fmaleev/RC-Foiling-Cat/paper/RC_Catamaran_Paper.pdf

# Design and Analysis of a 1 m RC Beach Catamaran with a Hydrofoil Option

### Filip Maleev

Colorado College, Department of Mathematics and Computer Science

### September 2026

## Abstract

This paper describes the design of a 1 m radio-controlled catamaran with a beach-cat rig, two appendage configurations (daggerboards, or L-foils with T-foil rudder elevators), and a simplified 0.6 m version intended as a first build. The hulls are 3D-printed PETG shells with bonded bulkheads, so every printed segment is a sealed compartment. The rig follows full-size beach cats: a square-top, fully battened main on a rotating wing mast, and a jib on a forestay bridle. It is modelled parametrically in Autodesk Fusion, and a custom add-in trims it with three sliders (jib sheet, main traveler, mainsheet tension). Performance is estimated with a purpose-written velocity prediction program. It combines ITTC-57 friction, Michell thin-ship wave resistance with catamaran interference (validated on the Wigley hull), appendage and foil drag, and a depowering sail model. The displacement version reaches 2.6 m/s on a beam reach in 8 kn of wind. Its rudders need at most 2.6◦ of an available ±18◦
. The
foiling version reaches its 1.81 m/s take-off speed from about 7.1 kn of true wind, and a sensitivity study places take-off between 6.25 and 11 kn. A controllability analysis shows that the foiling version is pitch-stable but has no heave stability with fixed-incidence foils: at 4 m/s the foils lift 120 % more than the boat’s weight. It therefore needs ride-height control. A wand-driven trailing-edge flap is sized here: it makes heave stable and well damped (ζ = 1.6) while using at most 10.2◦ of flap from takeoff to 5 m/s. This result led to building the non-foiling version first, preceded by a costed 0.6 m version ($248.26 in parts). A flight simulator built on the same physics, extended with the boat’s trim in heave and pitch, then searched 306,180 foil designs. At speed the sail drive’s bow-down couple makes the elevators push down. With a fixed positive incidence they do so by pitching the boat nose-down until they leave the water, so neither the original foils nor a first optimized set would fly. The adopted v2.3 foils set the elevators at −0.5
- and 18 mm lower, and
reach 4.53 m/s on a beam reach in 12 kn of wind with the boat level.


Figure 1: The 1 m design in Autodesk Fusion: build-first version with daggerboards (left) and foiling version with the v2.3 L-foils and T-foil rudders (right).

## 1 Introduction

Beach catamarans such as the Hobie 16 and the Olympic Nacra 17 combine two slender hulls, a large, fully battened rig and, on the Nacra 17, foils that lift the boat clear of the water. The goal of this project was a radio-controlled model that is faithful to that type, can be built with a desktop 3D printer and off-the-shelf RC parts, and whose behaviour can be predicted before it is built. Three questions shaped the work: (i) how closely can a 1 m model follow full-scale rig proportions; (ii) will the foiling version actually take off before it has to be depowered; (iii) will the boat be controllable. The answers set the build order: a 0.6 m simplified version first, then the 1 m displacement version, with foiling deferred until ride-height control is designed.

## 2 Design

### 2.1 Hulls and structure

Each hull is lofted through eight elliptical stations (Fig. 2, right). It is 1000 mm long, at most 80 mm wide and 108 mm deep, and the hull centres are 560 mm apart. The printed hull is a 0.8 mm PETG shell. Before shelling, 2 mm slabs are cut from the solid loft at each print joint and bonded back in as bulkheads, so each 200 mm segment prints as its own sealed compartment. Enclosed crossbeam sockets, foil trunks and chainplate bosses are part of the shell. The analytic hull volume from the sta-

Table 1: Rig proportions.

| Hobie 16 | Nacra 17 | This boat
Mast height / LOA | 1.60 | 1.71 | 1.37
Main : jib area | 2.7 | 3.7 | 3.2
Sail area / LOA² | 0.74 | 0.68 | 0.40

tion table matches the CAD loft to within 0.20 %.

### 2.2 Rig: following real beach cats

Table 1 compares the rig with the Hobie 16 and Nacra 17 [1, 2]. The main-to-jib ratio (3.2) lies between the two, and the planform follows their square-top main with 8 full-length battens. The rest also comes from the full-size boats: a rotating wing mast (24 x 14 mm fairing on a 12 mm carbon tube), a forestay bridle to both bows, a traveler on the rear beam, and a jib car on a short track (on the pod lid here, because the pod sits over the front beam). All the fittings are printed: transom gudgeons, Trail tracks with sliding cars, a hounds collar whose groove carries the loop the stays tie to (so the mast turns inside it), a mast cap that seals the tube, a bridle post and a gooseneck. The fairing is printed as 0.45 mm shells in seven pieces, and the main’s luff is laced to its trailing edge. Sail area and mast height, however, cannot follow geometric scaling. For a scale factor λ, righting moment scales as λ

4
(weight λ

3
times beam λ). In the same wind, the heeling moment of a similar rig scales only as λ
| | | 3
(area
λ

2
times height λ). A 1:5 model with full-scale proportions would therefore be over-canvassed, so sail area was set by the VPP instead (Section 4).
The three real-cat controls map to three RC channels and to three sliders in a Fusion add-in written for this project. Jib sheet sets the jib angle. Main traveler sets the boom angle and moves the traveler car. Mainsheet tension sets the main’s twist, from 30◦
loose to 3
- hard,
and its depth, from 13 % to 8 %. The sails and wing mast are loft and extrude features on batten-station sketches. The add-in moves the sketch points, so the parametric model re-solves; booms, sheets and cars are updated as base-feature bodies.

### 2.3 Appendages and foils

The rudders are balanced NACA 0012 blades (45 mm chord, pivot at 25 % chord) linked by a tie bar. The build-first version has NACA 0012 daggerboards; the foiling version replaces them with L-foils: a NACA 0012 strut (60 mm chord) and a NACA 4412 wing (50 mm chord, 180 mm span per side) at 1.5◦
incidence. Rudder T-foil
elevators (NACA 0012, 28 mm chord, 160 mm span) sit at −0.5

◦
. The foiling rudders are 18 mm longer than the build-first ones, so the elevators sit at z = −215 mm. These are the v2.3 foils chosen with the flight simulator (Section 6). They replace the original v2.0 set (wings

200 x 60 mm at 2

◦
, elevators 150 x 36 mm at 3

◦
), a first optimized set (v2.1) that the trim model showed would not fly, and v2.2 (wings 160 x 45 mm, elevators 120 x 28 mm at −1

◦
), which lost its pitch static margin when the CAD masses were corrected. Every result in this paper is for v2.3 unless stated otherwise. An early layout placed the main foils 100 mm deeper than the elevators. Because the elevators would breach first, that extra depth added weight and drag but no ride height, so the wings were moved up to the elevator depth, saving 73 g of carbon.

## 3 Analysis methods

### 3.1 Mass properties and hydrostatics

Masses come from the CAD volumes, with densities or manufacturer weights for bought parts; assumptions are listed in the project README. Displacement and the centre of buoyancy are integrated over the station table with a natural cubic spline, and the flooded foil trunks are subtracted.

### 3.2 Resistance

Hull friction uses the ITTC-57 line with a form factor (1 + k) = 1.25:

RF =

1/2 ρV ²S CF (1 + k), CF =

0.075
(log10 Re − 2)²

. (1)

Wave resistance uses Michell’s thin-ship integral [3, 4, 5] for a hull with half-breadth Y (x, z):

RW =

4ρg²
πU²

∫ ∞

1

(
I

2 + J

2

) λ
2 Fc(λ)
√
λ² − 1

dλ, (2)

I +iJ =

∫ ∫ ∂Y
∂x e

λ

2k0z
e

iλk0x

dx dz, k0 = g/U²
, (3)

where Fc = 4 cos²

(
k0λ

√
λ² − 1 s/2

)
accounts for interference between hulls a distance s apart (Fc = 1 for a single hull). The substitution λ = cosh u removes the endpoint singularity. ∂Y /∂x is taken as constant on each panel, and the exponential factors are integrated exactly in x and z (a Filon-type rule), which keeps the integral accurate at low Froude numbers. The integration was checked on the Wigley parabolic hull (L/B = 10, L/T = 16, Fig. 3): doubling the grid changes CW by less than 0.03 %, and the curve shows the expected humpand-hollow shape. Thin-ship theory is reported to overpredict near the main hump [4], so wave drag here is, if anything, pessimistic. A transom term follows Holtrop and Mennen [6]. Wave resistance, wetted area, waterline length and draft are tabulated once for each hull shape, over the load the hulls carry (0–3.6 kg in 0.2 kg steps) and the speed (0.1–4.5 m/s in 0.1 m/s steps), for both hulls together and for one hull. The VPP and the flight simulator interpolate the same table; against direct

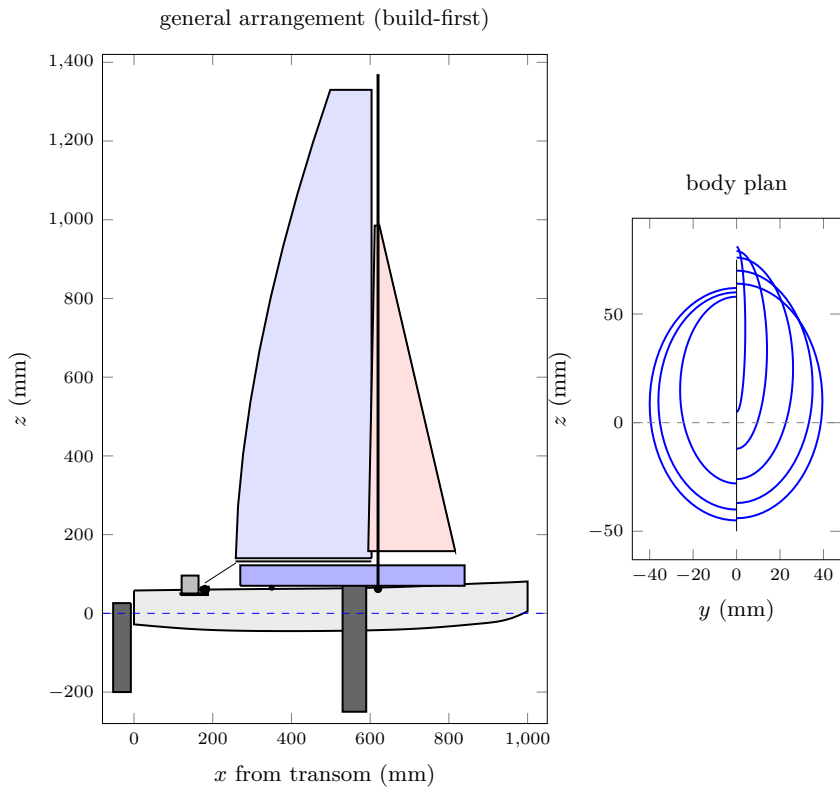
[picture p6: figure]
x from transom (mm); general arrangement (build-first); body plan

Figure 2: Left: general arrangement of the 1 m build-first boat (hull, the three crossbeams, pod, rudder-servo bracket and cover on the rear beam, daggerboard, rudder, rotating mast, boom and mainsheet to the traveler, square-top main and jib; dashed line: reference waterline). Right: body plan of the hull, eight elliptical stations (aft half on the left, forward half on the right).

evaluation, the interpolated hull drag differs by less than
1 %. Appendage profile drag uses the ITTC line with Hoerner’s thickness factor 1 + 2t/c + 60(t/c)

4 and a spray
term 0.24 q t²
[7]. The ITTC line assumes turbulent flow from the leading edge. At the foils’ chord Reynolds numbers (1–2 × 10⁵
) much of the flow may be laminar, so a sensitivity case replaces it with the flat-plate laminar line CF = 1.328/

√
Re (Prandtl–Schlichting with transition above Re = 5 × 10⁵
), about half the turbulent value. This is an optimistic bound: a laminar separation bubble adds drag that a flat plate does not have. Induced drag is Di = L

2/(qπeb²
), applied both to foil lift and to the side force carried by boards and rudders.

### 3.3 Foils and sails

Foil lift uses the thin-airfoil zero-lift angle, αL0 =
−

1
π

∫ π

0

dyc
dx (cos θ − 1) dθ = −4.15◦
for NACA 4412, and
the lifting-line slope a = 2π/(1 + 2/(e AR)) with e = 0.85 [8]. The sails produce Fx = qaA(CL sin β − CD cos β) (drive) and Fy = qaA(CL cos β + CD sin β) (heel), with CD = CD0 + C

2
L

/(πesARs), CL,max = 1.3 and CD0 =
0.05. CL is reduced (the sails are flattened) whenever Fyh would exceed 90 % of the maximum righting moment
0.2 | 0.3 | 0.4 | 0.5 | 0.6

0

2

4

Froude number F n

10

3 C

W

Figure 3: Michell wave-resistance coefficient of the Wigley hull from this project’s code (grid-converged to 0.03 %).

W s/2. The sails are also eased (both forces scaled down) whenever the bow-down moment Fxhp would exceed 90 % of the largest longitudinal righting moment the hulls can provide (Section 4.4); hp is measured from the centre of effort to the hull resistance centre. Beyond a beam reach the model blends to a stalled sail (CD → 1.2). The VPP marches boat speed up from rest until drive equals drag; for the foiling version it switches to the flying branch once both foils can carry their share of the weight. Below takeoff the wand holds the flaps fully down, so the main foils’ lift (and its induced drag) uses the full 15◦ of flap (Section 5). Every foil lift coefficient is capped at 0.8, i.e. 0.8 of an assumed section maximum of 1.0 near Re = 10⁵ .

### 3.4 Flying trim in heave and pitch

Once flying, the foils must carry the weight and also balance the pitching moment. The sail drive F equals the flying drag. It acts at the sail centre of effort, while the drag acts at the appendages, so the boat feels a bow-down couple M = F (zCE − zD), with zD the drag-weighted height of the appendage forces. Moment balance about the centre of gravity gives the foil loads

Le =

W a − M
a + c
, | Lm = W − Le, | (4)

where a and c are the distances from the CG to the main-foil and elevator quarter chords. The couple moves load from the elevators to the main foils, and at speed the elevators must push down. The fixed-incidence elevators then set the pitch, θ = Le/(qSeae) − ie, and the wand-driven flaps make up the main foils’ lift. The wand is hinged at the bow with its tip on the water, and its angle is read in the boat frame, so the bow height is hp = Lsin(ϕ0−δ/G−θ). The depth of every appendage follows from hp and θ, and the strut and rudder drag use those immersed lengths. A speed belongs to the flying range when:
- both foils stay within the usable lift coefficient and the flaps within ±15◦
;
- the main foils and elevators stay at least half a chord deep;
- at least 30 mm of rudder stays in the water (an assumed immersion limit);
- the rudders, at their trimmed immersion, can hold the largest side force the sails can apply before the boat heels out, using at most 80 % of their ±18◦ throw (the reserve is assumed);
- the hulls stay clear.
Take-off is the lowest such speed. Above the range the sails must be eased, and the VPP caps the speed there. Roll. Flying, the boat resists heel only by moving lift to the leeward foil. With the leeward wing at its flap and lift limit L1 and the windward one carrying the rest of Lm, the foils’ largest righting moment is RMf = (2L1 − Lm) s/2. At the take-off speed both wings are at that limit, so RMf = 0; it reaches W s/2 only as speed builds. Any larger heeling moment M is taken by the leeward hull, which then carries N = (M − RMf )/s and adds its single-hull resistance (friction, transom and Michell wave drag for one hull). The boat counts as flying only when N = 0; otherwise it is skimming. While skimming, the VPP also eases the sails (scales their lift down) whenever that gives more net thrust, as a sailor would to get onto the foils.

Table 2: Mass properties and hydrostatics.

| 1 m build-first | 1 m foiling | 0.6 m mini
Mass (g) | 2114 | 2373 | 755
Hull draft (mm) | 29.3 | 30.8 | 23.8
LCG / LCB (mm) | 450 / 432 | 454 / 433 | 258 / 262
One-hull buoyancy / weight | 2.64 | 2.35 | 2.05
Max righting moment (N m) | 5.81 | 6.52 | 1.26
Sail area (m²
) | 0.401 | 0.401 | 0.144
0 | 0.5 | 1 | 1.5 | 2 | 2.5 | 3

0

2

4

6

Boat speed V (m/s)

Resistance (N)

build-first (total)

foiling (total)

build-first wave | (Michell)
build-first hull | friction

Figure 4: Resistance at zero side force. The foiling curve peaks just before take-off (1.81 m/s) and drops once the hulls leave the water.

### 3.5 Controllability

Steady yaw balance requires the rudders to cancel M = Fy(xCE − xCLR) + Rhull u s/2, where u is the fraction of righting moment in use; the second term is the extra drag of the loaded leeward hull. The rudder force Fr = M/(xCLR − xr) is converted to a rudder angle with the lifting-line slope, and the windward rudder is taken as clear of the water for u > 0.8. Foil pitch stability uses the neutral point xnp = (amSmxm + ηaeSexe)/(amSm + ηaeSe) with η = 1 or 0.65 to bracket downwash on the elevators.

## 4 Results

### 4.1 Mass and hydrostatics

Table 2 lists the three boats. The heaviest items on the 1 m build-first boat are the hulls (783 g), the centre pod (336 g) and the RC electronics (315 g); the foiling kit adds 422 g. The design target was that one hull alone could float at least twice the boat’s weight; all three versions meet it.

### 4.2 Resistance and speed

Figures 4 and 5 show the predicted resistance and speed. Hull friction and appendage drag dominate the build-first boat; Michell wave drag stays below 0.43 N up to 3 m/s because the hulls are slender (L/B = 12.5). Below takeoff, the foils cost the foiling version 28–31 % of its speed. The foiling version takes off from about 7.1 kn of true

4 | 6 | 8 | 10 | 12 | 14 | 16

0

2

4

True wind speed (kn)

Boat speed (m/s)

build-first, TWA 90◦

build-first, TWA 60◦

foiling, TWA 90◦

foiling, TWA 60◦

Figure 5: Predicted boat speed. The jump in the foiling curves is take-off. The build-first boat must depower above about 8– 9 kn.

Table 3: Take-off speed and the lowest true wind (kn) at which the foiling version takes off.

Scenario | Vto (m/s) | TWA 60◦ | TWA 90◦
baseline | 1.81 | 9 | 7.25
sail CLmax 1.1 | 1.81 | 9 | 7.75
sail CLmax 1.5 | 1.81 | 9 | 6.75
foil lift -20% (low Re, free surface) | 1.94 | 10.5 | 7.25
mass +10% | 1.90 | 9.5 | 7.5
mass -10% | 1.72 | 8.75 | 7
sail-drive pitch couple x0.5 | 1.71 | 8.25 | 7
sail-drive pitch couple x1.5 | 2.00 | 11 | 7.5
foil friction laminar (low Re) | 1.76 | 7.25 | 6.25

wind, which is below the 8–9 kn where the rig starts to depower, so a usable foiling window exists. Table 3 shows that this conclusion holds across the least certain inputs.

### 4.3 Controllability

Build-first version. Over 4–14 kn and TWA 60–105◦ the rudders need at most 2.6◦

(TWA 60◦
, 8 kn, one rudder
working) of the ±18◦
that the linkage gives. That leaves at least 77 % margin to stall, and the servo torque needed is below 0.10 kg cm.
Foiling version. Steering while flying needs at most 4.8◦
, with 63 mm of rudder immersed in that case (from the flying trim). The foil system is statically pitch-stable: the CG lies 41–97 mm ahead of the neutral point. Heave is the problem (Fig. 6). With fixed incidence, lift grows as V

2 while weight is constant, so nothing sets the flying height: the boat would climb until a foil breaches and ventilates, then drop. Holding height requires the main-foil angle to change by +2.1◦ at 2 m/s but -3.7◦ at 4 m/s. If the boat is also free to pitch, the fixed-incidence elevators trim it nose-down as speed rises. That reduces the excess but does not remove it, and nothing still ties lift to height, so heave stays neutral. Ride-height control is therefore required before the foiling version can fly under control (Section 5).

2 | 2.5 | 3 | 3.5 | 4

−50

0

50

100

Boat speed (m/s)

Lift excess over weight (%)

−4

−2

0

2
Foil angle change (

◦

)

Figure 6: Fixed-incidence foils: lift in excess of weight (solid, left axis) and the main-foil angle change needed to hold height (dashed, right axis).

Table 4: Bow-volume variants of the 1 m hull (B adopted as v1.3). Pitchpole limits in kn at TWA 60/90/120◦
Variant | RML 1 hull (N m) | RML 2 hulls (N m) | Drag at 2 m/s (N) | ∆m (g) | Pitchpole (kn)
baseline | 2.92 | 4.29 | 3.514 | +0 | 9.5 / 9 / 10.5
A | 3.12 | 4.32 | 3.517 | +7 | 10.5 / 9 / 11
B | 3.59 | 4.72 | 3.527 | +13 | >20 / 9 / 11
C | 3.96 | 4.90 | 3.535 | +20 | >20 / 9 / 11.5

### 4.4 Static stability and pitchpole

Heel. The transverse righting arm (Fig. 7) comes from clipping the heeled elliptical sections of both hulls at the waterline, with the waterline height solved so displacement equals weight. The 1 m build-first boat reaches its largest righting arm, 270 mm, at 6◦ of heel, when the windward hull lifts. The maximum righting moment, 5.59 N m, is within 4 % of the W s/2 used in the VPP, which confirms that assumption. The boat capsizes at about 80◦

(mini: 80◦
).
Pitchpole. A catamaran more often trips over its bows than capsizes sideways. Tilting the waterline bow-down and re-solving the sinkage gives the largest longitudinal righting moment the hulls can provide before the bows go under: 5.04 N m on both hulls and 3.85 N m on one hull (the windward hull flying). Setting that equal to the sails’ bow-down moment gives the wind above which the sails must be eased on each point of sail. For the 1 m boat that is >20 / 9.5 / 11.5 / 16.5 kn at TWA 60/90/120/150◦
, and
for the mini 7.5 / 8.5 / 10 / 13.5 kn. These limits sit close to the heel limits, so pitch-limited depowering was added to the VPP.
Design iteration: bow volume. Table 4 compares the original hull with three variants that add volume only to the forward stations, mostly above the waterline. Variant B was adopted as the v1.3 hull. It raises the one-hull pitch limit by 23 % for 13 g and a 0.4 % drag increase at 2 m/s. Variant C adds little more for 50 % more weight.

### 4.5 Foil structure

With the largest main-foil flight load, which occurs at speed when the elevators push down, all on one wing

0 | 20 | 40 | 60 | 80

−100

0

100

200

Heel angle (◦
)

Righting arm GZ (mm)
1 m build-first

0.6 m mini

Figure 7: Transverse righting arm from the heeled hull geometry. It peaks when the windward hull lifts; the curve crosses zero at the capsize angle.

Table 5: L-foil structural check (v2.3 foils).

Material | Root stress | Tip deflection | Strut rotation
CFRP (E = 70 GPa) | 44.4 MPa | 1.52 mm | 1.00◦
Printed PETG (E = 2 GPa) | 44.4 MPa | 53.08 mm | 35.17◦

under a 2 g gust (68.7 N; root moment 6187 N mm), the section properties computed from the NACA coordinates give the results in Table 5. Printed PETG is strong enough but far too flexible, so the foils must be carbon. A home-buildable alternative to solid carbon is a printed core with unidirectional carbon caps (4 layers of 0.127 mm tape, 25 mm wide, on each face). Taking E ≈ 120 GPa for the cap laminate (assumed), centring the caps on the thickest point and ignoring the core, the caps give 59 % of the solid-carbon bending stiffness: tip deflection 2.55 mm and cap stress 125 MPa in the load case above. The v2 foiling kit (cores, carbon tape, laminating epoxy, flap hinges, wands and linkage) costs $101.17.

### 4.6 Rig and crossbeam loads

The largest steady side force the sails can apply is set by the righting moment, F = RMmax/h with h the heeling arm; beyond it the boat heels and sheds load. Carried by a mast pinned at the step and held by the windward shroud at the hounds, this force gives the shroud tension. The jib’s share (by area), on a forestay with an assumed 2 % sag, gives the forestay tension, and the vertical components of both compress the mast. A harder case is the sheet servo at its stall torque (spec-sheet values at 4.8 V), for example with the sheet held in against a stop. The mast is checked for Euler buckling between step and hounds. Each crossbeam is checked as a simply supported tube loaded at mid-span. On the 1 m boat the mainsheet runs from the traveler car up to the boom and back (the loop that keeps the traveler from pulling on it), so the boom, the car and the rear beam carry twice the tail tension. With the tail 15 mm from the servo shaft this failed the factor-of-2 rule (front beam 1.7, mast 2.0); the tail now attaches 25 mm from the shaft. The printed traveler car is checked the same way: its lips under the rail head bend as cantilevers, with an assumed 25 MPa bending strength for printed PETG. On the mini, the box levers the sheet load onto both beams. Table 6 lists the results. E = 70 GPa and a bending strength of 300 MPa are assumed for the carbon tubes, since no values are published for the tubes used.

Table 6: Rig and crossbeam loads (sails at the heel limit; “stall” adds the sheet servo at stall torque).

1 m build-first | Mini
Side force at the heel limit (N) | 8.3 | 2.9
Shroud / forestay tension (N) | 17 / 12 | 5.9 / 4.3
Mainsheet at servo stall (N) | 55 | 34
Mast compression, sailing / stall (N) | 28 / 138 | 10 / 44
Mast Euler load (N) / safety at stall | 423 / 3.1 | 107 / 2.4
Front beam: MPa / mm / safety | 116 / 5.4 / 2.6 | 54 / 1.5 / 5.6
Rear beam: MPa / mm / safety | 92 / 4.3 / 3.2 | 40 / 1.1 / 7.6
Traveler car on its rail: uplift (N) / safety | 110 / 3.2 | –
Pod beam, 5 g: MPa / mm / safety | 35 / 2.6 / 8.7 | –

The sailing loads are small: the sheet servos, not the wind, set the structural load case. With its first 8 x 7 mm beams (0.5 mm wall), the mini’s front beam reached a safety factor of only 2.0 in the stall case and deflected 5.2 mm. It now uses 10 x 8 mm tube, which costs $1.05 less, for 18 g more.

## 5 Ride-height control

Each L-foil wing gets a trailing-edge flap of 25 % chord (12 mm) from 10 mm inside the tip to the strut, 166 mm of the 180 mm span. A carbon wand hinged at each bow trails on the water and drives that hull’s flap through a deck pushrod, a bellcrank and a rod inside the strut. Each foil therefore regulates its own height, which also adds roll stability. Thin-airfoil theory gives the flap effectiveness

τ = 1 −

θh − sin θh
π
, | cos θh = 2E − 1, | (5)

so τ = 0.609 for E = 0.25; 0.487 is used after a 20 % viscous reduction. The wand is 300 mm long at 49◦
, so
its angle changes by 5.08 rad per metre of height. The linkage gearing is 1.5◦ of flap per degree of wand.
Trim. At each speed the elevators set the pitch and the flaps make up the main foils’ lift, with the sail-drive couple included (Section 3.4). From take-off at 1.81 to 5.0 m/s the flap angle stays between −6.8
- and 10.2

◦
, inside the ±15◦
travel (Fig. 9). The boat pitches between −0.3
- and +0.4

◦
(nose up +), and the bow flies −26 to +16 mm from its design height.
Heave stability. Linearised heave dynamics are
mh¨ + c h˙ + k h = 0, | (6)

c =

q(Smam + Seae)
V
, | k = q Smam τ G dϕ
dh, | (7)

where c comes from the change of foil angle of attack with vertical velocity (h/V ˙ ) and k from the wand feedback. With fixed foils k = 0, so nothing restores height.

With the wand, k rises from 458 to 3174 N/m and the natural frequency from 2.2 to 5.8 Hz. Because c ∝ V and √
k ∝ V , the damping ratio is the same at every speed, ζ = 1.6 (over-damped): disturbances die out without oscillating. A time-domain run of the same model (analysis/foil_checks.py) confirms this: across the flying range a 20 mm height disturbance decays to 5 % in 0.24–0.62 s with no overshoot, while with fixed foils it does not decay at all. The same script checks the trim over the flying range up to the 12 kn beam-reach speed: the elevators stay at least 1.55 chords deep, the main foils 1.02 chords, and at least 46 mm of rudder stays in the water. At take-off, with the flaps fully down, the main foils need CL = 0.80. 28 of 28 foil checks pass.
Heave and pitch together. The wand sits a metre ahead of the elevators, so heave and pitch are coupled: the wand reads the bow height and the boat-frame angle, and each foil feels the vertical velocity of its own station, h˙ + l

˙θ. Linearising both degrees of freedom about the trim, with the pitch inertia from the CAD model (Iyy = 0.243 kg m²
, radius of gyration 320 mm), gives a fourthorder system (analysis/pitch_heave.py). Across the flying range it is stable (Routh–Hurwitz), with one oscillating mode at 1.6–7.0 Hz and damping ratio at least 0.69 (0.66 with an elevator efficiency of 0.65), and two nonoscillating decaying modes. That is less damping than the heave-only estimate (ζ = 1.56), but the motion stays well damped. With fixed foils one root sits at zero: heave stays neutral. Unsteady lift, added mass and downwash lag are left out.
Take-off in time. | The trims above are equilib-
ria. | The transition was also integrated in time
(analysis/takeoff_sim.py): surge, heave and pitch with RK4 in 2 ms steps, hull buoyancy from the stations at the instantaneous attitude, the wand and flap stops, foil lift fading over the last half chord below the surface, and sail drive from the VPP (the boat is held flat). From rest in 8 kn on a beam reach the hulls leave the water after 2.4 s. The bow then rises at most 11 mm above its design height, the elevators stay at least 48 mm deep, and the boat settles at 3.72 m/s, matching the VPP’s steady speed (Fig. 8). A 4 kn gust for 5 s while flying in 9 kn raises the bow at most 16 mm and leaves the elevators at least 41 mm deep; no foil breaches. Hull damping when afloat is an assumed 30 % of critical; it only affects the hull-borne phase.

## 6 Foil design with the flight simulator

The VPP answers whether a given design flies; to ask which foils fly best, it was turned into an interactive flight simulator (a web page, sim/foil_sim.html). Its physics are the VPP’s, including the flying trim of Section 3.4: the Michell wave resistance is tabulated against boat speed and the weight the hulls carry, and every other

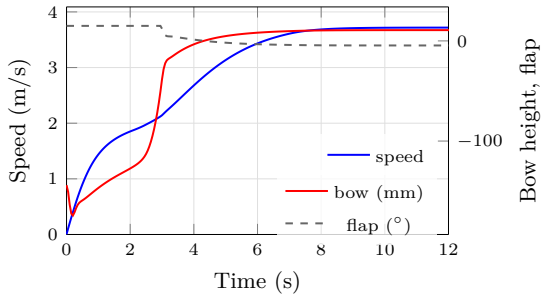
[picture p7: figure]
Time (s); Speed (m/s); speed; bow (mm) flap; Bow height, flap

Figure 8: Take-off from rest in 8 kn on a beam reach (time-domain simulation): boat speed, bow height relative to the design ride height, and flap angle. The flaps sit on their +15◦ stops until the boat rises.

2 | 2.5 | 3 | 3.5 | 4 | 4.5 | 5

−5

0

5

10

Boat speed (m/s)

Angle (

◦

)

flap angle

boat pitch

Figure 9: Wand-controlled flight across the flying range: flap angle and boat pitch from the trim of Section 3.4, sail-drive couple included. Flap travel is ±15◦

term is computed live. At the CAD design it reproduces the Python VPP’s boat speed to 0.00 m/s in all 12 reference cases (build-first and foiling, 6–10 kn, 60 and 90◦ ).
It adds:
- foil span, chord and incidence, and the elevator height, as inputs;
- foil and rudder mass and the resulting shift of the centre of gravity, with the densities of the CAD mass export;
- the wand-driven flaps: fully down below take-off (they add induced drag there), then trimmed to hold ride height;
- a cap on the usable foil lift coefficient of 0.8 (0.8 of an assumed section maximum of 1.0 near Re = 10⁵ ).

A first search, and why it was withdrawn. A first search was run before the trim model existed. It assumed each foil pair carried a fixed share of the weight at level attitude, so the elevators set the take-off speed. It recommended smaller foils with the elevators at 4

◦
(v2.1: wings
160 x 40 mm at 0

◦
, elevators 140 x 32 mm at 4

◦
), and these
were drawn in CAD. The trim model reverses that result. At 4.5 m/s the v2.3 foils must balance a 6.0 N m bow-down couple, more than the elevators’ share of the weight times

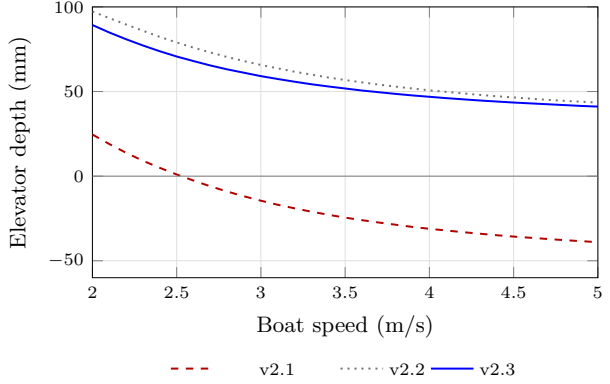
[picture p8: figure]
Boat speed (m/s); Elevator depth (mm)

water surface

Figure 10: Elevator depth from the flying trim, sail-drive couple included. The v2.1 elevators at +4◦ pitch the boat nose-down and come out of the water; the v2.3 elevators at −0.5

◦
,
18 mm lower, stay in. (The v2.1 curve is shown where no feasible trim exists, to show why.)

the foil spacing, so the elevators must push down. Fixed at +4◦
, they can only do that by pitching the whole boat nose-down. The stern, a metre behind the wand that holds the bow, then rises until the elevators leave the water: for v2.1 the elevator reaches the surface at 2.6 m/s (Fig. 10). Neither the original v2.0 foils nor v2.1 has any speed at which the trim is feasible: as drawn, they would not fly.
The search with the trim model. The search was repeated with the trim model and with the elevator height as a variable (the rudder blades end 3 mm below the elevators). A grid of 306,180 designs covered:
- main-foil span 140–300 mm and chord 40–80 mm, at 0, 1 or 2◦
;
- elevator span 100–260 mm and chord 28–52 mm, at 0–2◦
;
- elevator height z = −215 to −275 mm (the v2.1 elevators sit at −197 mm).

Incidences from −1 to 3

- and the height were then refined for the best sizes. A design counts as feasible when:
- root stress with the largest flight load of a foil pair on one foil at 2 g stays within 100 MPa (safety 3 on an assumed 300 MPa), and main-foil tip deflection within 2 mm;
- both foils see a chord Reynolds number of at least 5× 10⁴ at take-off (an assumed threshold, below which thin-airfoil lift is optimistic);
- heave damping with the wand gearing of Section 5 is at least ζ = 0.5;
- the pitch static margin is at least 30 mm with an elevator efficiency of 0.65 (about 5 % of the 590 mm foil spacing, assumed);
- the boat flies at 12 kn on a beam reach, with the flying range reaching at least 5 % above that speed. Feasible designs tended to sit on these limits. Nose-down pitch lifts the rudders and struts out of the water and cuts their drag, which the model rewards and a gust would punish. The adopted design therefore also needs operating margins at the 12 kn speed: main foils and elevators at least one chord deep, at least 45 mm of rudder in the water, and a flying range reaching 10 % above that speed. It must also be robust: it must still fly, without hitting the top of the flying range at 12 kn, with the sail-drive couple halved or 1.5 times larger and with the CG 20 mm forward or aft. Of 78,717 feasible designs, 12,340 had the margins and 11,645 were also robust. Among robust designs within 5 % of the fastest, the rule picks the one needing the least wind to fly, averaged over 60 and 90◦ .
The design in CAD stays adopted while it passes every check and needs at most 0.1 kn more wind than the rule’s pick. That tolerance is below the model’s resolution (see below), and in this run the difference is +0.00 kn.
v2.3. The foils first adopted from this search (v2.2: wings 160 x 45 mm at +1.5

◦
, elevators 120 x 28 mm at −1

◦
) were
drawn in CAD. Correcting the CAD masses (the printed fittings and mast fairing, and music-wire rudder parts that had been weighed as aluminium) added 89 g and moved the centre of gravity about 7 mm aft. That cut v2.2’s pitch static margin to 24 mm, under the limit, and the rerun search picked larger foils. The adopted foils are wings of 180 x 50 mm at +1.5
- and elevators of
160 x 28 mm at −0.5

◦
, set 18 mm lower than before (Table 7). The negative elevator incidence is the key change. At 12 kn the elevators push down 5.8 N with the boat at −0.3
- of pitch, instead of pitching the boat nose-down to get there. In the simulator the boat takes off at 1.81 m/s, from 7.1 kn on a beam reach and 8.9 kn at 60◦
. It reaches
4.53 m/s at 12 kn, and its flying range extends to the end of the scan (6 m/s). The original v2.0 sizes cannot be re-trimmed into the feasible set: whatever the incidences and elevator height, their static margin is at most 23.0 mm, just under the 30 mm limit. The v2.1 sizes cannot be rescued. Once the elevators push down, the main foils carry the weight plus that downforce, and in 2577 of the 3213 re-trims tried the 40 mm-chord wing bends past the 2 mm limit.
The simulator interpolates the wave-resistance table, which smooths the drag hump just before take-off. Its take-off winds for v2.3 are therefore 0.02 and 0.01 kn below the VPP’s (7.11 and 8.95 kn at 90 and 60◦
). Once the
boat is flying the two agree. Roll near take-off. With the adopted foils the boat flies from 7.1 kn on a beam reach but needs 8.9 kn at 60◦
(simulator), because at takeoff both wings are at their lift limit and the larger side force has to go onto the leeward hull (Section 3.4). More flap travel does not help: with ±25◦

instead of ±15◦
the
take-off winds are unchanged, because the usable lift coefficient, not the flap stop, limits the leeward wing. What does help is technique. Taken off on a beam reach and

Table 7: Foil sets with the trim model (flight simulator, auto trim; take-off wind to 0.01 kn). v2.0 and v2.1 have no feasible flying trim; their speeds are hull-borne (h). v2.2 was built in CAD before the mass correction and now fails the static-margin limit; v2.3 is adopted and in CAD. The light-wind design needs the least wind among robust designs within 15 % of the fastest; the speed design is the fastest robust design.

| v2.0 (original) | v2.1 (first search) | v2.2 (before mass fix) | v2.3 (adopted) | Light-wind design | Speed design
Main foil, span x chord (mm), incidence | 200 x 60 at 2
- 160 x 40 at 0
- 160 x 45 at 1.5
| | | | ◦ 180 x 50 at 1.5 | ◦ 200 x 55 at 0
- 140 x 40 at 2

◦
Elevator, span x chord (mm), incidence | 150 x 36 at 3
- 140 x 32 at 4
- 120 x 28 at −1
| | | | ◦ 160 x 28 at −0.5 | ◦ 200 x 36 at 0
- 100 x 32 at 0.5

◦
Elevator height z (mm) | -197 | -197 | -210 | -215 | -215 | -235
Sailing mass (g) | 2453 | 2322 | 2331 | 2373 | 2446 | 2316
Take-off speed / flies to (m/s) | – | – | 2.02 / 6+ | 1.81 / 6+ | 1.69 / 6+ | 2.30 / 6+
Wind to fly at 90 / 60◦
(kn) | – | – | 7.30 / 10.69 | 7.09 / 8.94 | 7.06 / 8.63 | 7.64 / –
Speed at 8 / 12 kn, beam reach (m/s) | 2.83 h / 3.59 h | 3.15 h / 3.81 h | 3.87 / 4.71 | 3.71 / 4.53 | 3.31 / 4.25 | 4.01 / 4.91
At 12 kn: pitch, flap | – | – | +0.0

◦
| | | , −6.2
- −0.3

◦
| | | | , −6.1
- −0.6

◦
| | | | | , −2.5
- −1.5

◦
| | | | | | , −3.2

◦
At 12 kn: elev. / main / rudder depth (mm) | – | – | 44 / 54 / 47 | 43 / 51 / 46 | 43 / 55 / 46 | 44 / 44 / 47
Root stress main / elev. (MPa) | – | – | 50 / 44 | 44 / 71 | 41 / 54 | 59 / 20
Main tip deflection (mm) | – | – | 1.51 | 1.52 | 1.58 | 1.53
Static margin (mm), heave ζ | 23, 1.64 | 66, 1.48 | 24, 1.33 | 41, 1.56 | 69, 1.89 | 30, 1.21

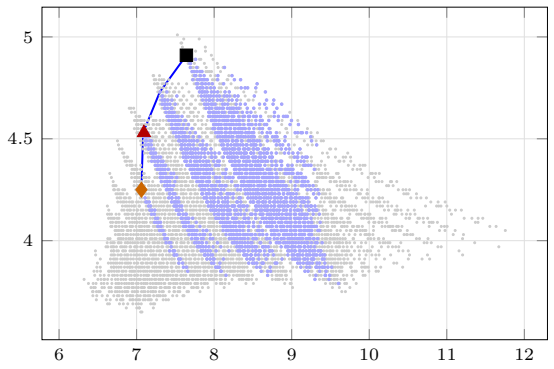
[picture p9: figure]

Wind needed to fly, beam reach (kn)

Boat speed at 12 kn (m/s)

feasible designs | robust, with margins
best robust trade-off | light-wind design
v2.3 (adopted) | speed design

Figure 11: Foil search with the trim model: every feasible design (grey), those with operating margins that are also robust (blue), and the best robust trade-off. Up and to the left is better. The adopted design also weighs the take-off wind at 60◦
, which this plot does not show.

then headed up, the boat stays flying at 60◦ down to 8.25 kn (sim/roll_options.js). At 45◦
it does not take
off below 25 kn, and once flying it cannot stay up below 16 kn.
As with the rest of the paper, these are model predictions. The drag model sets the size of the sail-drive couple, which is why the design must also work with the couple halved or 1.5 times larger (take-off at 1.71 and 2.00 m/s, flying to 6.00 and 6.00 m/s). With laminar foil friction, the optimistic bound on the drag, it takes off at 1.76 m/s and flies to 6.00 m/s. Lift near Re = 10⁵
, the
flap model and the wand gearing on the smaller foils are what the tow tests have to confirm, and the elevator incidence should be adjustable by at least ±1
- on the water.

## 7 Simplified 0.6 m version

Because the RC electronics do not shrink with the boat, geometric scaling would leave the small hulls overloaded. The mini therefore scales length by 0.6 but hull sections by 0.68, which brings one-hull buoyancy back to 2.05 times the 755 g sailing weight. One winch drives both sheets on a stepped drum. Its 30 mm and 16.2 mm grooves are sized so that the mainsheet (153 mm) and jib sheet (83 mm) reach full ease in the same 1.63 turns. The same analysis predicts 2.1 m/s on a beam reach in 8 kn of wind, and at most 1.6◦ of rudder needed. Parts cost $248.26 at September 2026 prices, with every price read from a retailer page. A build manual with 1:1 sail patterns accompanies this paper.

## 8 Design iterations driven by analysis

Several changes came directly from the checks above rather than from the first layout:

1. Foil depth. The main foils were raised 80 mm to the elevator depth, because the elevators breach first. This saved 73 g of carbon at no cost in ride height.
2. Mini hull sections. The mini’s section scale was raised from 0.65 to 0.68 so that one hull still floats at least twice the boat’s weight despite full-size electronics.
3. Stepped winch drum. The mini’s jib groove was reduced from 18 to 16.2 mm so both sheets reach full ease in the same number of turns.
4. Winch fit. The first-choice 3.5-turn winches are 50 mm tall and did not fit the 48.8 mm pod. A torque estimate showed standard-size 45 g winches carry the sheet loads with margin, which also saved 130 g and $92.
5. Bow volume. The pitchpole study led to the v1.3 hull (Table 4).

6. Pitch-limited depowering. Adding the bow limit to the VPP first produced a speed that fell as the wind rose. That was traced to the model switching to the one-hull limit, and fixed by letting the model choose, as a skipper would, between sailing flat and flying a hull.
7. Servo fit. Checking every mount against the manufacturers’ drawings found three misfits: the 40.5 mm winch cases did not fit between rails 40.2 mm apart (40 mm on the mini); the 1 m rails sat 3.5 mm below the FS5115M’s ears (27.3 mm above the case bottom); and the mini’s micro-servo rails sat 6 mm below the MG90S ear line. The rails were redrawn from the drawings with 0.3–0.4 mm clearance and a wire notch at each rail. Each winch now hangs in a 4– 6 mm well, so its drum clears the lid by 5.6–7.9 mm instead of 0.4 mm on the mini.
8. Mini crossbeams. The rig-load check (Section 4.6) replaced the mini’s 8 x 7 mm beams with 10 x 8 mm tube.
9. Rig clearance. A clearance sweep of the Fusion model over nine trims (boom and jib from 0/5◦ to
40/40◦
) showed that the original pod, which ran over both beams, blocked the traveler car for boom angles below about 7.5◦
. In that range the mainsheet from the clew (259 mm from the transom) to the car also passed through the pod lid, and the jib car sat inside the pod. The pod now ends 11 mm forward of the clew. Its aft end first hung on a printed cradle under the rear beam, but a load check showed that a cradle under the beam can only hold the pod down, not up. The aft end now rests on a light third crossbeam: 10 mm carbon, cut from the tube already bought for the mast joiner, at 350 mm from the transom, where no mainsheet position reaches. The rudder servo sits aft of the rear beam on a printed bracket, under a cover. The bracket clamps the beam from below, so the car can cross the centreline, and the jib track moved onto the lid. The same interference check found the tiller arms and ride-height wands rubbing the hulls. The tiller arms are now level, and the wands hinge ahead of the stems. The sweep is now clear at all nine trims.
10. Pitch trim (v2.2 foils). A first simulator search (v2.1) picked smaller foils with 4

◦
elevators. Adding
the trim in heave and pitch (Section 3.4) showed that the sail drive’s couple makes the elevators push down at speed, and that fixed positive-incidence elevators then pitch the boat nose-down until they leave the water: neither v2.0 nor v2.1 would fly. The search was repeated with the elevator height as a variable, a pitch static-margin limit, operating margins and robustness checks. The v2.2 foils adopted then had the elevators at −1

◦
, 13 mm lower on slightly longer rudders, and flew level at 12 kn; the mass correction below replaced them.
11. Clearance over the full trim range. A second sweep, with the printed gooseneck turning with the wing and the boom end with the boom, found two problems. A boom-end fork reaching below the boom would hit the jib car with the main eased and the jib sheeted in, so the fork moved to the gooseneck and the boom end became a single tongue. Separately, with the jib sheeted fully in (5

◦
) and the main eased
past about 31◦
, the jib sheet crosses the boom itself; the manual says to ease the jib first.
12. Print size. Every part now fits a 220 x 220 mm bed, and a design rule checks it. The pod prints in four pieces, and the daggerboards and L-foil cores in two, joined inside the hull trunks where the trunk carries most of the load. Two 1.2 mm carbon rods bonded across the daggerboard joint give 10 times the joint moment at the heel limit; on the foils, the carbon caps run across the joint.
13. Fittings and masses. Designing the printed fittings and the mast fairing replaced placeholder blocks and assumed masses. The fairing, gooseneck and boom jaw weigh 45 g, where 10 g had been assumed for the fairing. The rudder stocks, tiller arms, tie bar and pushrod had been weighed as aluminium, but they are music wire (the steel tie bar alone is 56 g). The build-first boat went from 2037 to 2114 g and the foiling boat from 2242 to 2373 g, with the centre of gravity about 7 mm further aft; every result here uses the new masses. The CG shift cut the v2.2 foils’ pitch static margin to 24 mm, under the 30 mm limit, so the search of Section 6 was rerun and picked v2.3. The traveler’s end stops also limit the boom to about 35◦ off the centre line.

These checks are now automated. After every analysis run, a design-rule script re-checks 30 rules against the results, the rig model and the CAD constants: one-hull buoyancy, rudder and foil-pitch margins, heave damping, take-off wind, rig-to-pod clearances, servo fit and drumto-lid clearance. All 30 pass. (The script first caught a stale CAD volume in the hull-volume check.)

## 9 Discussion and limitations

All performance numbers are model predictions and remain to be checked on the water. The main uncertainties are the sail coefficients (CL,max), foil lift at Re ≈ 10⁵ and near the free surface, and the form factor. Thin-ship theory also neglects sinkage, trim and spray. The yaw balance uses geometric centres of effort and lateral resistance, which is a conservative simplification. In the trim model the three sail controls are independent. On the boat this depends on the mainsheet routing. If the tail simply ran from the traveler car to the pod, moving the car would change the tail length by up to 213 mm, more than the mainsheet servo can take up. The mainsheet is therefore dead-ended on a pin in one of the traveler track’s end stops and led out of the car round a pin in the other, so any car movement shortens one side exactly as much as it lengthens the other. The sensitivity study addresses the first two uncertainties. Next steps: (1) build and GPS-log the mini and the 1 m build-first boat and compare speeds with Fig. 5; (2) build the v2.3 foils (Section 6), with an adjustable elevator incidence, and towtest them; (3) build the wand-and-flap ride-height system of Section 5 and tune its gearing on the water.

## 10 Conclusion

A 1 m RC beach catamaran was designed with printable, compartmented hulls, a real-cat rig trimmed by three sliders, and two appendage options. A validated velocity prediction program and a controllability analysis support four conclusions: the displacement version is controllable with large margins; the foiling version can reach take-off in moderate wind; with fixed foils it has no heave stability, but a wand-driven flap on each L-foil makes heave stable and well damped; and a 0.6 m simplified version is the sensible first build. A flight simulator built on the same physics, with the boat’s trim in heave and pitch, showed that the sail drive’s bow-down couple decides the elevator design: elevators at a positive fixed incidence would pitch the boat nose-down and leave the water at speed. The adopted v2.3 foils, with the elevators at −0.5

◦
and slightly deeper, fly level at 12 kn and are in the CAD model.

## References

[1] Hobie 16 specifications. https://en.wikipedia.org/wiki/Hobie_16 (https://en.wikipedia.org/wiki/Hobie_16)
[2] Nacra 17 specifications. https://en.wikipedia.org/wiki/Nacra_17 (https://en.wikipedia.org/wiki/Nacra_17)
[3] J. H. Michell, “The wave-resistance of a ship,” Philosophical Magazine, 45, 1898.
[4] E. O. Tuck, “The wave resistance formula of J. H. Michell (1898) and its significance to recent research in ship hydrodynamics,” J. Austral. Math. Soc. Ser. B, 30, 1989.
[5] N. Bagazinski and F. Ahmed, “Ship-D: Ship hull dataset for design optimization using machine learning,” arXiv:2305.08279.
[6] J. Holtrop and G. G. J. Mennen, “An approximate power prediction method,” International Shipbuilding Progress, 29, 1982.
[7] S. F. Hoerner, Fluid-Dynamic Drag, 1965.
[8] J. D. Anderson, Fundamentals of Aerodynamics, McGraw-Hill.
