fmaleev/RC-Foiling-Cat/slides/charts/elevator.pdf

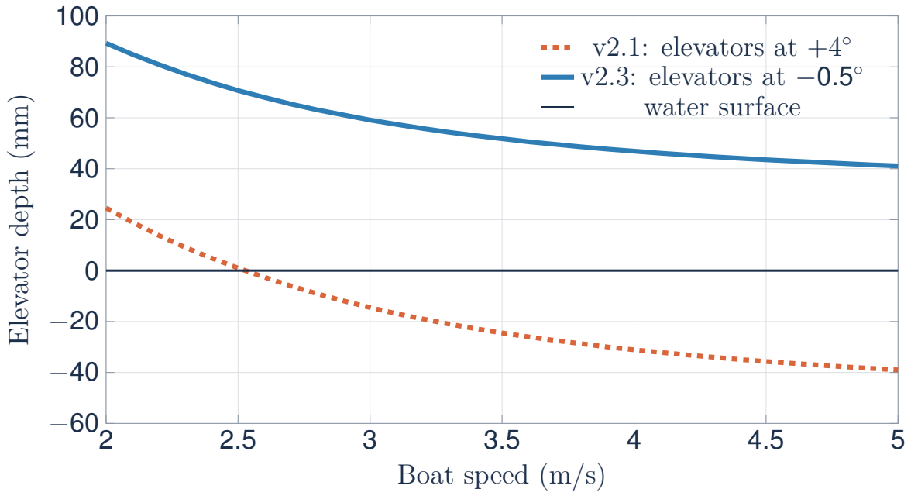
[picture p10: figure]
Boat speed (m/s); Elevator depth (mm); v2.1: elevators; v2.3: elevators at; water surface
