fmaleev/RC-Foiling-Cat/images/foiling_v1.4.png

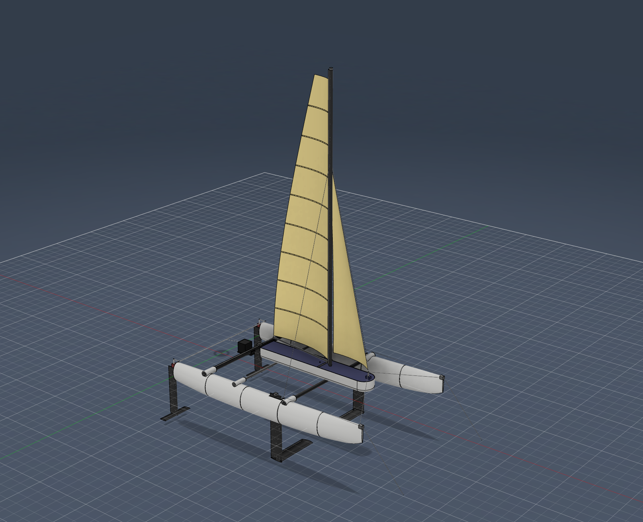
images/foiling_v1.4.png
