fmaleev/RC-Foiling-Cat/images/gooseneck.png

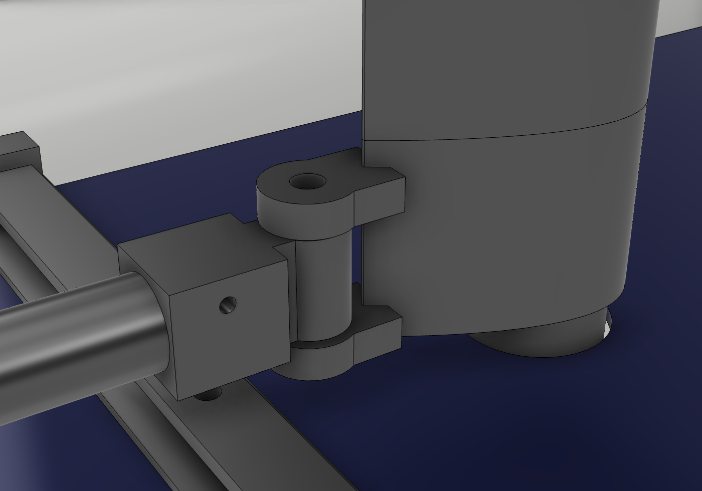
images/gooseneck.png
