fmaleev/RC-Foiling-Cat/images/gudgeon.png

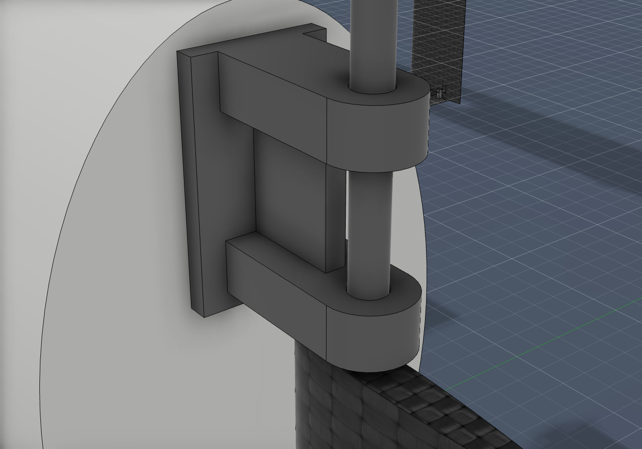
images/gudgeon.png
