fmaleev/RC-Foiling-Cat/images/hounds_collar.png

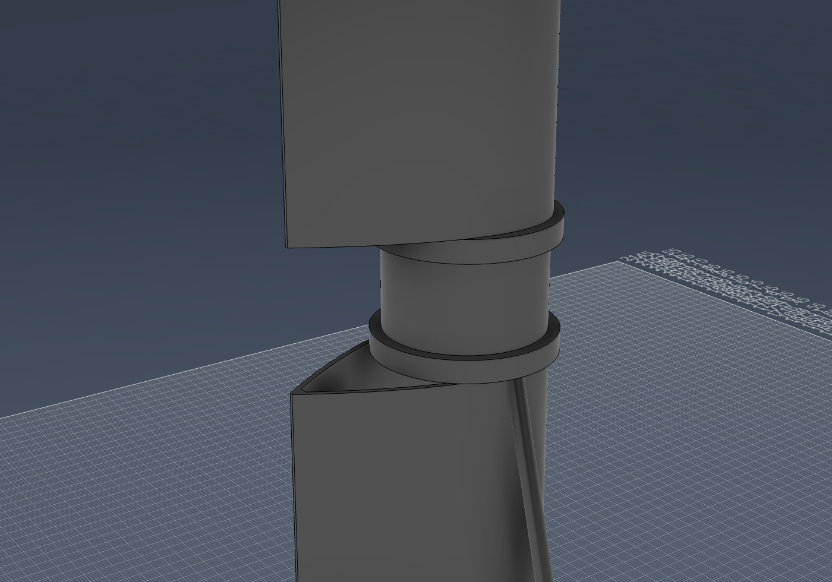
images/hounds_collar.png
