fmaleev/RC-Foiling-Cat/images/traveler_car.png

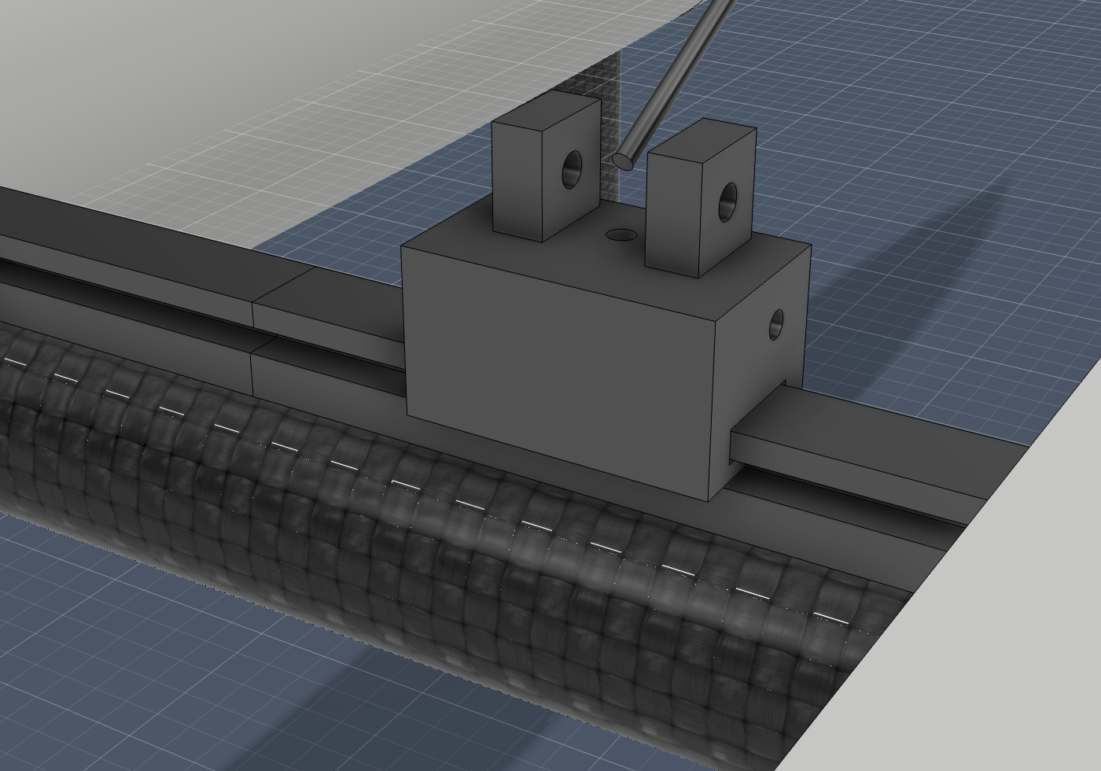
images/traveler_car.png
