fmaleev/RC-Foiling-Cat/slides/charts/elevator.png

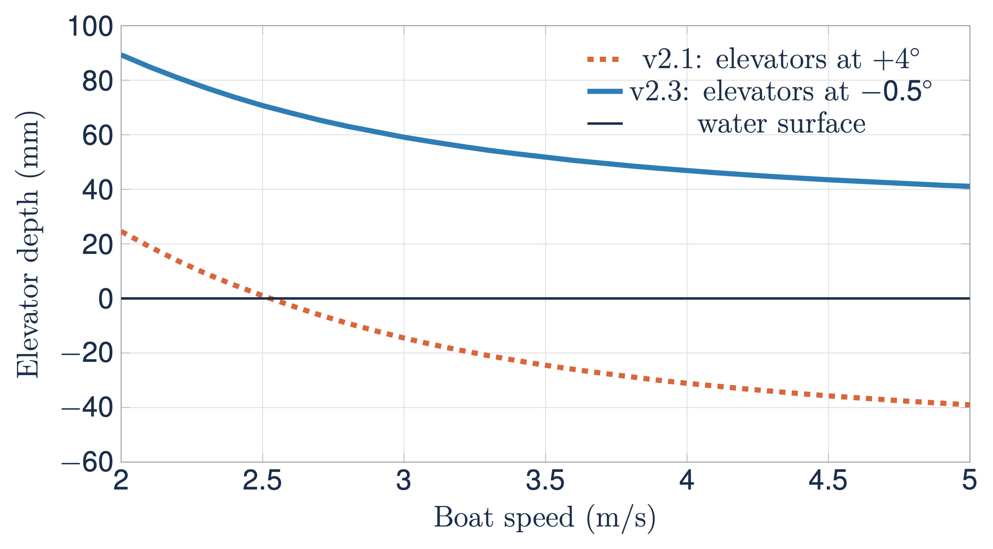
slides/charts/elevator.png
