fmaleev/RC-Foiling-Cat/slides/charts/search.png

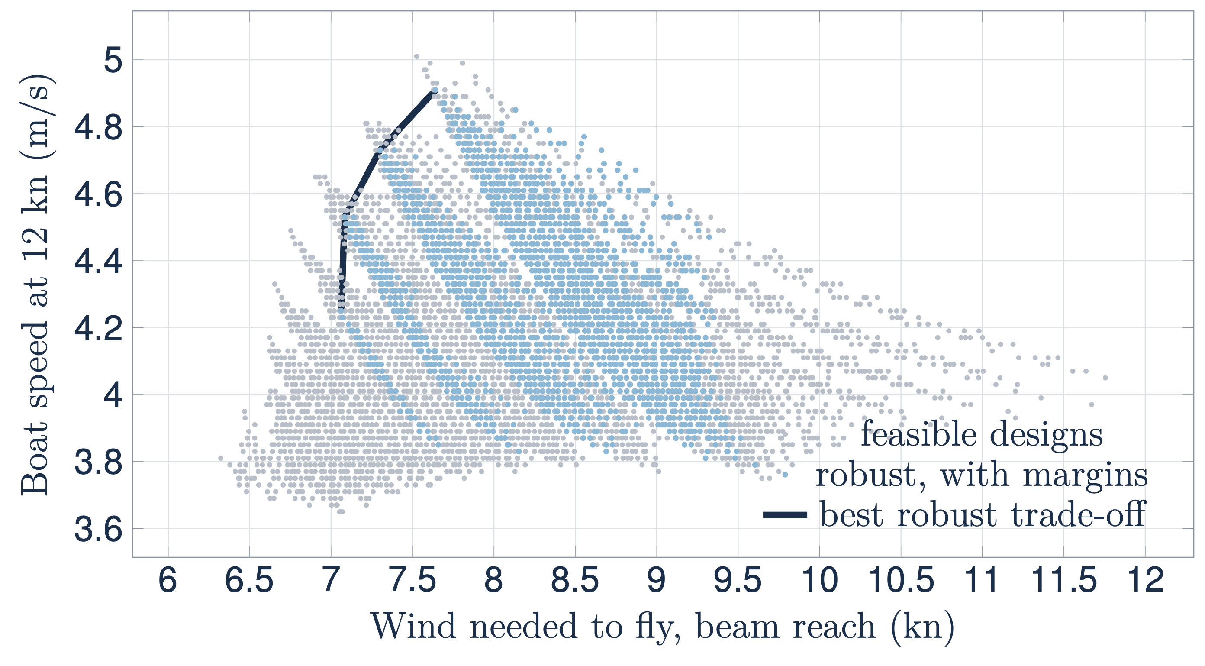
slides/charts/search.png
