fmaleev/RC-Foiling-Cat/slides/charts/speed.png

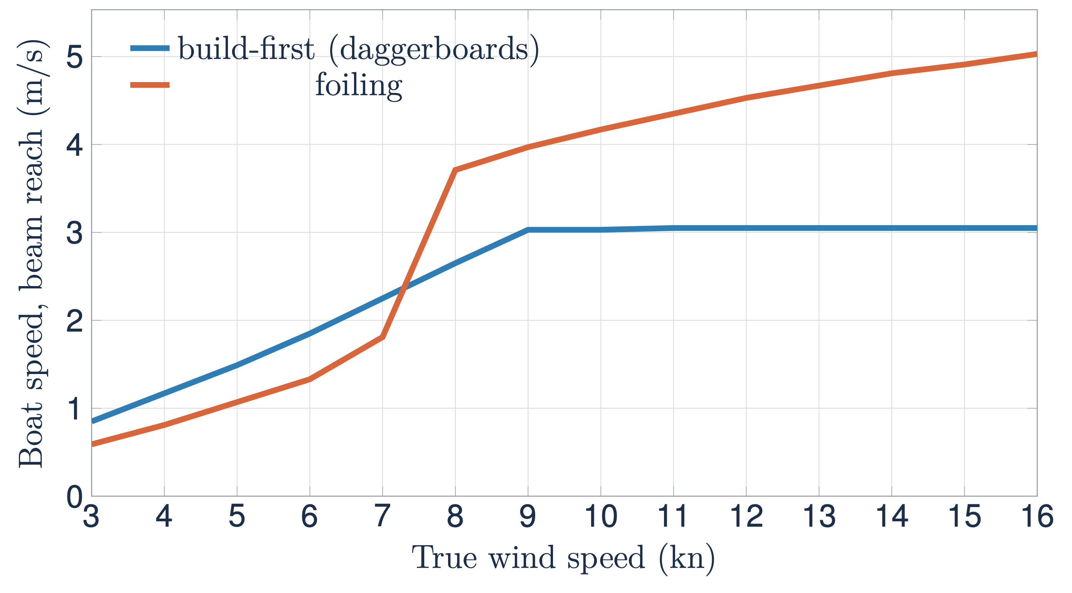
slides/charts/speed.png
