fmaleev/RC-Foiling-Cat/slides/charts/takeoff.png

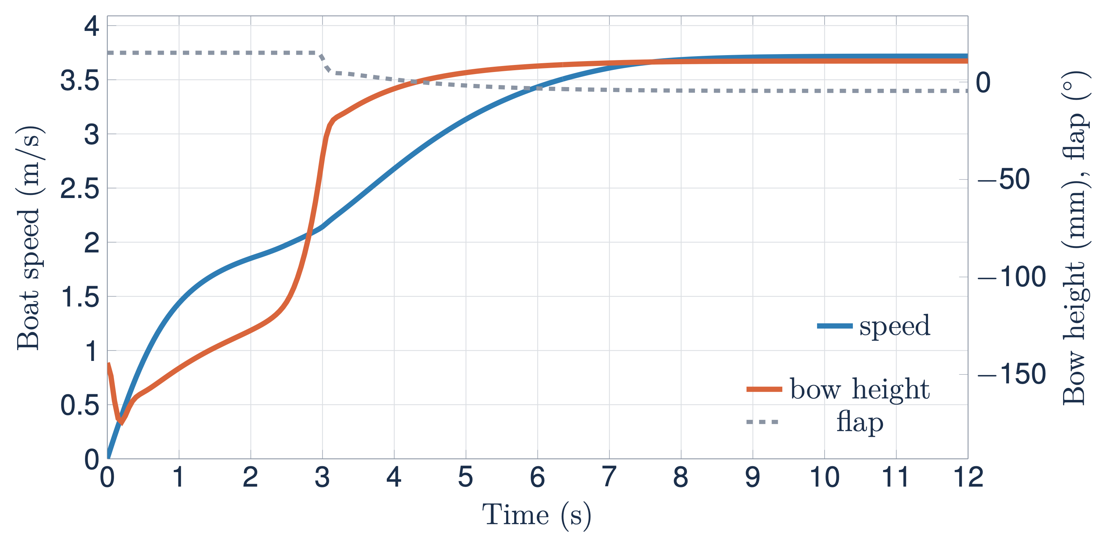
slides/charts/takeoff.png
