fmaleev/RC-Foiling-Cat/bom/bom_full_build_first.tex

Radio & FlySky FS-i6X + FS-iA6B receiver & 4 channels used: rudder, traveler, jib, mainsheet & 1 & \$69.99 & \$69.99 & \href{https://www.hobbytown.com/flysky-i6x-6channel-afhds-2a-air-radio-system-w-ia6b-receiver-fsy-i6xia6b/p1674181}{HobbyTown} \\
Radio & AA alkaline x4 & transmitter power & 1 & \$2.99 & \$2.99 & \href{https://www.hobbytown.com/flysky-fsgt2e-2channel-transmitter-w-fsa3-receiver-fsy-fs-gt2ea3/p1592822}{HobbyTown} \\
Servos & JX W4505-4T sail winch servo & traveler (about 209 mm of car travel, rig model) & 1 & \$11.13 & \$11.13 & \href{https://www.aliexpress.com/item/1005003265131874.html}{AliExpress} \\
Servos & JX W4505-2T sail winch servo & jib sheet (about 82 mm of sheet, rig model) & 1 & \$11.13 & \$11.13 & \href{https://www.aliexpress.com/item/1005003265131874.html}{AliExpress} \\
Servos & Feetech FS5115M standard servo & mainsheet tension & 1 & \$32.06 & \$32.06 & \href{https://www.pololu.com/product/3426}{Pololu} \\
Servos & MG90S metal-gear micro servo & rudders via pushrod + tie bar & 1 & \$2.59 & \$2.59 & \href{https://www.waveshare.com/mg90s-servo.htm}{Waveshare} \\
Power & Panasonic eneloop AA 2000 mAh, 4-pack & receiver pack (4.8 V) & 1 & \$17.99 & \$17.99 & \href{https://www.walmart.com/ip/Panasonic-Eneloop-BK-3MCCA4BA-Pre-Charged-Nickel-Metal-Hydride-AA-Rechargeable-Batteries-4-Battery-Pack/39111776}{Walmart, sold by My Battery Supplier} \\
Power & Traxxas 4-cell AA holder with switch (TRA1523) & receiver battery box + on/off & 1 & \$4.00 & \$4.00 & \href{https://www.hobbytown.com/traxxas-4cell-aa-battery-holder-w-switch-cover-tra1523/p49945}{HobbyTown} \\
Printed & PETG filament 1 kg & hulls, pod, lid, rudder-servo bracket and cover, rudders, boards, gudgeons, tracks, cars, mast fairing and fittings (~1.5 kg used, 1 m manual print list) & 2 & \$13.99 & \$27.98 & \href{https://us.elegoo.com/products/rapid-petg-filament-1-75mm-colored-1kg}{Elegoo US} \\
Carbon & Carbon tube 16 x 14 mm x 1 m & two 600 mm crossbeams & 2 & \$27.46 & \$54.92 & \href{https://www.readymaderc.com/products/details/86475-carbon-fiber-tube-16mm-x-14mm-1m-long}{RMRC 16X14X1M-CF-TUBE} \\
Carbon & Carbon tube 12 x 10 mm x 1 m & two-piece mast (1.3 m) & 2 & \$12.26 & \$24.52 & \href{https://www.readymaderc.com/products/details/carbon-fiber-tube-12mm-x-10mm-1m-long}{RMRC} \\
Carbon & Carbon tube 10 x 8 mm x 1 m & mast joiner spigot (150 mm) and pod beam (600 mm) & 1 & \$16.15 & \$16.15 & \href{https://www.cstsales.com/Carbon_Fiber_Tubes.html}{CST CS-525 1M} \\
Carbon & Carbon tube 8 x 7 mm x 1 m & boom (345 mm) & 1 & \$17.20 & \$17.20 & \href{https://www.cstsales.com/Carbon_Fiber_Tubes.html}{CST CS-529 1M} \\
Carbon & Carbon rod 1.2 mm x 2 m & 8 battens (2.01 m in all; finish them from the 1 m rod) & 1 & \$5.25 & \$5.25 & \href{https://www.cstsales.com/carbon_rods.html}{CST CS-316 2M} \\
Carbon & Carbon rod 1.2 mm x 1 m & the last batten, daggerboard joint rods (4 x 80 mm) & 1 & \$3.47 & \$3.47 & \href{https://www.cstsales.com/carbon_rods.html}{CST CS-316 1M} \\
Hardware & Music wire 0.156 in & rudder stocks, tie bar & 2 & \$4.99 & \$9.98 & \href{https://ksmetals.com/collections/12-long-music-wire}{K\&S 0.156 in x 12 in} \\
Hardware & Music wire 0.093 in & rudder pushrod, track end-stop turning pins, gooseneck pin, boom sheet eye & 1 & \$3.99 & \$3.99 & \href{https://ksmetals.com/collections/12-long-music-wire}{K\&S 0.093 in x 12 in} \\
Hardware & Du-Bro micro pushrod system & clevises & 1 & \$8.55 & \$8.55 & \href{https://www.hobbytown.com/dubro-pushrod-system-micro-dub847/p29360}{HobbyTown} \\
Sails & Icarex PC31 ripstop polyester, 1 m & main + jib (0.40 m2) & 1 & \$21.99 & \$21.99 & \href{https://jonesairfoils.com/products/icarex}{Jones Airfoils, per metre} \\
Sails & Ripstop sail tape 2 in, half roll & luff, batten pockets, corners & 1 & \$9.65 & \$9.65 & \href{https://kiteboarding.com/proddetail.asp?prod=ripstop_2inch}{kiteboarding.com} \\
Rigging & Braided PE line 30 lb & stays, bridle, sheets & 1 & \$14.43 & \$14.43 & \href{https://www.walmart.com/ip/PowerPro-Braided-Fishing-Line-30lb-x-150yd-ylw-21100300150Y/17117880}{Walmart, PowerPro 30 lb x 150 yd} \\
Adhesives & BSI 30-minute epoxy 9 oz & hull joints, beams, fittings & 1 & \$22.99 & \$22.99 & \href{https://www.hobbytown.com/bob-smith-industries-slowcure-30-minute-epoxy-9o-bsi206/p37086}{HobbyTown BSI206} \\
Adhesives & BSI gap-filling CA 1/2 oz & small parts & 1 & \$4.79 & \$4.79 & \href{https://www.hobbytown.com/bob-smith-industries-instacure-gap-filling-ca-1-2oz-bsi106/p37055}{HobbyTown} \\
