fmaleev/RC-Foiling-Cat/bom/bom_mini.tex

Radio & FlySky FS-i6X + FS-iA6B receiver & CH1 rudder, CH3 sails (non-centering stick); reused on the 1 m boat & 1 & \$69.99 & \$69.99 & \href{https://www.hobbytown.com/flysky-i6x-6channel-afhds-2a-air-radio-system-w-ia6b-receiver-fsy-i6xia6b/p1674181}{HobbyTown} \\
Radio & AA alkaline x4 & transmitter power & 1 & \$2.99 & \$2.99 & \href{https://www.hobbytown.com/flysky-fsgt2e-2channel-transmitter-w-fsa3-receiver-fsy-fs-gt2ea3/p1592822}{HobbyTown} \\
Servos & JX W4505-2T sail winch servo & both sheets on the stepped drum & 1 & \$11.13 & \$11.13 & \href{https://www.aliexpress.com/item/1005003265131874.html}{AliExpress} \\
Servos & MG90S metal-gear micro servo & rudders via pushrod + tie bar & 1 & \$2.59 & \$2.59 & \href{https://www.waveshare.com/mg90s-servo.htm}{Waveshare} \\
Power & Panasonic eneloop AA 2000 mAh, 4-pack & receiver pack (4.8 V) & 1 & \$17.99 & \$17.99 & \href{https://www.walmart.com/ip/Panasonic-Eneloop-BK-3MCCA4BA-Pre-Charged-Nickel-Metal-Hydride-AA-Rechargeable-Batteries-4-Battery-Pack/39111776}{Walmart, sold by My Battery Supplier} \\
Power & Traxxas 4-cell AA holder with switch (TRA1523) & receiver battery box + on/off & 1 & \$4.00 & \$4.00 & \href{https://www.hobbytown.com/traxxas-4cell-aa-battery-holder-w-switch-cover-tra1523/p49945}{HobbyTown} \\
Printed & PETG filament 1 kg & hulls, box, lid, rudders, boards, drum (~470 g used) & 1 & \$13.99 & \$13.99 & \href{https://us.elegoo.com/products/rapid-petg-filament-1-75mm-colored-1kg}{Elegoo US} \\
Carbon & Carbon tube 10 x 8 mm x 1 m & two 360 mm crossbeams & 1 & \$16.15 & \$16.15 & \href{https://www.cstsales.com/Carbon_Fiber_Tubes.html}{CST CS-525 1M} \\
Carbon & Carbon tube 6 x 4 mm x 1 m & mast (800 mm) & 1 & \$15.25 & \$15.25 & \href{https://www.cstsales.com/Carbon_Fiber_Tubes.html}{CST CS-518 1M} \\
Carbon & Carbon tube 4 mm OD x 1 m & boom (210 mm) & 1 & \$8.49 & \$8.49 & \href{https://www.cstsales.com/Carbon_Fiber_Tubes.html}{CST CS-508 1M} \\
Carbon & Carbon rod 1.2 mm x 1 m & 3 battens & 1 & \$3.47 & \$3.47 & \href{https://www.cstsales.com/carbon_rods.html}{CST CS-316 1M} \\
Hardware & Music wire 0.125 in & rudder stocks & 1 & \$3.99 & \$3.99 & \href{https://ksmetals.com/collections/12-long-music-wire}{K\&S 0.125 in x 12 in} \\
Hardware & Music wire 0.093 in & tie bar, tiller arms & 1 & \$3.99 & \$3.99 & \href{https://ksmetals.com/collections/12-long-music-wire}{K\&S 0.093 in x 12 in} \\
Hardware & Music wire 0.047 in & rudder pushrod, sheet hooks & 1 & \$3.99 & \$3.99 & \href{https://ksmetals.com/collections/12-long-music-wire}{K\&S 0.047 in x 12 in} \\
Hardware & Du-Bro micro pushrod system & clevis + tube for the rudder pushrod & 1 & \$8.55 & \$8.55 & \href{https://www.hobbytown.com/dubro-pushrod-system-micro-dub847/p29360}{HobbyTown} \\
Sails & Icarex PC31 ripstop polyester, 1 m & main + jib (0.145 m2) & 1 & \$21.99 & \$21.99 & \href{https://jonesairfoils.com/products/icarex}{Jones Airfoils, per metre} \\
Sails & Ripstop sail tape 2 in, 10 ft & luff, batten pockets, corners & 1 & \$6.50 & \$6.50 & \href{https://kiteboarding.com/proddetail.asp?prod=ripstop_2inch}{kiteboarding.com} \\
Rigging & Braided PE line 30 lb & stays, bridle, sheets & 1 & \$14.43 & \$14.43 & \href{https://www.walmart.com/ip/PowerPro-Braided-Fishing-Line-30lb-x-150yd-ylw-21100300150Y/17117880}{Walmart, PowerPro 30 lb x 150 yd} \\
Adhesives & BSI 30-minute epoxy 4.5 oz & hull segment joints, beams, fittings & 1 & \$13.99 & \$13.99 & \href{https://www.hobbytown.com/bob-smith-industries-slowcure-30-minute-epoxy-4-1-2oz-bsi205/p37085}{HobbyTown BSI205} \\
Adhesives & BSI gap-filling CA 1/2 oz & small parts, knots & 1 & \$4.79 & \$4.79 & \href{https://www.hobbytown.com/bob-smith-industries-instacure-gap-filling-ca-1-2oz-bsi106/p37055}{HobbyTown} \\
