fmaleev/RC-Foiling-Cat/bom/RC_Catamaran_Shopping_List.tex

\documentclass[11pt]{article}
\usepackage[letterpaper,margin=0.75in]{geometry}
\usepackage{booktabs,longtable,array,xurl,enumitem}
\newcolumntype{L}[1]{>{\raggedright\arraybackslash}p{#1}}
\usepackage[hidelinks]{hyperref}
\setlist{itemsep=2pt}
\title{\textbf{RC Catamaran: What to Buy}\\\large Mini Cat, 1\,m boat and foiling kit}
\author{Filip Maleev}
\date{Prices read on retailer pages 23--25 September 2026, re-checked 4 October 2026}
\begin{document}
\maketitle

\section*{The plan}
Build in three stages, each after the one before sails well. The build manuals (\texttt{mini/manual/} and \texttt{manual\_1m/}) say what each part is for and how it goes together.
\begin{center}
\begin{tabular}{lrr}
\toprule
 & List price & To buy, in this order \\
\midrule
Stage 1: Mini Cat 600 & \$248.26 & \$248.26 \\
Stage 2: 1\,m boat (daggerboards) & \$397.74 & \$302.77$^\dagger$ \\
Stage 3: foiling kit & \$101.17 & \$101.17 \\
\midrule
\textbf{All three} & & \textbf{\$652.20} \\
\bottomrule
\end{tabular}
\end{center}
$^\dagger$ The radio, its AA cells and the NiMH pack bought for the Mini (\$94.97) move to the 1\,m boat. Leftover filament, epoxy, glue, sail cloth and line from one stage may cover part of the next; the lists assume new stock.

Prices exclude shipping and tax. They were read on the retailers' pages in September and re-checked on 4 October 2026; the two that could not be re-checked say so. Check them before ordering. Under each item, in italics, is the listing the price came from, with the part number where there is one and a note where the price is uncertain.

\section*{Also needed, not priced above}
\begin{itemize}
\item \textbf{A 3D printer} that prints PETG, with a bed of at least 220\,x\,220\,mm. Every part is sized for that bed; two print diagonally (the 1\,m manual says which).
\item \textbf{A NiMH charger} for the eneloop AA cells. The Panasonic charger bundled with 4 more eneloop cells was \$32.09 at Walmart on 24 September 2026 [24] but out of stock on 4 October.
\item \textbf{Hand tools}, assumed on hand: hobby knife and steel rule; drill bits 1.2, 1.5, 2, 2.5 and 3.2\,mm (a pin vise is enough); side cutters and round-nose pliers for the music wire; 240-grit sandpaper; masking tape; a fine-tip soldering iron or hot needle for holes in the sailcloth; small screwdrivers; a 0.9\,mm hex key for the elevator trim screws; a bucket or sink for leak tests; a kitchen scale.
\item Servo screws come with the servos.
\end{itemize}

\section*{Choices: recommended parts and their alternatives}
Where a part has a cheaper or better option, the lists use the recommended one (marked $^\ast$ in the lists). Swapping to the alternative changes the totals by the difference in price.
\subsection*{FlySky FS-i6X + FS-iA6B receiver \normalfont\small (mini/1 m)}
{\small
\begin{longtable}{L{3.6cm}rL{5.4cm}L{5.4cm}}
\toprule
Option & Unit & Pros & Cons \\
\midrule
Recommended (listed): FlySky FS-i6X + FS-iA6B receiver\newline{\footnotesize HobbyTown [1]} & \$69.99 & 6 channels, so one radio runs both boats; the throttle stick stays where you leave it, which holds a sail trim & \$31 more than the car radio \\
Cheaper, Mini only: FlySky FS-GT2E + FS-A3 (car radio)\newline{\footnotesize HobbyTown [2]} & \$38.99 & \$31 less & 2 channels, so it cannot run the 1 m boat (you would buy the FS-i6X later as well); the throttle trigger springs back to centre, so a sail trim has to be held by hand \\
\bottomrule
\end{longtable}}
\subsection*{MG90S metal-gear micro servo \normalfont\small (mini/1 m)}
{\small
\begin{longtable}{L{3.6cm}rL{5.4cm}L{5.4cm}}
\toprule
Option & Unit & Pros & Cons \\
\midrule
Recommended (listed): MG90S metal-gear micro servo\newline{\footnotesize Waveshare [4]} & \$2.59 & \$2.59; the printed servo rails are drawn to its case & not waterproof; on the 1 m boat it sits under a printed cover aft of the rear beam, where spray reaches \\
Upgrade: EcoPower 640T waterproof micro servo\newline{\footnotesize HobbyTown [25]} & \$29.99 & waterproof to 1 m and metal-geared (maker); rated 4.8-6.0 V, so it runs on the 4.8 V pack & \$27.40 more; its case is 23.5 x 12.5 mm against the MG90S 22.8 x 12.2 mm, so it does not fit between the printed rails (23.4 mm gap) unless they are widened \\
\bottomrule
\end{longtable}}
\subsection*{Panasonic eneloop AA 2000 mAh, 4-pack \normalfont\small (mini/1 m)}
{\small
\begin{longtable}{L{3.6cm}rL{5.4cm}L{5.4cm}}
\toprule
Option & Unit & Pros & Cons \\
\midrule
Recommended (listed): Panasonic eneloop AA 2000 mAh, 4-pack\newline{\footnotesize Walmart [5]} & \$17.99 & in stock when checked (2026-10-04) & \$5.24 more; sold by a third-party seller on Walmart \\
Cheaper: The same eneloop 4-pack at MicroBattery\newline{\footnotesize MicroBattery [26]} & \$12.75 & \$5.24 less & out of stock when checked (2026-10-04) \\
\bottomrule
\end{longtable}}
\subsection*{Carbon tube 16 x 14 mm x 1 m \normalfont\small (1 m)}
{\small
\begin{longtable}{L{3.6cm}rL{5.4cm}L{5.4cm}}
\toprule
Option & Unit & Pros & Cons \\
\midrule
Recommended (listed): Carbon tube 16 x 14 mm x 1 m\newline{\footnotesize RMRC [18]} & \$27.46 & price and stock confirmed on the page (2026-10-04); same store as the 12 x 10 mm mast tubes, so one order & \$22.36 more for the two tubes \\
Cheaper: 16 x 14 mm carbon tube at Wind Catcher RC\newline{\footnotesize Wind Catcher RC [27]} & \$16.28 & \$11.18 less per tube & price from a search listing; the site blocked this connection, so price, stock and wall thickness are not confirmed; a separate order and shipping \\
\bottomrule
\end{longtable}}
\subsection*{BSI 30-minute epoxy 4.5 oz \normalfont\small (mini)}
{\small
\begin{longtable}{L{3.6cm}rL{5.4cm}L{5.4cm}}
\toprule
Option & Unit & Pros & Cons \\
\midrule
Recommended (listed): BSI 30-minute epoxy 4.5 oz\newline{\footnotesize HobbyTown [15]} & \$13.99 & the strongest of the BSI epoxies, waterproof and more heat resistant (maker); 30 minutes to line up hull segments and beams before it sets & handle after 8 hours, full strength in 24 hours (maker) \\
Same price, faster: BSI 5-minute epoxy 4.5 oz\newline{\footnotesize HobbyTown [28]} & \$13.99 & sets in minutes: handy for small fittings & weaker, and 5 minutes is short for lining up a long hull or beam joint \\
\bottomrule
\end{longtable}}
\subsection*{BSI 30-minute epoxy 9 oz \normalfont\small (1 m)}
{\small
\begin{longtable}{L{3.6cm}rL{5.4cm}L{5.4cm}}
\toprule
Option & Unit & Pros & Cons \\
\midrule
Recommended (listed): BSI 30-minute epoxy 9 oz\newline{\footnotesize HobbyTown [20]} & \$22.99 & the strongest of the BSI epoxies, waterproof and more heat resistant (maker); 30 minutes to line up hull segments and beams before it sets & handle after 8 hours, full strength in 24 hours (maker) \\
Same price, faster: BSI 5-minute epoxy 9 oz\newline{\footnotesize HobbyTown [29]} & \$22.99 & sets in minutes: handy for small fittings & weaker, and 5 minutes is short for lining up a long hull or beam joint \\
\bottomrule
\end{longtable}}

\clearpage
\section*{Order by store}
Orders grouped by store, with the carried-over radio and battery counted once.
\begin{center}
\begin{tabular}{lcrl}
\toprule
Store & Items & Subtotal & Stages \\
\midrule
HobbyTown & 10 & \$149.19 & 1, 2, 3 \\
CST (cstsales.com) & 11 & \$137.65 & 1, 2, 3 \\
RMRC & 2 & \$79.44 & 2 \\
Elegoo US & 3 & \$55.96 & 1, 2, 3 \\
Walmart & 3 & \$46.85 & 1, 2 \\
Jones Airfoils & 2 & \$43.98 & 1, 2 \\
AliExpress & 3 & \$33.39 & 1, 2 \\
Pololu & 1 & \$32.06 & 2 \\
K\&S Metals & 6 & \$29.93 & 1, 2, 3 \\
Easy Composites & 1 & \$20.70 & 3 \\
kiteboarding.com & 2 & \$16.15 & 1, 2 \\
Waveshare & 2 & \$5.18 & 1, 2 \\
Bolt Depot & 1 & \$1.72 & 3 \\
\bottomrule
\end{tabular}
\end{center}

\section*{Parts by stage}

\subsection*{Stage 1: Mini Cat 600 (build first) \hfill \$248.26}
{\small
\begin{longtable}{L{4.1cm}L{4.5cm}crrl}
\toprule
Item & Used for & Qty & Unit & Total & Store [link] \\
\midrule\endhead
FlySky FS-i6X + FS-iA6B receiver$^\ast$ & CH1 rudder, CH3 sails (non-centering stick); reused on the 1 m boat & 1 & \$69.99 & \$69.99 & HobbyTown [1] \\
AA alkaline x4\newline{\footnotesize\itshape HobbyTown (EcoPower AA x4 add-on)} & transmitter power & 1 & \$2.99 & \$2.99 & HobbyTown [2] \\
JX W4505-2T sail winch servo\newline{\footnotesize\itshape AliExpress: listed \$5.79 at 48\% off; full price used (2026-09-23; on 2026-10-04 the page showed a bot check, not re-checked)} & both sheets on the stepped drum & 1 & \$11.13 & \$11.13 & AliExpress [3] \\
MG90S metal-gear micro servo$^\ast$ & rudders via pushrod + tie bar & 1 & \$2.59 & \$2.59 & Waveshare [4] \\
Panasonic eneloop AA 2000 mAh, 4-pack$^\ast$\newline{\footnotesize\itshape Walmart, sold by My Battery Supplier (BK-3MCCA4BA, in stock 2026-10-04)} & receiver pack (4.8 V) & 1 & \$17.99 & \$17.99 & Walmart [5] \\
Traxxas 4-cell AA holder with switch (TRA1523) & receiver battery box + on/off & 1 & \$4.00 & \$4.00 & HobbyTown [6] \\
PETG filament 1 kg & hulls, box, lid, rudders, boards, drum (about 470 g used) & 1 & \$13.99 & \$13.99 & Elegoo US [7] \\
Carbon tube 10 x 8 mm x 1 m\newline{\footnotesize\itshape CST CS-525 1M} & two 360 mm crossbeams & 1 & \$16.15 & \$16.15 & CST (cstsales.com) [8] \\
Carbon tube 6 x 4 mm x 1 m\newline{\footnotesize\itshape CST CS-518 1M} & mast (800 mm) & 1 & \$15.25 & \$15.25 & CST (cstsales.com) [8] \\
Carbon tube 4 mm OD x 1 m\newline{\footnotesize\itshape CST CS-508 1M} & boom (210 mm) & 1 & \$8.49 & \$8.49 & CST (cstsales.com) [8] \\
Carbon rod 1.2 mm x 1 m\newline{\footnotesize\itshape CST CS-316 1M} & 3 battens & 1 & \$3.47 & \$3.47 & CST (cstsales.com) [9] \\
Music wire 0.125 in\newline{\footnotesize\itshape K\&S 0.125 in x 12 in} & rudder stocks & 1 & \$3.99 & \$3.99 & K\&S Metals [10] \\
Music wire 0.093 in\newline{\footnotesize\itshape K\&S 0.093 in x 12 in} & tie bar, tiller arms & 1 & \$3.99 & \$3.99 & K\&S Metals [10] \\
Music wire 0.047 in\newline{\footnotesize\itshape K\&S 0.047 in x 12 in (3 pcs)} & rudder pushrod, sheet hooks & 1 & \$3.99 & \$3.99 & K\&S Metals [10] \\
Du-Bro micro pushrod system & clevis + tube for the rudder pushrod & 1 & \$8.55 & \$8.55 & HobbyTown [11] \\
Icarex PC31 ripstop polyester, 1 m\newline{\footnotesize\itshape Jones Airfoils, per metre (138 cm wide); 1 m price read 2026-09-23 (on 2026-10-04 the page showed local currency; 5 m or more is \$18.49/m)} & main + jib (0.145 m2) & 1 & \$21.99 & \$21.99 & Jones Airfoils [12] \\
Ripstop sail tape 2 in, 10 ft\newline{\footnotesize\itshape kiteboarding.com: 10 ft cut, \$15.00 roll less \$8.50 (2026-10-04)} & luff, batten pockets, corners & 1 & \$6.50 & \$6.50 & kiteboarding.com [13] \\
Braided PE line 30 lb\newline{\footnotesize\itshape Walmart, PowerPro 30 lb x 150 yd (read 2026-09-24; the original eBay listing had ended)} & stays, bridle, sheets & 1 & \$14.43 & \$14.43 & Walmart [14] \\
BSI 30-minute epoxy 4.5 oz$^\ast$\newline{\footnotesize\itshape HobbyTown BSI205} & hull segment joints, beams, fittings & 1 & \$13.99 & \$13.99 & HobbyTown [15] \\
BSI gap-filling CA 1/2 oz & small parts, knots & 1 & \$4.79 & \$4.79 & HobbyTown [16] \\
\midrule
\multicolumn{4}{l}{\textbf{Total}} & \textbf{\$248.26} & \\
\bottomrule
\end{longtable}}

\subsection*{Stage 2: 1 m boat with daggerboards \hfill \$397.74}
{\small
\begin{longtable}{L{4.1cm}L{4.5cm}crrl}
\toprule
Item & Used for & Qty & Unit & Total & Store [link] \\
\midrule\endhead
FlySky FS-i6X + FS-iA6B receiver$^\dagger$$^\ast$ & 4 channels used: rudder, traveler, jib, mainsheet & 1 & \$69.99 & \$69.99 & HobbyTown [1] \\
AA alkaline x4$^\dagger$\newline{\footnotesize\itshape HobbyTown (EcoPower AA x4 add-on)} & transmitter power & 1 & \$2.99 & \$2.99 & HobbyTown [2] \\
JX W4505-4T sail winch servo\newline{\footnotesize\itshape AliExpress: listed \$5.79 at 48\% off; full price used (2026-09-23; on 2026-10-04 the page showed a bot check, not re-checked)} & traveler (about 209 mm of car travel, rig model) & 1 & \$11.13 & \$11.13 & AliExpress [3] \\
JX W4505-2T sail winch servo\newline{\footnotesize\itshape AliExpress: listed \$5.79 at 48\% off; full price used (2026-09-23; on 2026-10-04 the page showed a bot check, not re-checked)} & jib sheet (about 82 mm of sheet, rig model) & 1 & \$11.13 & \$11.13 & AliExpress [3] \\
Feetech FS5115M standard servo & mainsheet tension & 1 & \$32.06 & \$32.06 & Pololu [17] \\
MG90S metal-gear micro servo$^\ast$ & rudders via pushrod + tie bar & 1 & \$2.59 & \$2.59 & Waveshare [4] \\
Panasonic eneloop AA 2000 mAh, 4-pack$^\dagger$$^\ast$\newline{\footnotesize\itshape Walmart, sold by My Battery Supplier (BK-3MCCA4BA, in stock 2026-10-04)} & receiver pack (4.8 V) & 1 & \$17.99 & \$17.99 & Walmart [5] \\
Traxxas 4-cell AA holder with switch (TRA1523)$^\dagger$ & receiver battery box + on/off & 1 & \$4.00 & \$4.00 & HobbyTown [6] \\
PETG filament 1 kg & hulls, pod, lid, rudder-servo bracket and cover, rudders, boards, gudgeons, tracks, cars, mast fairing and fittings (about 1.5 kg used, 1 m manual print list) & 2 & \$13.99 & \$27.98 & Elegoo US [7] \\
Carbon tube 16 x 14 mm x 1 m$^\ast$\newline{\footnotesize\itshape RMRC 16X14X1M-CF-TUBE (in stock 2026-10-04)} & two 600 mm crossbeams & 2 & \$27.46 & \$54.92 & RMRC [18] \\
Carbon tube 12 x 10 mm x 1 m & two-piece mast (1.3 m) & 2 & \$12.26 & \$24.52 & RMRC [19] \\
Carbon tube 10 x 8 mm x 1 m\newline{\footnotesize\itshape CST CS-525 1M} & mast joiner spigot (150 mm) and pod beam (600 mm) & 1 & \$16.15 & \$16.15 & CST (cstsales.com) [8] \\
Carbon tube 8 x 7 mm x 1 m\newline{\footnotesize\itshape CST CS-529 1M} & boom (345 mm) & 1 & \$17.20 & \$17.20 & CST (cstsales.com) [8] \\
Carbon rod 1.2 mm x 2 m\newline{\footnotesize\itshape CST CS-316 2M} & 8 battens (2.01 m in all; finish them from the 1 m rod) & 1 & \$5.25 & \$5.25 & CST (cstsales.com) [9] \\
Carbon rod 1.2 mm x 1 m\newline{\footnotesize\itshape CST CS-316 1M} & the last batten, daggerboard joint rods (4 x 80 mm) & 1 & \$3.47 & \$3.47 & CST (cstsales.com) [9] \\
Music wire 0.156 in\newline{\footnotesize\itshape K\&S 0.156 in x 12 in} & rudder stocks, tie bar & 2 & \$4.99 & \$9.98 & K\&S Metals [10] \\
Music wire 0.093 in\newline{\footnotesize\itshape K\&S 0.093 in x 12 in} & rudder pushrod, track end-stop turning pins, gooseneck pin, boom sheet eye & 1 & \$3.99 & \$3.99 & K\&S Metals [10] \\
Du-Bro micro pushrod system & clevises & 1 & \$8.55 & \$8.55 & HobbyTown [11] \\
Icarex PC31 ripstop polyester, 1 m\newline{\footnotesize\itshape Jones Airfoils, per metre (138 cm wide); 1 m price read 2026-09-23 (on 2026-10-04 the page showed local currency; 5 m or more is \$18.49/m)} & main + jib (0.40 m2) & 1 & \$21.99 & \$21.99 & Jones Airfoils [12] \\
Ripstop sail tape 2 in, half roll\newline{\footnotesize\itshape kiteboarding.com: half roll (12.5 ft), \$15.00 roll less \$5.35 (2026-10-04)} & luff, batten pockets, corners & 1 & \$9.65 & \$9.65 & kiteboarding.com [13] \\
Braided PE line 30 lb\newline{\footnotesize\itshape Walmart, PowerPro 30 lb x 150 yd (read 2026-09-24; the original eBay listing had ended)} & stays, bridle, sheets & 1 & \$14.43 & \$14.43 & Walmart [14] \\
BSI 30-minute epoxy 9 oz$^\ast$\newline{\footnotesize\itshape HobbyTown BSI206} & hull joints, beams, fittings & 1 & \$22.99 & \$22.99 & HobbyTown [20] \\
BSI gap-filling CA 1/2 oz & small parts & 1 & \$4.79 & \$4.79 & HobbyTown [16] \\
\midrule
\multicolumn{4}{l}{\textbf{Total}} & \textbf{\$397.74} & \\
\bottomrule
\end{longtable}}
\noindent $^\dagger$ Already bought for the Mini Cat: the radio, its AA cells and the NiMH pack move to the 1\,m boat, so if you build the Mini first, Stage 2 costs \$302.77 instead of \$397.74.

\subsection*{Stage 3: foiling kit (v2.3 foils) \hfill \$101.17}
{\small
\begin{longtable}{L{4.1cm}L{4.5cm}crrl}
\toprule
Item & Used for & Qty & Unit & Total & Store [link] \\
\midrule\endhead
PETG filament 1 kg & L-foil, elevator and flap cores, trim pods, ride-height linkage (about 290 g, 1 m manual print list) & 1 & \$13.99 & \$13.99 & Elegoo US [7] \\
Unidirectional carbon tape 2 in x 12 ft\newline{\footnotesize\itshape CST CU-379: 2 in unidirectional carbon, 0.005 in, 12 ft} & spar caps: 4 layers per face on struts, wings, elevators & 2 & \$19.95 & \$39.90 & CST (cstsales.com) [21] \\
EL2 laminating epoxy 500 g\newline{\footnotesize\itshape Easy Composites EL2, 500 g kit} & wet-out of the caps & 1 & \$20.70 & \$20.70 & Easy Composites [22] \\
Carbon rod 1.2 mm x 1 m\newline{\footnotesize\itshape CST CS-316 1M} & flap hinge pins & 1 & \$3.47 & \$3.47 & CST (cstsales.com) [9] \\
Carbon rod 2 mm x 1 m\newline{\footnotesize\itshape CST CS-323 1M (2 mm)} & two 300 mm ride-height wands, elevator pivot pins, wand and bellcrank axles, L-foil core dowels & 1 & \$8.85 & \$8.85 & CST (cstsales.com) [9] \\
Music wire 0.047 in\newline{\footnotesize\itshape K\&S 0.047 in x 12 in (3 pcs)} & wand-to-flap pushrods & 1 & \$3.99 & \$3.99 & K\&S Metals [10] \\
Du-Bro micro pushrod system & clevises for the flap linkage & 1 & \$8.55 & \$8.55 & HobbyTown [11] \\
M2 x 6 mm stainless set screw, cup point (Bolt Depot 8697)\newline{\footnotesize\itshape Bolt Depot, per piece (read 2026-09-25)} & elevator trim screws, two per trim pod & 4 & \$0.43 & \$1.72 & Bolt Depot [23] \\
\midrule
\multicolumn{4}{l}{\textbf{Total}} & \textbf{\$101.17} & \\
\bottomrule
\end{longtable}}

\section*{Links}
{\small
\begin{enumerate}[label={[\arabic*]}]
\item \url{https://www.hobbytown.com/flysky-i6x-6channel-afhds-2a-air-radio-system-w-ia6b-receiver-fsy-i6xia6b/p1674181}
\item \url{https://www.hobbytown.com/flysky-fsgt2e-2channel-transmitter-w-fsa3-receiver-fsy-fs-gt2ea3/p1592822}
\item \url{https://www.aliexpress.com/item/1005003265131874.html}
\item \url{https://www.waveshare.com/mg90s-servo.htm}
\item \url{https://www.walmart.com/ip/Panasonic-Eneloop-BK-3MCCA4BA-Pre-Charged-Nickel-Metal-Hydride-AA-Rechargeable-Batteries-4-Battery-Pack/39111776}
\item \url{https://www.hobbytown.com/traxxas-4cell-aa-battery-holder-w-switch-cover-tra1523/p49945}
\item \url{https://us.elegoo.com/products/rapid-petg-filament-1-75mm-colored-1kg}
\item \url{https://www.cstsales.com/Carbon_Fiber_Tubes.html}
\item \url{https://www.cstsales.com/carbon_rods.html}
\item \url{https://ksmetals.com/collections/12-long-music-wire}
\item \url{https://www.hobbytown.com/dubro-pushrod-system-micro-dub847/p29360}
\item \url{https://jonesairfoils.com/products/icarex}
\item \url{https://kiteboarding.com/proddetail.asp?prod=ripstop_2inch}
\item \url{https://www.walmart.com/ip/PowerPro-Braided-Fishing-Line-30lb-x-150yd-ylw-21100300150Y/17117880}
\item \url{https://www.hobbytown.com/bob-smith-industries-slowcure-30-minute-epoxy-4-1-2oz-bsi205/p37085}
\item \url{https://www.hobbytown.com/bob-smith-industries-instacure-gap-filling-ca-1-2oz-bsi106/p37055}
\item \url{https://www.pololu.com/product/3426}
\item \url{https://www.readymaderc.com/products/details/86475-carbon-fiber-tube-16mm-x-14mm-1m-long}
\item \url{https://www.readymaderc.com/products/details/carbon-fiber-tube-12mm-x-10mm-1m-long}
\item \url{https://www.hobbytown.com/bob-smith-industries-slowcure-30-minute-epoxy-9o-bsi206/p37086}
\item \url{https://www.cstsales.com/heat_tack.html}
\item \url{https://www.easycomposites.us/el2-epoxy-laminating-resin}
\item \url{https://boltdepot.com/Product-Details?product=8697}
\item \url{https://www.walmart.com/ip/Panasonic-Battery-Charger-with-4-eneloop-AA-Rechargeable-Batteries-4-Count/124706107}
\item \url{https://www.hobbytown.com/ecopower-640t-13g-waterproof-metal-gear-digital-sub-micro-servo-ecp-640t/p859667}
\item \url{https://www.microbattery.com/panasonic-bk-3mcca4ba-eneloop-aa-2100-cycle-ni-mh-pre-charged-rechargeable-batteries-4-pack80.html}
\item \url{https://windcatcherrc.com/product/carbon-fiber-tube-16mm-x-14mm-x-1000mm/}
\item \url{https://www.hobbytown.com/bob-smith-industries-quickcure-5-minute-epoxy-4-1-2oz-bsi201/p37081}
\item \url{https://www.hobbytown.com/bob-smith-industries-quickcure-5-minute-epoxy-9o-bsi202/p37082}
\end{enumerate}}
\end{document}
