fmaleev/RC-Foiling-Cat/bom/bom_foiling_kit_v2.tex

Printed & PETG filament 1 kg & L-foil, elevator and flap cores, trim pods, ride-height linkage (~290 g, 1 m manual print list) & 1 & \$13.99 & \$13.99 & \href{https://us.elegoo.com/products/rapid-petg-filament-1-75mm-colored-1kg}{Elegoo US} \\
Carbon & Unidirectional carbon tape 2 in x 12 ft & spar caps: 4 layers per face on struts, wings, elevators & 2 & \$19.95 & \$39.90 & \href{https://www.cstsales.com/heat_tack.html}{CST CU-379} \\
Adhesives & EL2 laminating epoxy 500 g & wet-out of the caps & 1 & \$20.70 & \$20.70 & \href{https://www.easycomposites.us/el2-epoxy-laminating-resin}{Easy Composites EL2, 500 g kit} \\
Carbon & Carbon rod 1.2 mm x 1 m & flap hinge pins & 1 & \$3.47 & \$3.47 & \href{https://www.cstsales.com/carbon_rods.html}{CST CS-316 1M} \\
Carbon & Carbon rod 2 mm x 1 m & two 300 mm ride-height wands, elevator pivot pins, wand and bellcrank axles, L-foil core dowels & 1 & \$8.85 & \$8.85 & \href{https://www.cstsales.com/carbon_rods.html}{CST CS-323 1M} \\
Hardware & Music wire 0.047 in & wand-to-flap pushrods & 1 & \$3.99 & \$3.99 & \href{https://ksmetals.com/collections/12-long-music-wire}{K\&S 0.047 in x 12 in} \\
Hardware & Du-Bro micro pushrod system & clevises for the flap linkage & 1 & \$8.55 & \$8.55 & \href{https://www.hobbytown.com/dubro-pushrod-system-micro-dub847/p29360}{HobbyTown} \\
Hardware & M2 x 6 mm stainless set screw, cup point (Bolt Depot 8697) & elevator trim screws, two per trim pod & 4 & \$0.43 & \$1.72 & \href{https://boltdepot.com/Product-Details?product=8697}{Bolt Depot, per piece} \\
