fmaleev/RC-Foiling-Cat/bom/bom_alternatives.csv

base_key | role | kind | item | lists | unit_usd | pros | cons | source | url
i6x | base | recommended | FlySky FS-i6X + FS-iA6B receiver | mini/1 m | 69.99 | 6 channels, so one radio runs both boats; the throttle stick stays where you leave it, which holds a sail trim | $31 more than the car radio | HobbyTown | https://www.hobbytown.com/flysky-i6x-6channel-afhds-2a-air-radio-system-w-ia6b-receiver-fsy-i6xia6b/p1674181
i6x | alternative | Cheaper, Mini only | FlySky FS-GT2E + FS-A3 (car radio) | mini/1 m | 38.99 | $31 less | 2 channels, so it cannot run the 1 m boat (you would buy the FS-i6X later as well); the throttle trigger springs back to centre, so a sail trim has to be held by hand | HobbyTown (re-read 2026-09-24; now sold with the FS-A3 receiver) | https://www.hobbytown.com/flysky-fsgt2e-2channel-transmitter-w-fsa3-receiver-fsy-fs-gt2ea3/p1592822
mg90s | base | recommended | MG90S metal-gear micro servo | mini/1 m | 2.59 | $2.59; the printed servo rails are drawn to its case | not waterproof; on the 1 m boat it sits under a printed cover aft of the rear beam, where spray reaches | Waveshare | https://www.waveshare.com/mg90s-servo.htm
mg90s | alternative | Upgrade | EcoPower 640T waterproof micro servo | mini/1 m | 29.99 | waterproof to 1 m and metal-geared (maker); rated 4.8-6.0 V, so it runs on the 4.8 V pack | $27.40 more; its case is 23.5 x 12.5 mm against the MG90S 22.8 x 12.2 mm, so it does not fit between the printed rails (23.4 mm gap) unless they are widened | HobbyTown | https://www.hobbytown.com/ecopower-640t-13g-waterproof-metal-gear-digital-sub-micro-servo-ecp-640t/p859667
enel_wm | base | recommended | Panasonic eneloop AA 2000 mAh, 4-pack | mini/1 m | 17.99 | in stock when checked (2026-10-04) | $5.24 more; sold by a third-party seller on Walmart | Walmart, sold by My Battery Supplier (BK-3MCCA4BA, in stock 2026-10-04) | https://www.walmart.com/ip/Panasonic-Eneloop-BK-3MCCA4BA-Pre-Charged-Nickel-Metal-Hydride-AA-Rechargeable-Batteries-4-Battery-Pack/39111776
enel_wm | alternative | Cheaper | The same eneloop 4-pack at MicroBattery | mini/1 m | 12.75 | $5.24 less | out of stock when checked (2026-10-04) | MicroBattery (out of stock on 2026-10-04) | https://www.microbattery.com/panasonic-bk-3mcca4ba-eneloop-aa-2100-cycle-ni-mh-pre-charged-rechargeable-batteries-4-pack80.html
cf16x14_rmrc | base | recommended | Carbon tube 16 x 14 mm x 1 m | 1 m | 27.46 | price and stock confirmed on the page (2026-10-04); same store as the 12 x 10 mm mast tubes, so one order | $22.36 more for the two tubes | RMRC 16X14X1M-CF-TUBE (in stock 2026-10-04) | https://www.readymaderc.com/products/details/86475-carbon-fiber-tube-16mm-x-14mm-1m-long
cf16x14_rmrc | alternative | Cheaper | 16 x 14 mm carbon tube at Wind Catcher RC | 1 m | 16.28 | $11.18 less per tube | price from a search listing; the site blocked this connection, so price, stock and wall thickness are not confirmed; a separate order and shipping | Wind Catcher RC (price from a search listing; the site blocked this connection on 2026-10-04) | https://windcatcherrc.com/product/carbon-fiber-tube-16mm-x-14mm-x-1000mm/
epoxy30_45 | base | recommended | BSI 30-minute epoxy 4.5 oz | mini | 13.99 | the strongest of the BSI epoxies, waterproof and more heat resistant (maker); 30 minutes to line up hull segments and beams before it sets | handle after 8 hours, full strength in 24 hours (maker) | HobbyTown BSI205 | https://www.hobbytown.com/bob-smith-industries-slowcure-30-minute-epoxy-4-1-2oz-bsi205/p37085
epoxy30_45 | alternative | Same price, faster | BSI 5-minute epoxy 4.5 oz | mini | 13.99 | sets in minutes: handy for small fittings | weaker, and 5 minutes is short for lining up a long hull or beam joint | HobbyTown | https://www.hobbytown.com/bob-smith-industries-quickcure-5-minute-epoxy-4-1-2oz-bsi201/p37081
epoxy30_9 | base | recommended | BSI 30-minute epoxy 9 oz | 1 m | 22.99 | the strongest of the BSI epoxies, waterproof and more heat resistant (maker); 30 minutes to line up hull segments and beams before it sets | handle after 8 hours, full strength in 24 hours (maker) | HobbyTown BSI206 | https://www.hobbytown.com/bob-smith-industries-slowcure-30-minute-epoxy-9o-bsi206/p37086
epoxy30_9 | alternative | Same price, faster | BSI 5-minute epoxy 9 oz | 1 m | 22.99 | sets in minutes: handy for small fittings | weaker, and 5 minutes is short for lining up a long hull or beam joint | HobbyTown | https://www.hobbytown.com/bob-smith-industries-quickcure-5-minute-epoxy-9o-bsi202/p37082
