fmaleev/RC-Foiling-Cat/bom/bom_foiling_kit_v2.csv

group | item | use | qty | unit_usd | total_usd | source | url
Printed | PETG filament 1 kg | L-foil, elevator and flap cores, trim pods, ride-height linkage (~290 g, 1 m manual print list) | 1 | 13.99 | 13.99 | Elegoo US | https://us.elegoo.com/products/rapid-petg-filament-1-75mm-colored-1kg
Carbon | Unidirectional carbon tape 2 in x 12 ft | spar caps: 4 layers per face on struts, wings, elevators | 2 | 19.95 | 39.9 | CST CU-379: 2 in unidirectional carbon, 0.005 in, 12 ft | https://www.cstsales.com/heat_tack.html
Adhesives | EL2 laminating epoxy 500 g | wet-out of the caps | 1 | 20.7 | 20.7 | Easy Composites EL2, 500 g kit | https://www.easycomposites.us/el2-epoxy-laminating-resin
Carbon | Carbon rod 1.2 mm x 1 m | flap hinge pins | 1 | 3.47 | 3.47 | CST CS-316 1M | https://www.cstsales.com/carbon_rods.html
Carbon | Carbon rod 2 mm x 1 m | two 300 mm ride-height wands, elevator pivot pins, wand and bellcrank axles, L-foil core dowels | 1 | 8.85 | 8.85 | CST CS-323 1M (2 mm) | https://www.cstsales.com/carbon_rods.html
Hardware | Music wire 0.047 in | wand-to-flap pushrods | 1 | 3.99 | 3.99 | K&S 0.047 in x 12 in (3 pcs) | https://ksmetals.com/collections/12-long-music-wire
Hardware | Du-Bro micro pushrod system | clevises for the flap linkage | 1 | 8.55 | 8.55 | HobbyTown | https://www.hobbytown.com/dubro-pushrod-system-micro-dub847/p29360
Hardware | M2 x 6 mm stainless set screw, cup point (Bolt Depot 8697) | elevator trim screws, two per trim pod | 4 | 0.43 | 1.72 | Bolt Depot, per piece (read 2026-09-25) | https://boltdepot.com/Product-Details?product=8697
