fmaleev/RC-Foiling-Cat/cad/Foiling_Kit_v2.3_carbon_parts_flaps_rudder_extensions.step

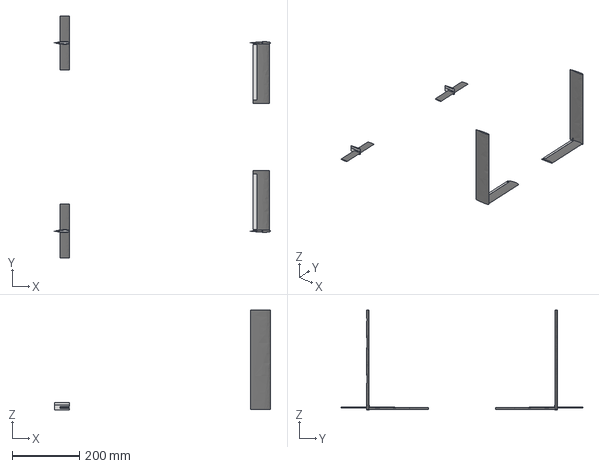
[picture p20: CAD file, 2026-09-27]
cad/Foiling_Kit_v2.3_carbon_parts_flaps_rudder_extensions.step
643.0 x 720.0 x 297.0 mm
