fmaleev/RC-Foiling-Cat/mini/cad/RC_Mini_Cat_600.step

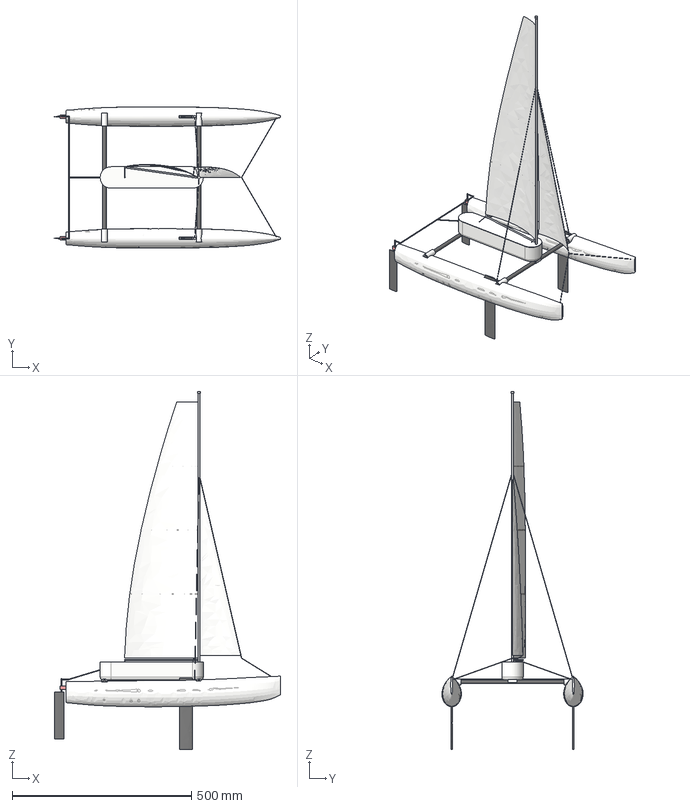
[picture p21: CAD file, 2026-09-25]
mini/cad/RC_Mini_Cat_600.step
632.0 x 394.7 x 1000.0 mm
Crossbeams
RC Electronics
Electronics Box
Rudders
Daggerboards
Rig Standing
Mainsail
Jib
Hull Port
Hull Stbd
