fmaleev/RC-Foiling-Cat/mini/stl/Hull_Port_Seg_2.stl

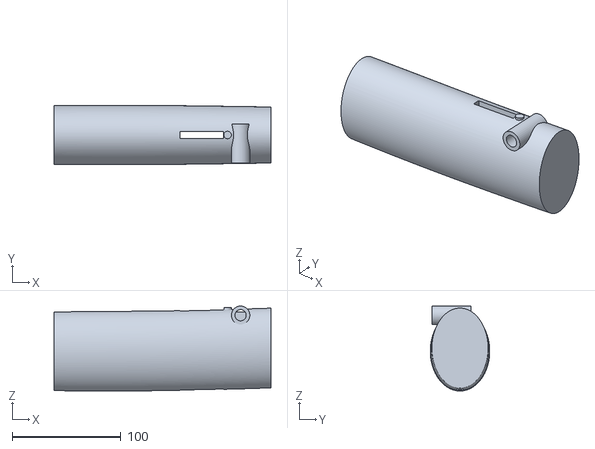
[picture p22: CAD file, 2026-09-25]
mini/stl/Hull_Port_Seg_2.stl
200.0 x 54.8 x 78.3
