fmaleev/RC-Foiling-Cat/stl/Pod_Lid_Seg_2_x455_600.stl

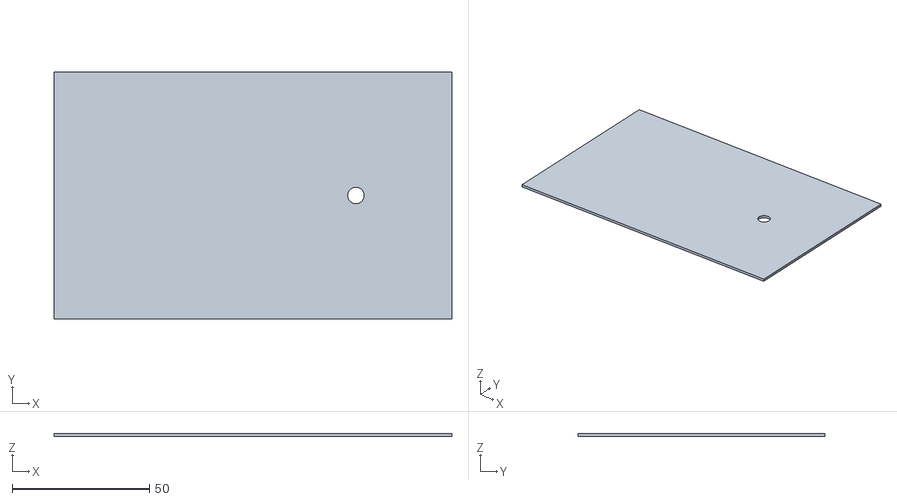
[picture p23: CAD file, 2026-09-27]
stl/Pod_Lid_Seg_2_x455_600.stl
145.0 x 90.0 x 1.20
