fmaleev/RC-Foiling-Cat/cad/RC_Foiling_Catamaran_v2.3.step

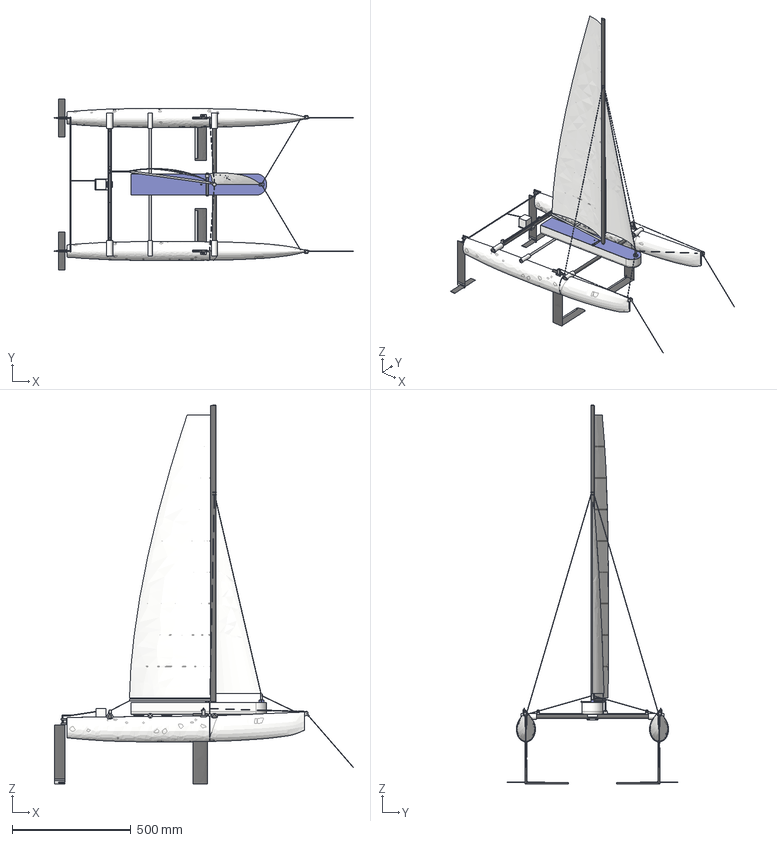
[picture p24: CAD file, 2026-09-27]
cad/RC_Foiling_Catamaran_v2.3.step
1258.6 x 720.0 x 1594.5 mm
Crossbeams
Center Pod
Rudders
RC Electronics
Rig Standing
Mast
Mainsail
Jib
Ride Height Control
Hull Port
Hull Stbd
Foiling Kit
