fmaleev/RC-Foiling-Cat/mini/stl/Box_Half_2.stl

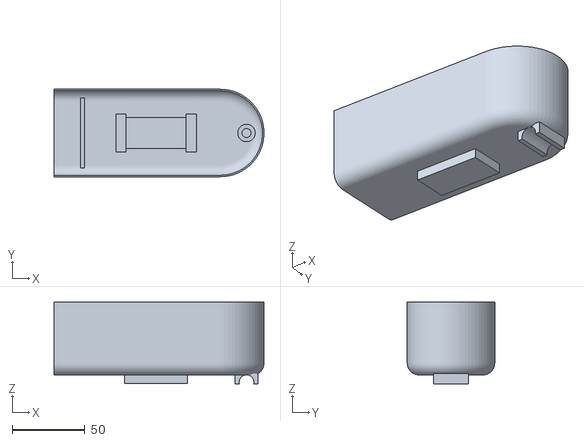
[picture p25: CAD file, 2026-09-25]
mini/stl/Box_Half_2.stl
144.0 x 60.0 x 56.2
