fmaleev/RC-Foiling-Cat/stl/Pod_Shell_Seg_3_x600_720.stl

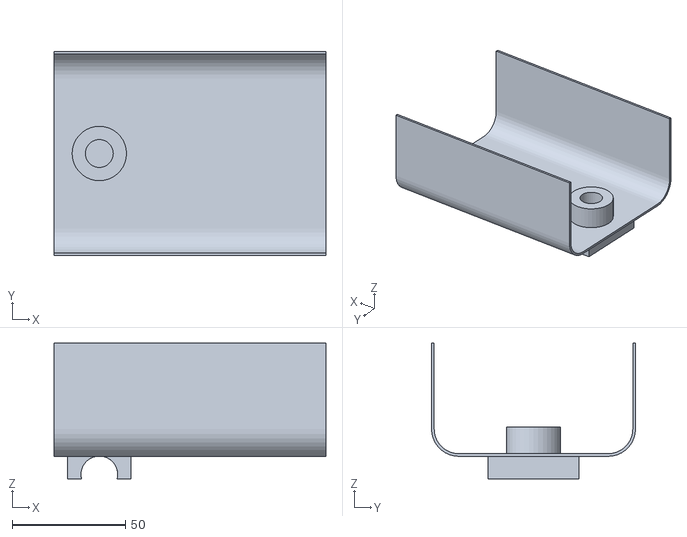
[picture p26: CAD file, 2026-09-27]
stl/Pod_Shell_Seg_3_x600_720.stl
120.0 x 90.0 x 60.0
