fmaleev/RC-Foiling-Cat/cad/RC_Catamaran_v1.4_Build_First_no_foils.step

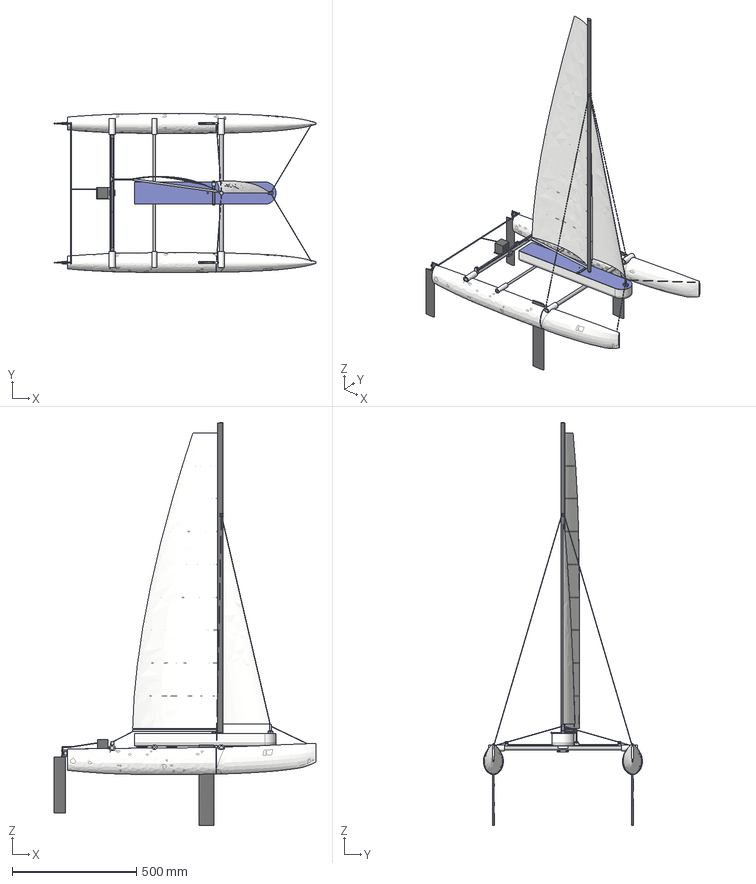
[picture p27: CAD file, 2026-09-27]
cad/RC_Catamaran_v1.4_Build_First_no_foils.step
1053.0 x 640.2 x 1622.5 mm
Crossbeams
Center Pod
Rudders
RC Electronics
Displacement Kit
Rig Standing
Mast
Mainsail
Jib
Hull Port
Hull Stbd
