fmaleev/RC-Foiling-Cat/mini/stl/Daggerboard_x2.stl

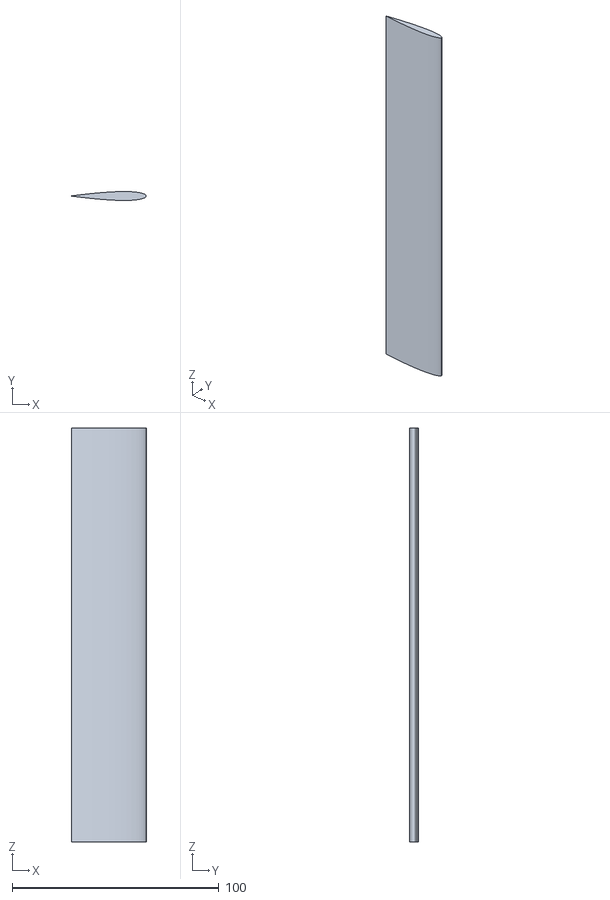
[picture p28: CAD file, 2026-09-25]
mini/stl/Daggerboard_x2.stl
36.0 x 4.30 x 200.0
