fmaleev/RC-Foiling-Cat/stl/Daggerboard_Upper_x2.stl

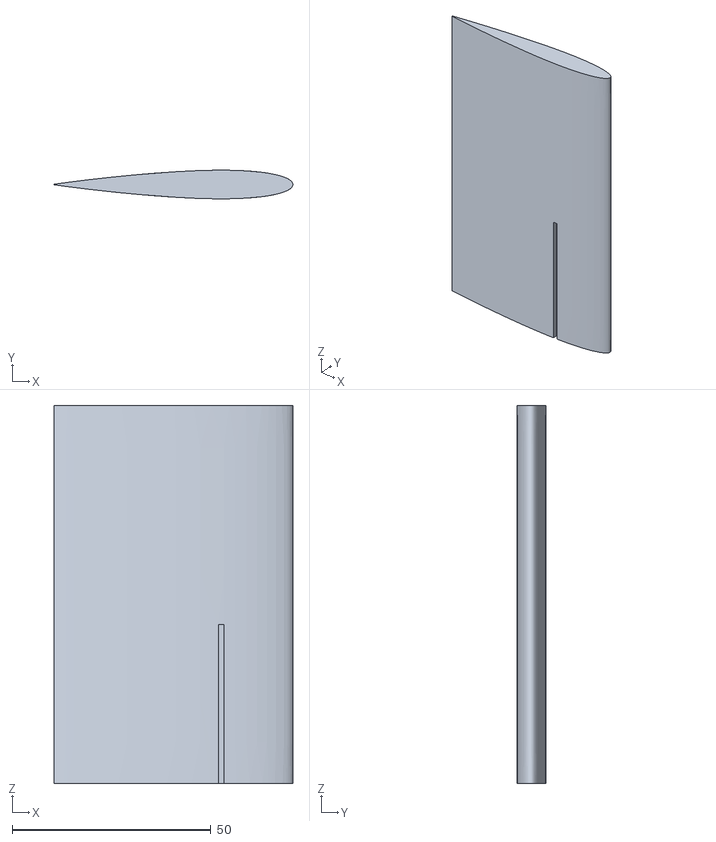
[picture p29: CAD file, 2026-09-27]
stl/Daggerboard_Upper_x2.stl
60.0 x 7.20 x 95.0
