fmaleev/RC-Foiling-Cat/stl/Pod_Shell_Seg_1_x270_455.stl

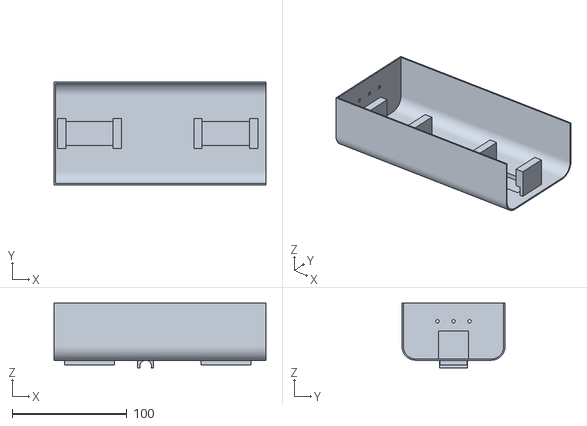
[picture p30: CAD file, 2026-09-27]
stl/Pod_Shell_Seg_1_x270_455.stl
185.0 x 90.0 x 56.7
