fmaleev/RC-Foiling-Cat/mini/stl/Gudgeon_x2.stl

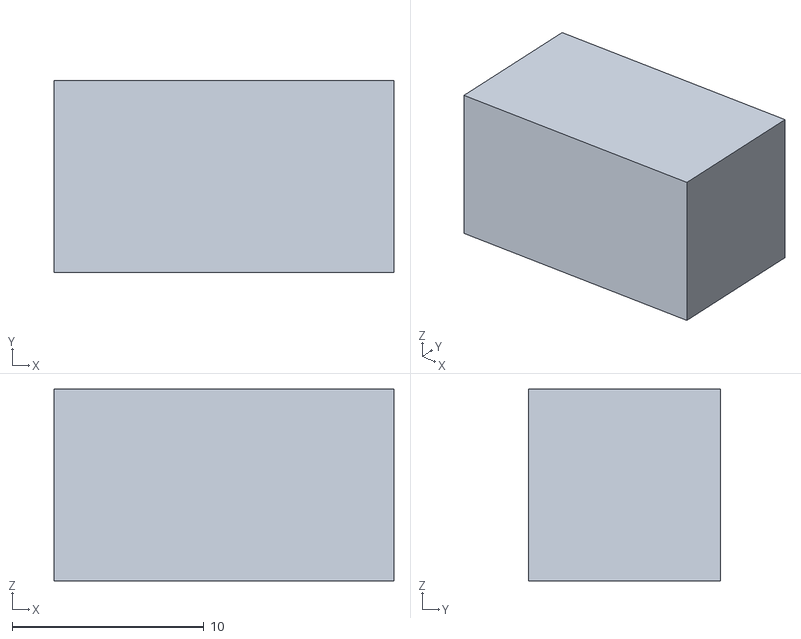
[picture p31: CAD file, 2026-09-25]
mini/stl/Gudgeon_x2.stl
17.8 x 10.0 x 10.0
