fmaleev/RC-Foiling-Cat/stl/Pod_Shell_Seg_2_x455_600.stl

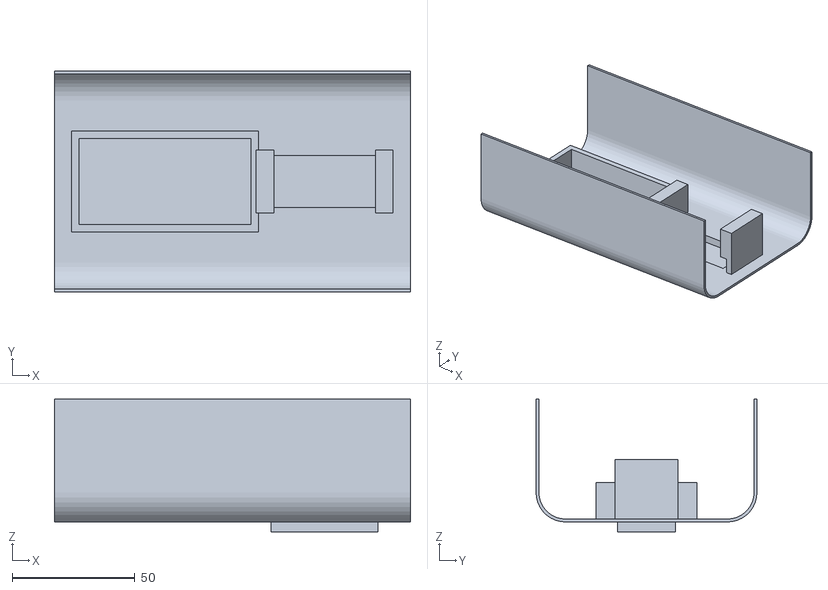
[picture p32: CAD file, 2026-09-27]
stl/Pod_Shell_Seg_2_x455_600.stl
145.0 x 90.0 x 54.0
