fmaleev/RC-Foiling-Cat/cad/Foiling_Kit_v2.1_carbon_parts_with_flaps.step

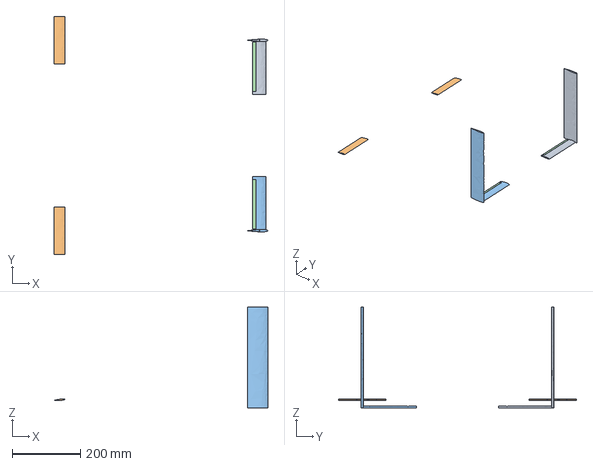
[picture p33: CAD file, 2026-09-25]
cad/Foiling_Kit_v2.1_carbon_parts_with_flaps.step
628.9 x 700.0 x 296.2 mm
