fmaleev/RC-Foiling-Cat/mini/stl/Rudder_Blade_x2.stl

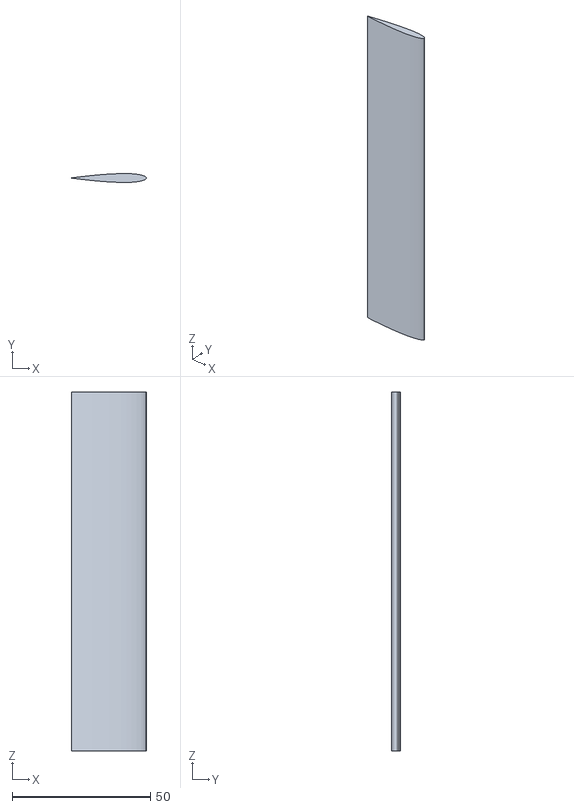
[picture p34: CAD file, 2026-09-25]
mini/stl/Rudder_Blade_x2.stl
27.0 x 3.23 x 130.0
