fmaleev/RC-Foiling-Cat/stl/Pod_Lid_Seg_4_x720_840.stl

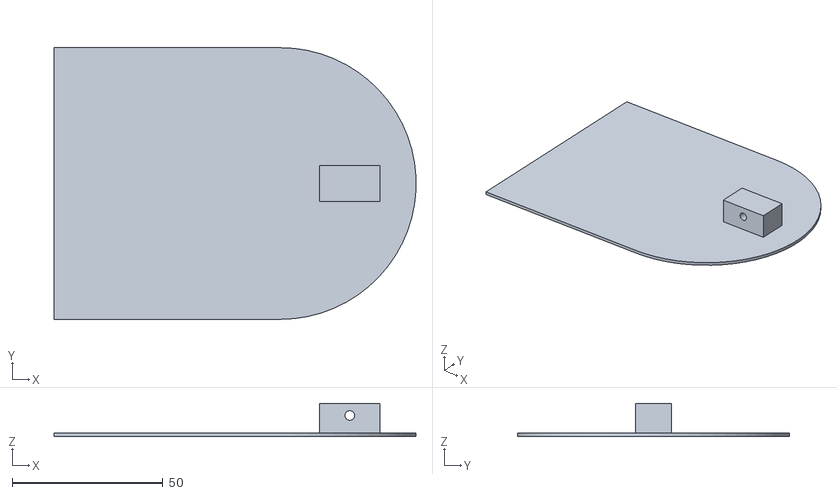
[picture p35: CAD file, 2026-09-27]
stl/Pod_Lid_Seg_4_x720_840.stl
119.9 x 90.0 x 11.0
