fmaleev/RC-Foiling-Cat/mini/stl/Box_Half_1.stl

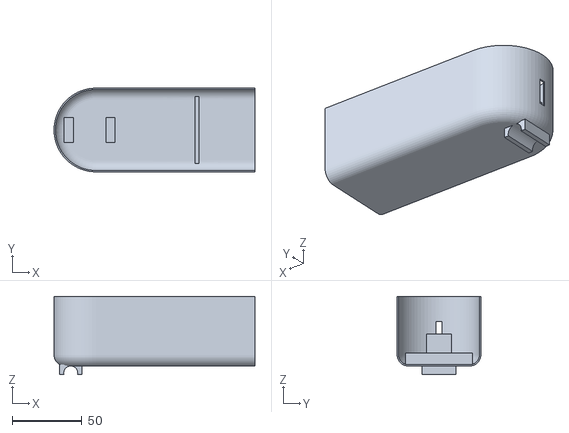
[picture p36: CAD file, 2026-09-25]
mini/stl/Box_Half_1.stl
144.0 x 60.0 x 56.2
