fmaleev/RC-Foiling-Cat/mini/stl/Hull_Port_Seg_3.stl

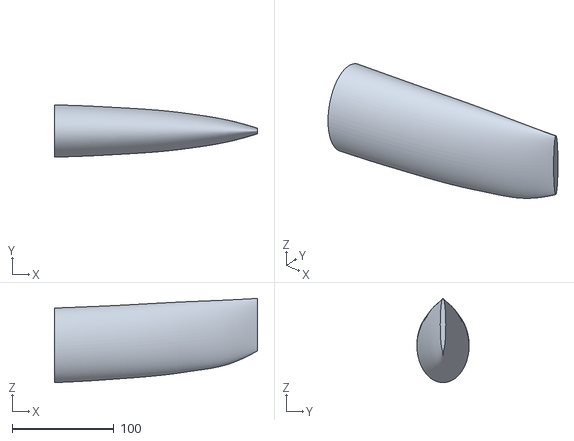
[picture p38: CAD file, 2026-09-25]
mini/stl/Hull_Port_Seg_3.stl
200.0 x 51.5 x 83.0
