fmaleev/RC-Foiling-Cat/stl/Pod_Shell_Seg_4_x720_840.stl

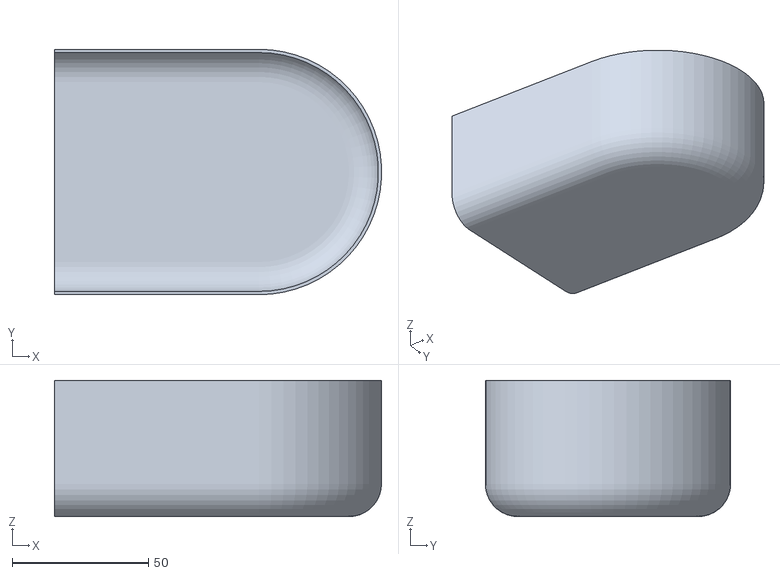
[picture p39: CAD file, 2026-09-27]
stl/Pod_Shell_Seg_4_x720_840.stl
119.9 x 90.0 x 50.0
