fmaleev/RC-Foiling-Cat/stl/Foil_Core_L_Port_Upper.stl

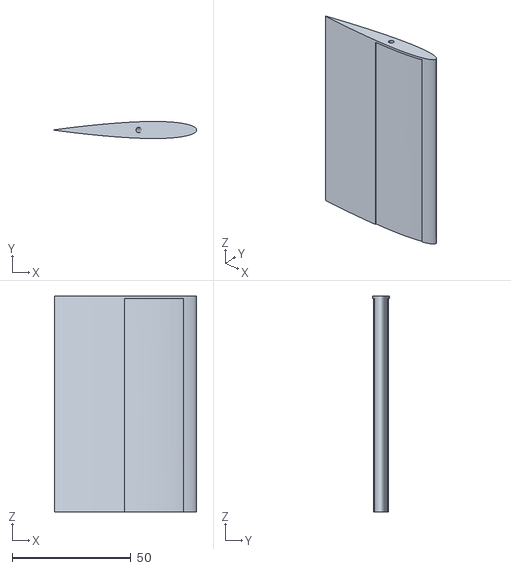
[picture p41: CAD file, 2026-09-27]
stl/Foil_Core_L_Port_Upper.stl
60.0 x 7.20 x 91.0
