fmaleev/RC-Foiling-Cat/stl/Foil_Core_L_Stbd_Lower.stl

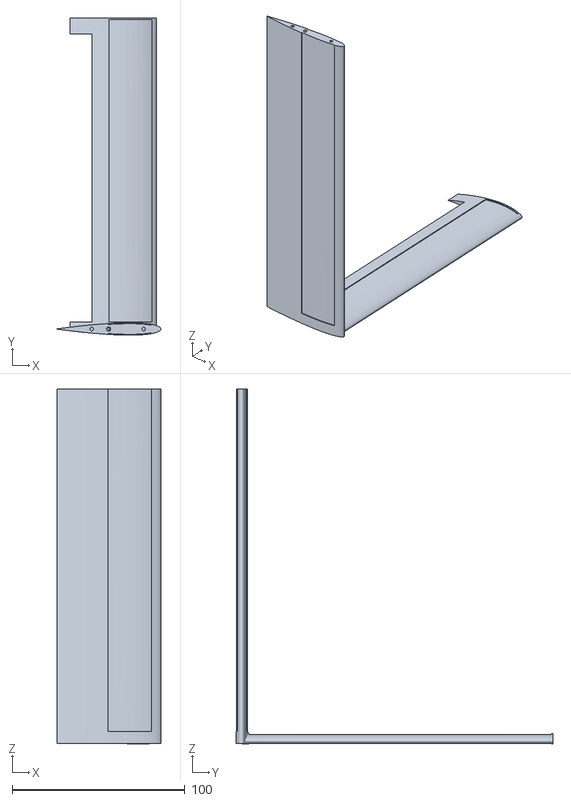
[picture p42: CAD file, 2026-09-27]
stl/Foil_Core_L_Stbd_Lower.stl
60.0 x 183.6 x 205.3
