fmaleev/RC-Foiling-Cat/mini/stl/Winch_Drum_stepped_30_16mm.stl

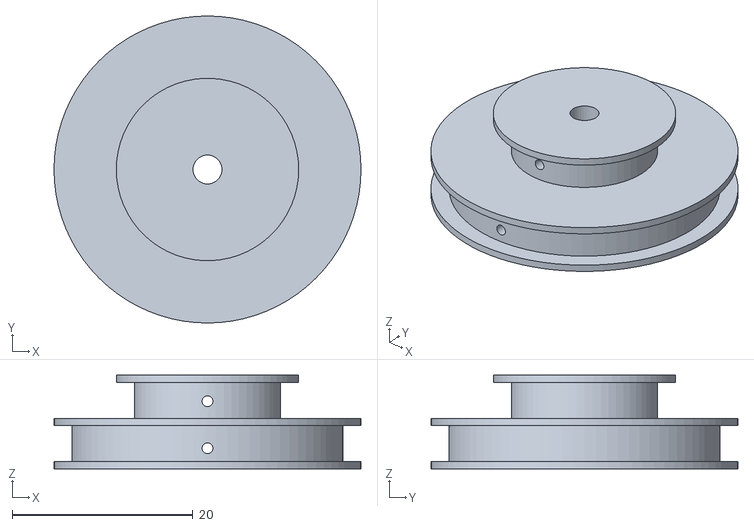
[picture p43: CAD file, 2026-09-25]
mini/stl/Winch_Drum_stepped_30_16mm.stl
34.0 x 34.0 x 10.4
