fmaleev/RC-Foiling-Cat/mini/stl/Hull_Port_Seg_1.stl

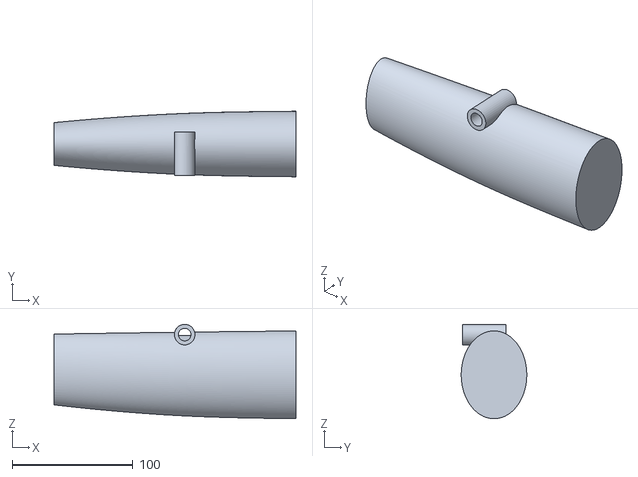
[picture p45: CAD file, 2026-09-25]
mini/stl/Hull_Port_Seg_1.stl
200.0 x 54.2 x 78.0
