fmaleev/RC-Foiling-Cat/stl/Foil_Flap_x2.stl

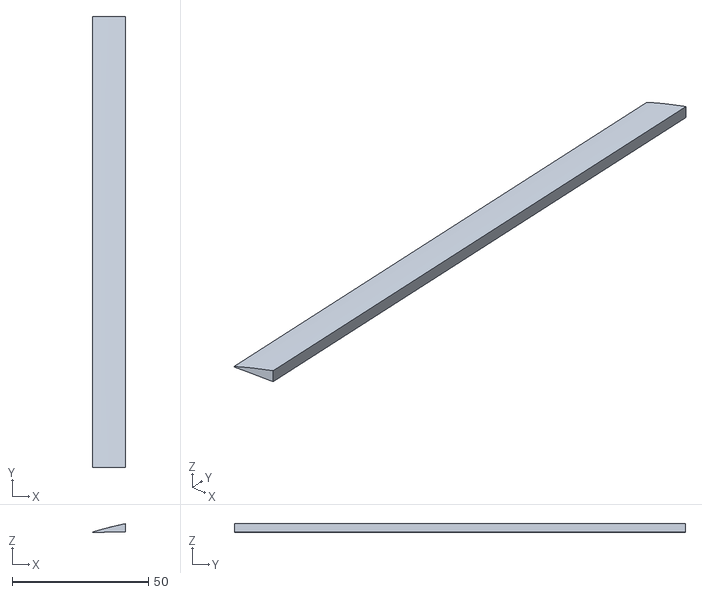
[picture p47: CAD file, 2026-09-27]
stl/Foil_Flap_x2.stl
12.2 x 165.5 x 3.27
