fmaleev/RC-Foiling-Cat/stl/Flap_Horn_x2.stl

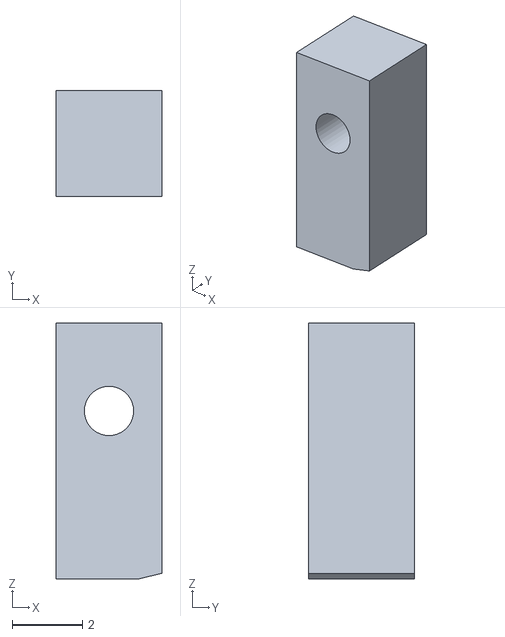
[picture p48: CAD file, 2026-09-27]
stl/Flap_Horn_x2.stl
3.00 x 3.00 x 7.28
