fmaleev/RC-Foiling-Cat/stl/Foiling_Rudder_Extension_x2.stl

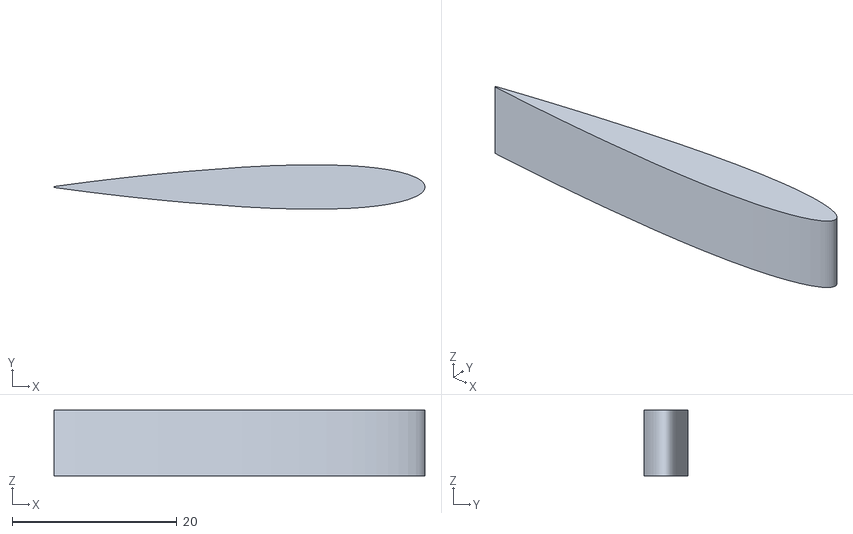
[picture p49: CAD file, 2026-09-27]
stl/Foiling_Rudder_Extension_x2.stl
45.0 x 5.38 x 8.00
