fmaleev/RC-Foiling-Cat/stl/Foil_Core_Elevator_x2.stl

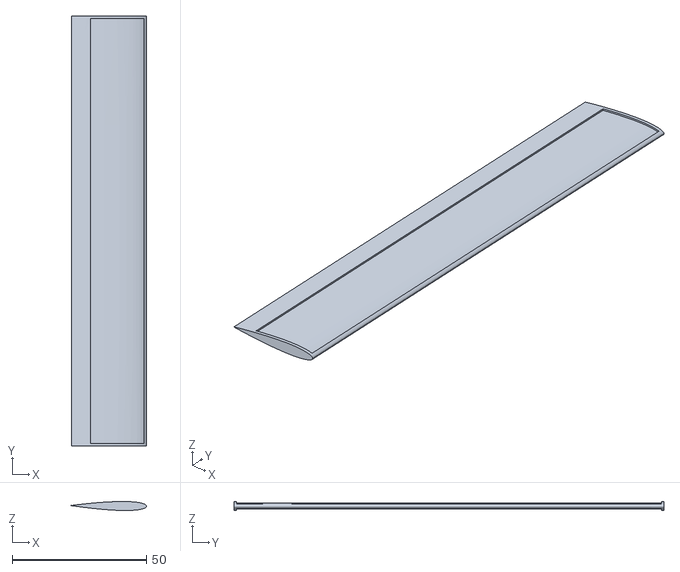
[picture p50: CAD file, 2026-09-27]
stl/Foil_Core_Elevator_x2.stl
28.0 x 160.0 x 3.36
