fmaleev/RC-Foiling-Cat/stl/Foil_Core_L_Port.stl

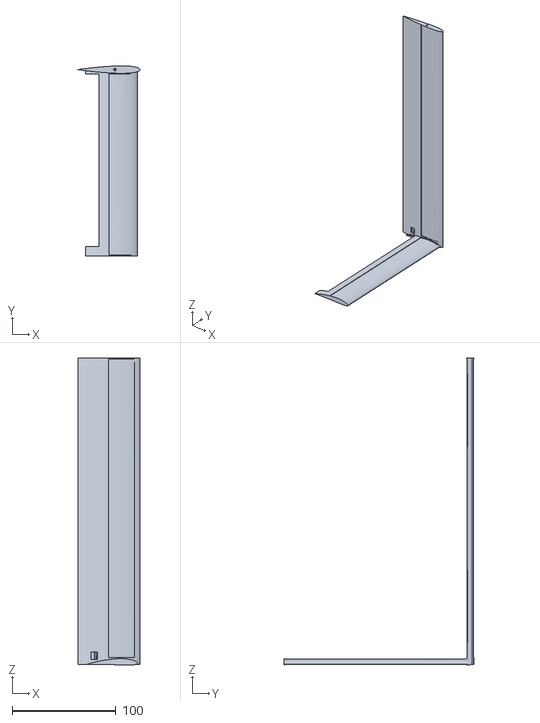
[picture p51: CAD file, 2026-09-27]
stl/Foil_Core_L_Port.stl
60.0 x 183.6 x 296.3
