fmaleev/RC-Foiling-Cat/stl/Elevator_Trim_Pod_x2.stl

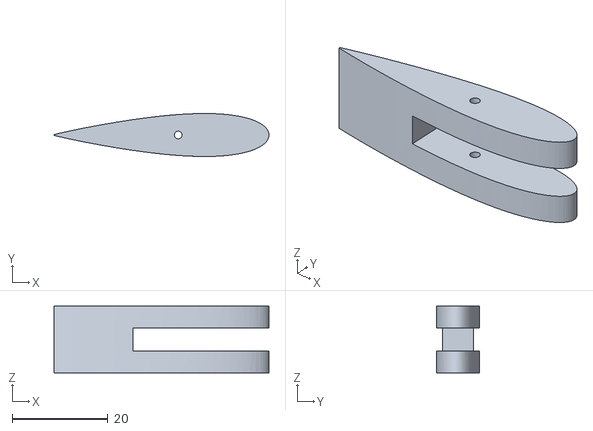
[picture p52: CAD file, 2026-09-27]
stl/Elevator_Trim_Pod_x2.stl
45.0 x 9.00 x 14.0
