fmaleev/RC-Foiling-Cat/stl/Boom_Jaw.stl

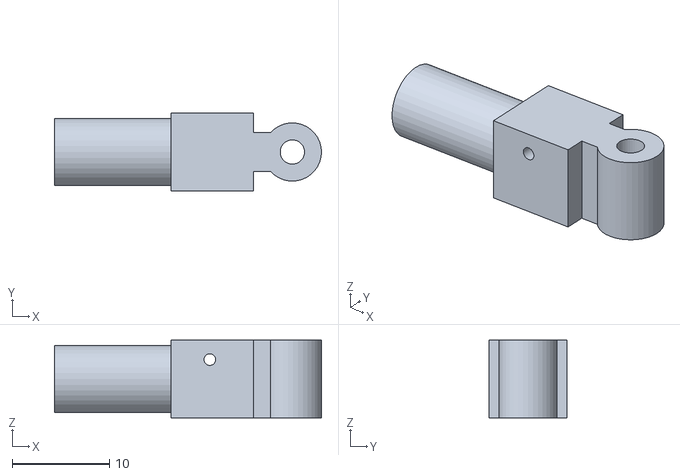
[picture p53: CAD file, 2026-09-27]
stl/Boom_Jaw.stl
27.5 x 8.00 x 8.00
