fmaleev/RC-Foiling-Cat/stl/Gooseneck.stl

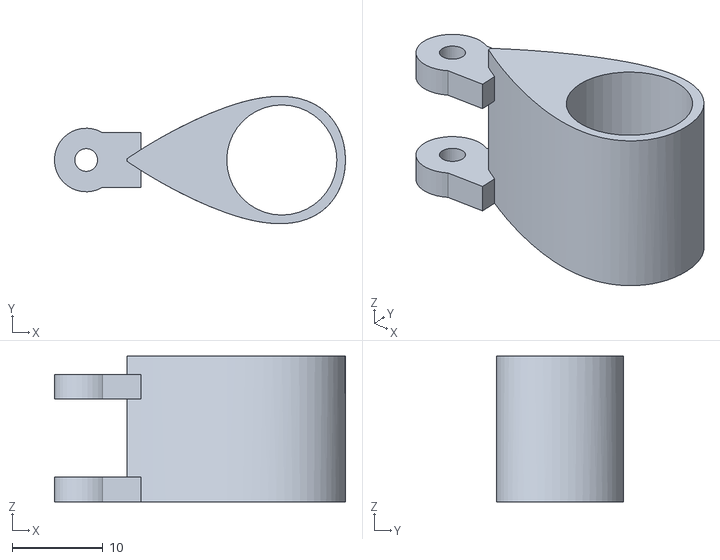
[picture p54: CAD file, 2026-09-27]
stl/Gooseneck.stl
32.0 x 14.0 x 16.0
