fmaleev/RC-Foiling-Cat/stl/Traveler_Track_Centre.stl

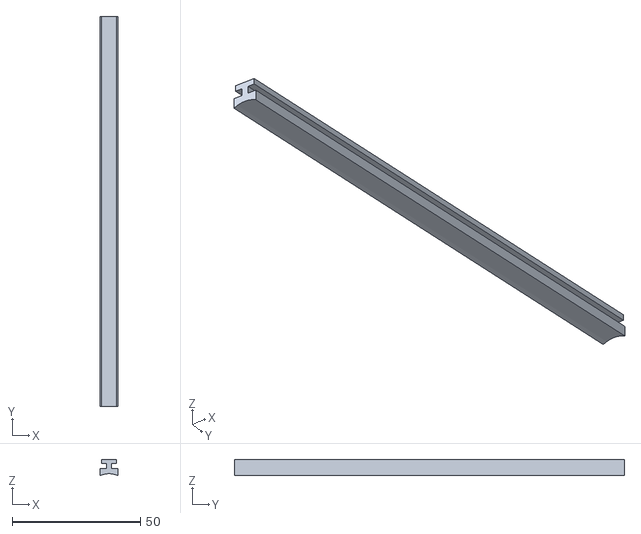
[picture p55: CAD file, 2026-09-27]
stl/Traveler_Track_Centre.stl
7.00 x 152.0 x 6.41
