fmaleev/RC-Foiling-Cat/stl/Traveler_Car.stl

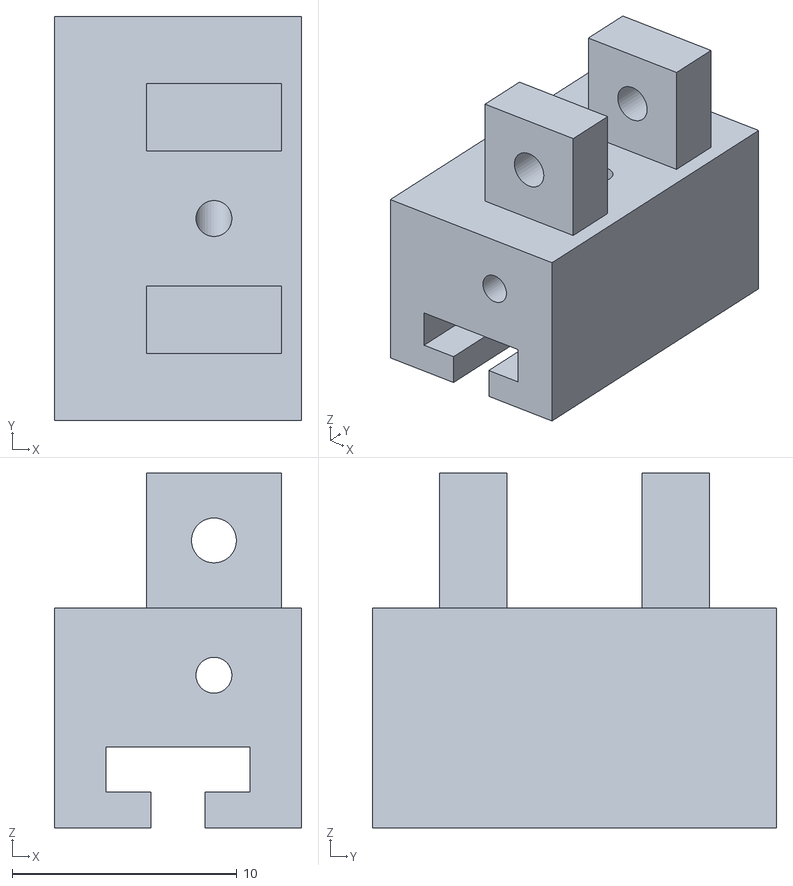
[picture p56: CAD file, 2026-09-27]
stl/Traveler_Car.stl
11.0 x 18.0 x 15.8
