fmaleev/RC-Foiling-Cat/stl/Traveler_Track_Port.stl

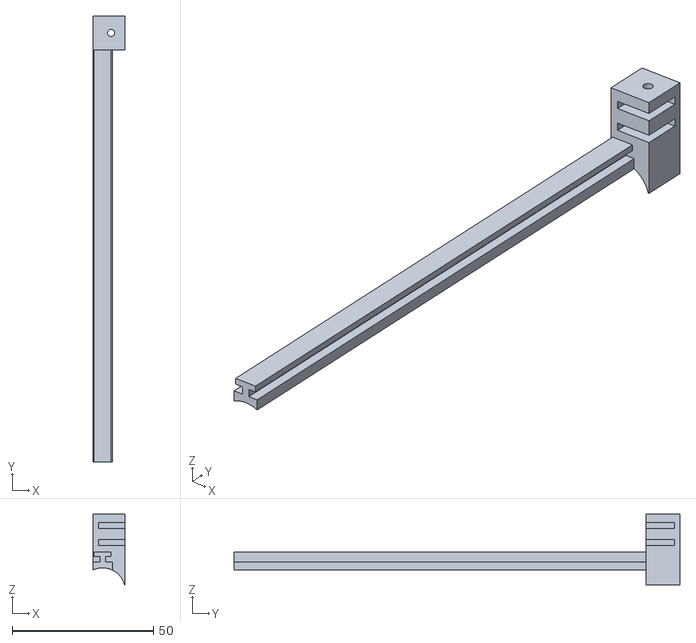
[picture p57: CAD file, 2026-09-27]
stl/Traveler_Track_Port.stl
11.5 x 158.0 x 25.0
