fmaleev/RC-Foiling-Cat/stl/Jib_Car.stl

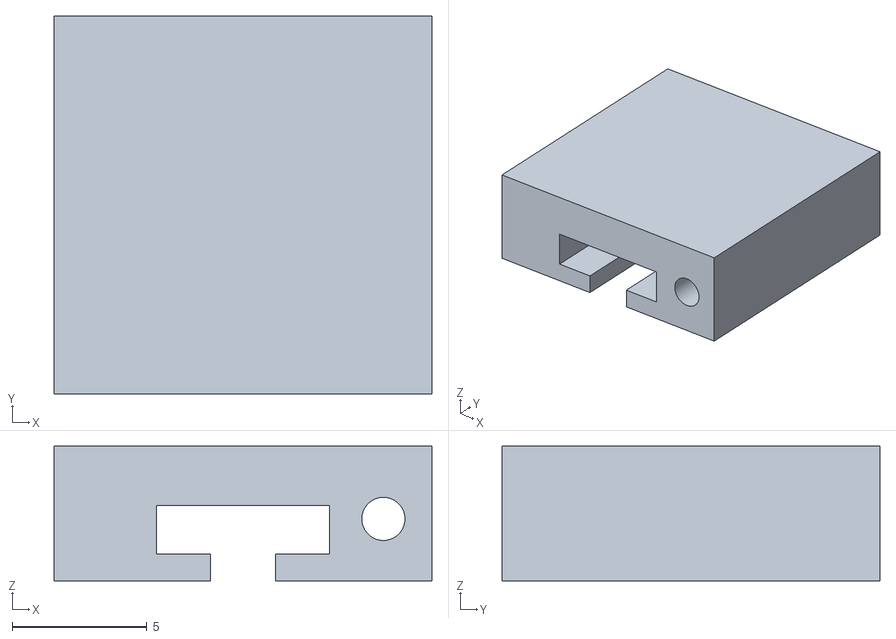
[picture p58: CAD file, 2026-09-27]
stl/Jib_Car.stl
14.0 x 14.0 x 5.00
