fmaleev/RC-Foiling-Cat/stl/Gudgeon_x2.stl

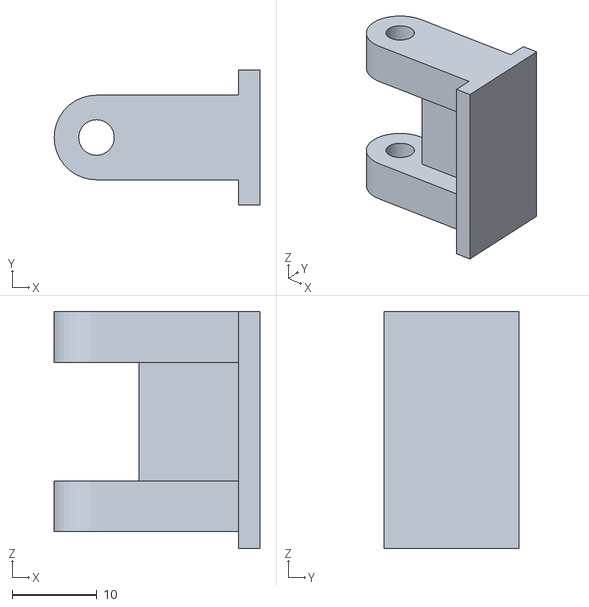
[picture p59: CAD file, 2026-09-27]
stl/Gudgeon_x2.stl
24.3 x 16.0 x 28.0
