fmaleev/RC-Foiling-Cat/stl/Bridle_Post.stl

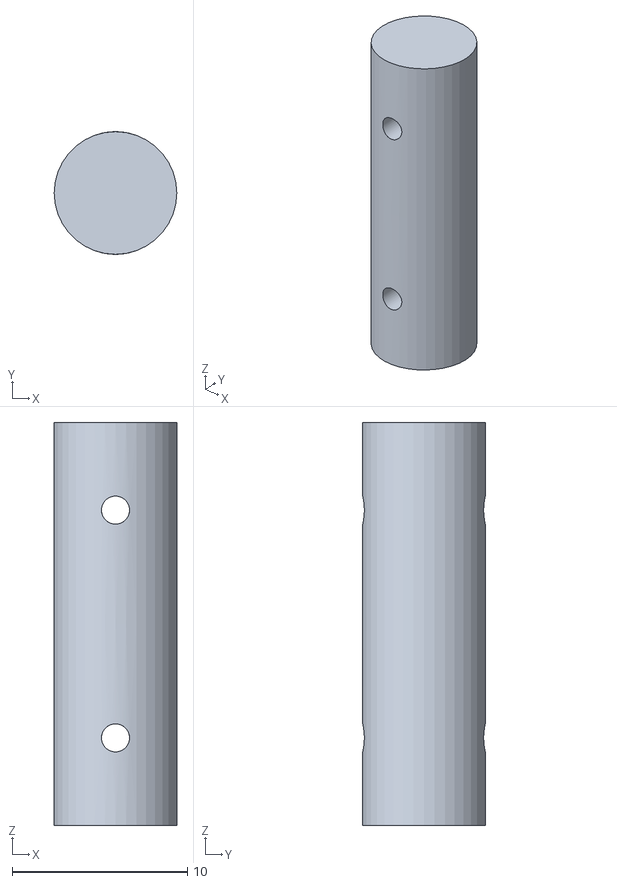
[picture p60: CAD file, 2026-09-27]
stl/Bridle_Post.stl
7.00 x 7.00 x 23.0
