fmaleev/RC-Foiling-Cat/stl/Wand_Hub_x2.stl

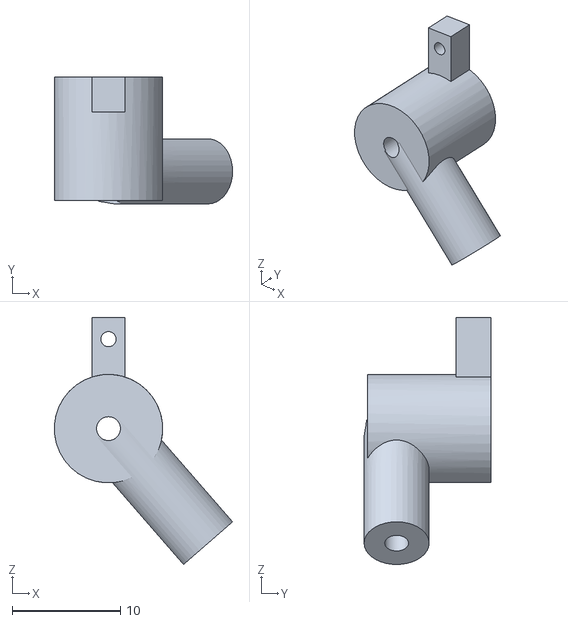
[picture p61: CAD file, 2026-09-27]
stl/Wand_Hub_x2.stl
16.4 x 11.7 x 22.8
