fmaleev/RC-Foiling-Cat/stl/Mast_Cap.stl

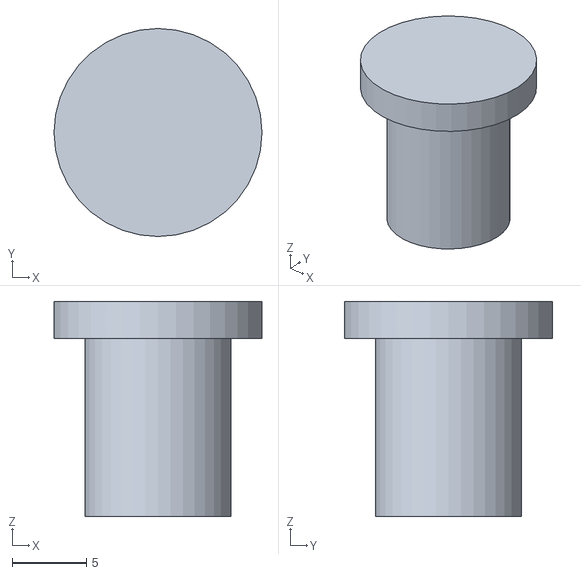
[picture p62: CAD file, 2026-09-27]
stl/Mast_Cap.stl
14.0 x 14.0 x 14.5
