fmaleev/RC-Foiling-Cat/stl/Hounds_Collar.stl

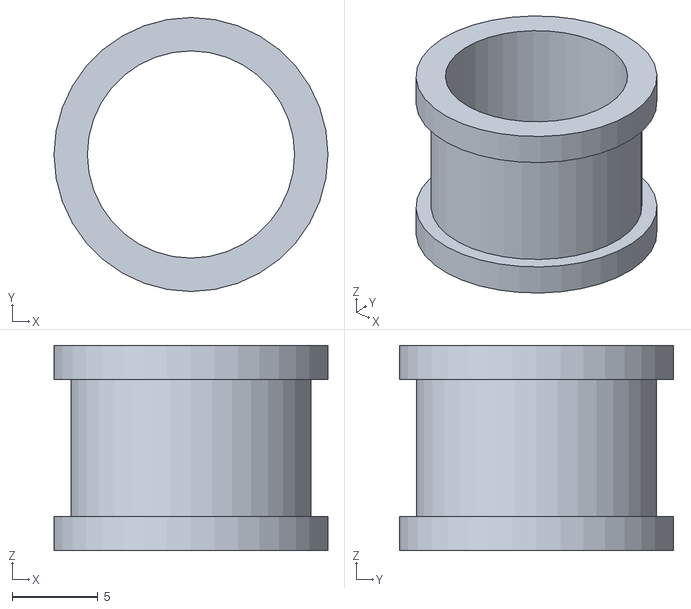
[picture p63: CAD file, 2026-09-27]
stl/Hounds_Collar.stl
16.0 x 16.0 x 12.0
