fmaleev/RC-Foiling-Cat/stl/Mast_Fairing_Upper_x2.stl

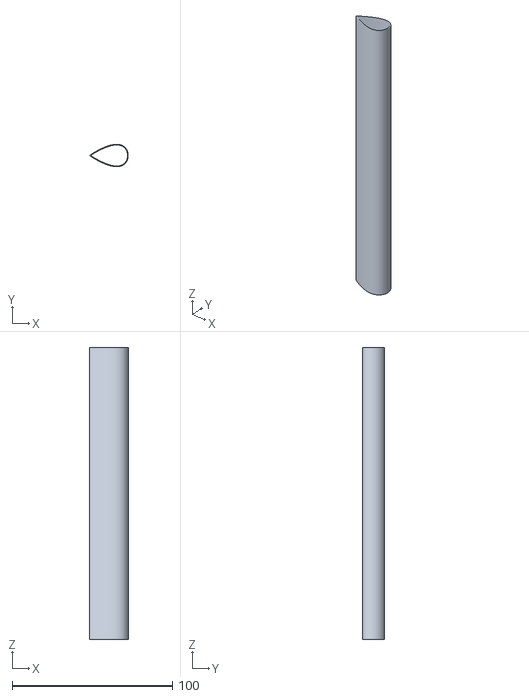
[picture p64: CAD file, 2026-09-27]
stl/Mast_Fairing_Upper_x2.stl
24.0 x 14.0 x 182.0
