fmaleev/RC-Foiling-Cat/stl/Jib_Track.stl

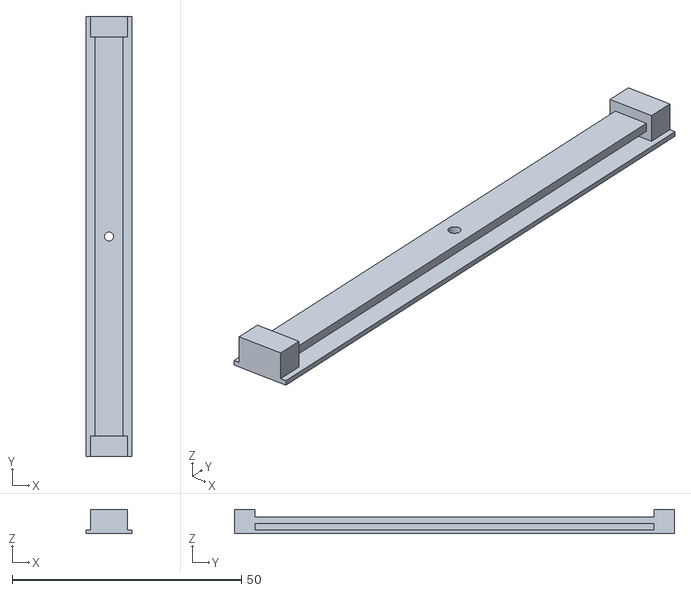
[picture p65: CAD file, 2026-09-27]
stl/Jib_Track.stl
10.0 x 96.0 x 5.30
