fmaleev/RC-Foiling-Cat/stl/Strut_Bellcrank_x2.stl

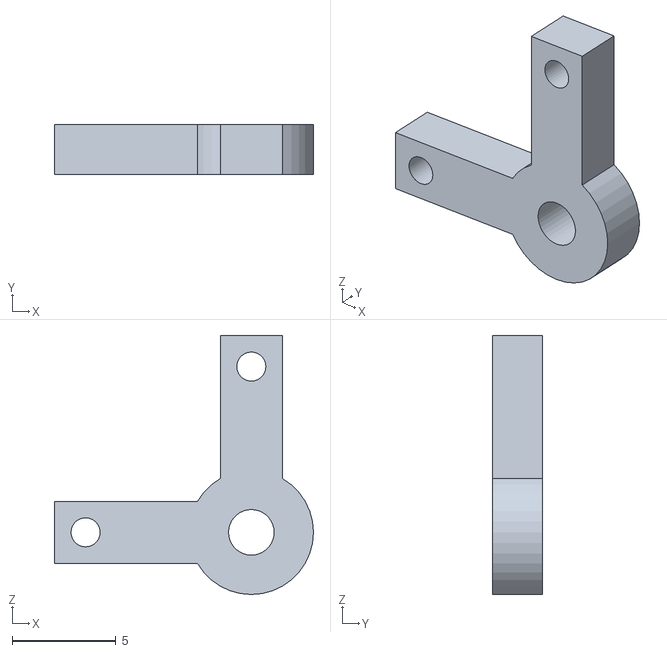
[picture p66: CAD file, 2026-09-27]
stl/Strut_Bellcrank_x2.stl
12.5 x 2.40 x 12.5
