fmaleev/RC-Foiling-Cat/stl/Bellcrank_Mount_x2.stl

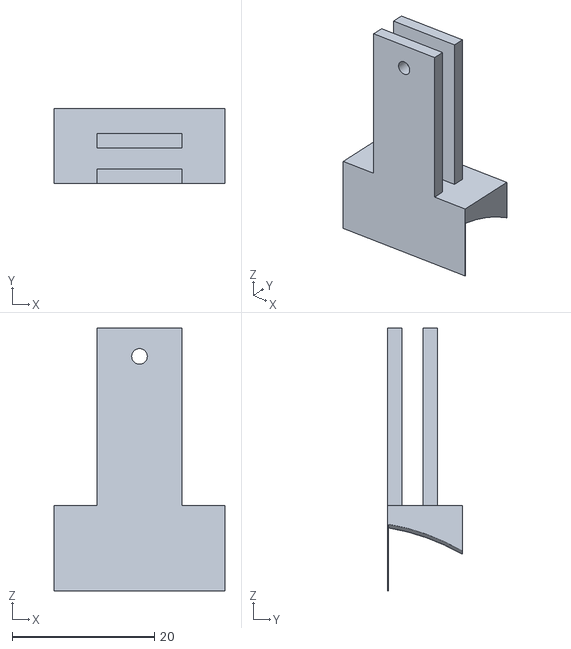
[picture p67: CAD file, 2026-09-27]
stl/Bellcrank_Mount_x2.stl
24.0 x 10.5 x 37.0
