fmaleev/RC-Foiling-Cat/stl/Wand_Hinge_Bracket_x2.stl

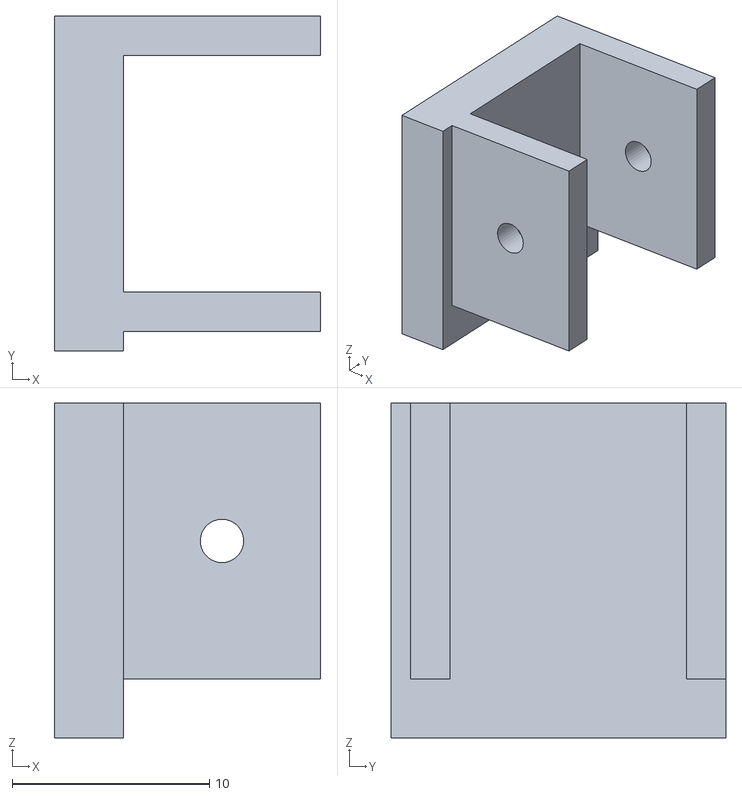
[picture p68: CAD file, 2026-09-27]
stl/Wand_Hinge_Bracket_x2.stl
13.5 x 17.0 x 17.0
