fmaleev/RC-Foiling-Cat/stl/Mast_Fairing_Lower_x5.stl

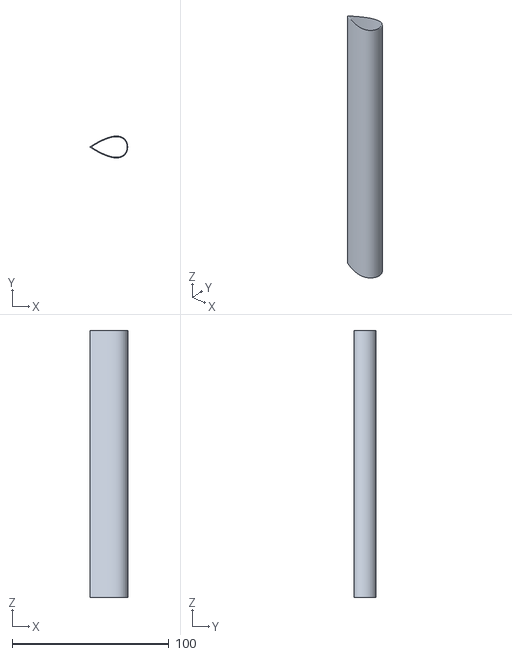
[picture p69: CAD file, 2026-09-27]
stl/Mast_Fairing_Lower_x5.stl
24.0 x 14.0 x 170.6
