fmaleev/RC-Foiling-Cat/stl/Hull_Stbd_Seg_3_x400_600.stl

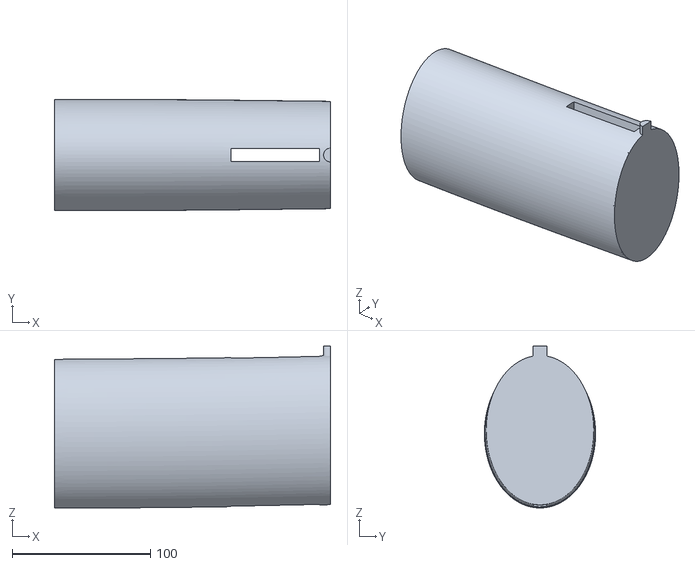
[picture p70: CAD file, 2026-09-25]
stl/Hull_Stbd_Seg_3_x400_600.stl
200.0 x 80.6 x 117.3
