fmaleev/RC-Foiling-Cat/stl/Hull_Stbd_Seg_4_x600_800.stl

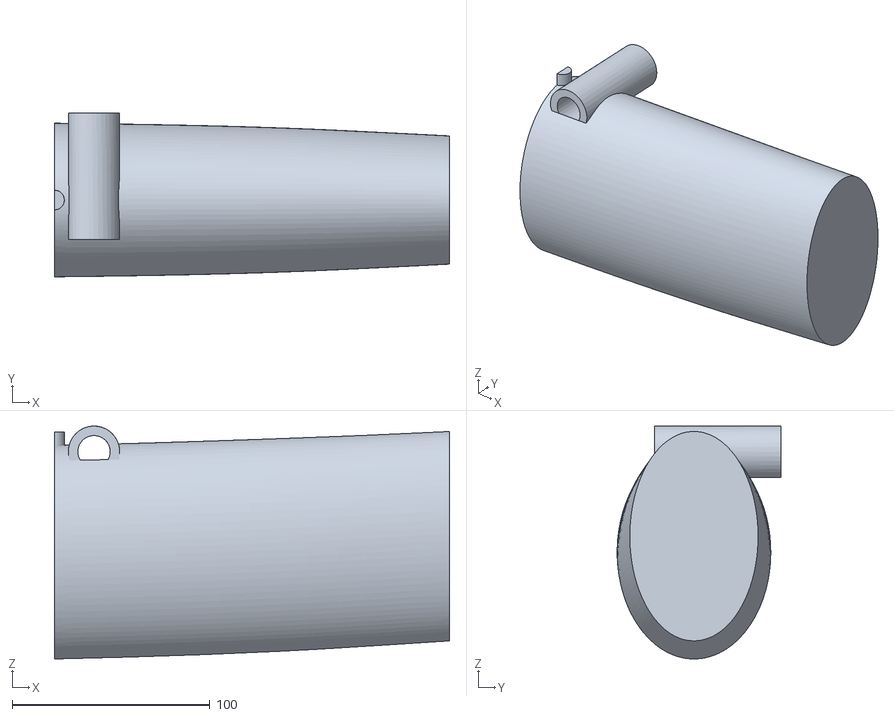
[picture p71: CAD file, 2026-09-25]
stl/Hull_Stbd_Seg_4_x600_800.stl
200.0 x 82.9 x 117.9
