fmaleev/RC-Foiling-Cat/stl/Daggerboard_x2.stl

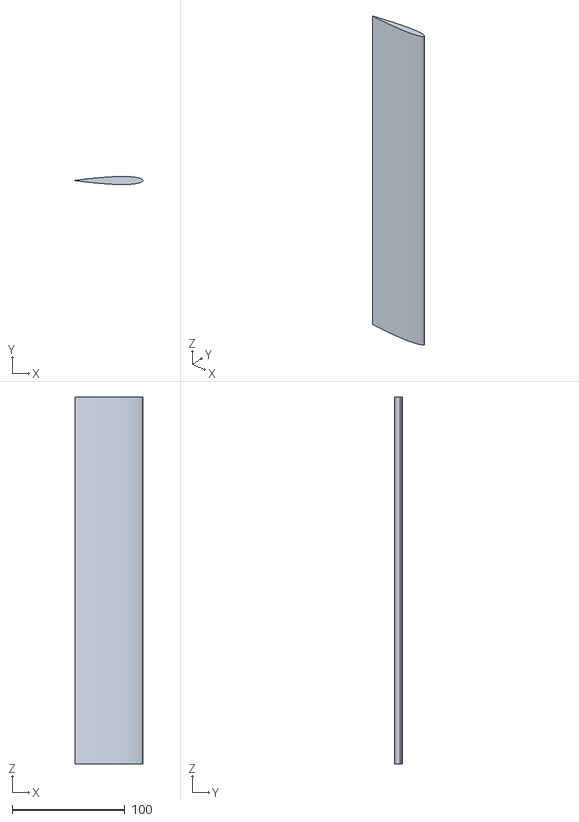
[picture p72: CAD file, 2026-09-25]
stl/Daggerboard_x2.stl
60.0 x 7.17 x 325.0
