fmaleev/RC-Foiling-Cat/stl/Rudder_Blade_x2.stl

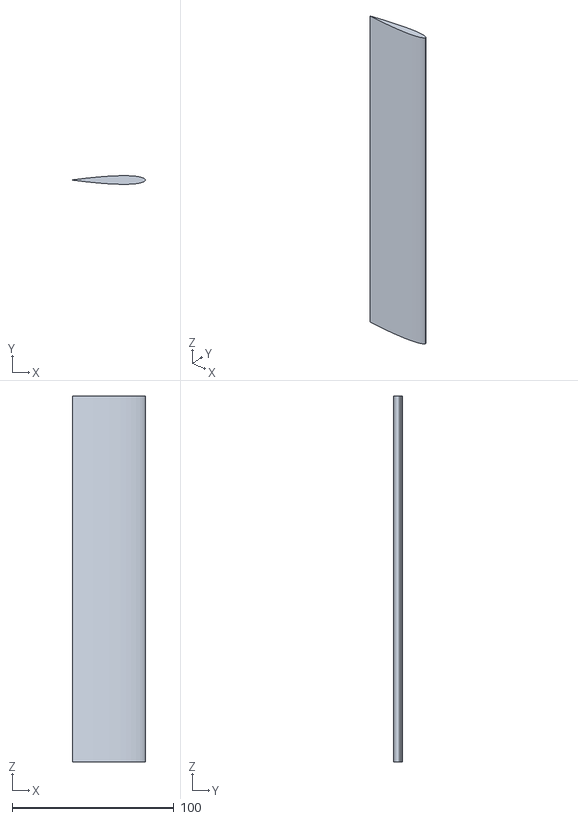
[picture p73: CAD file, 2026-09-25]
stl/Rudder_Blade_x2.stl
45.0 x 5.38 x 226.0
