fmaleev/RC-Foiling-Cat/stl/Hull_Port_Seg_5_x800_1000.stl

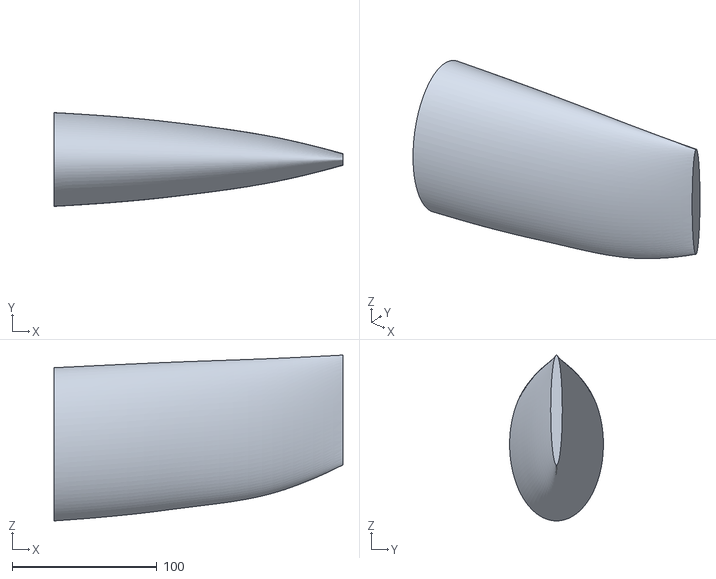
[picture p74: CAD file, 2026-09-25]
stl/Hull_Port_Seg_5_x800_1000.stl
200.0 x 64.9 x 114.8
