fmaleev/RC-Foiling-Cat/stl/Hull_Port_Seg_1_x0_200.stl

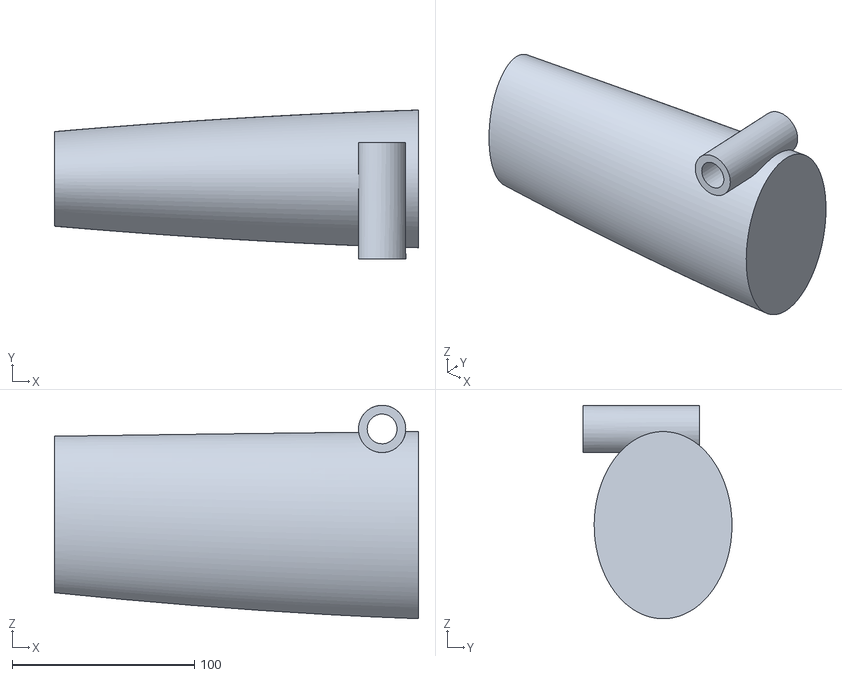
[picture p75: CAD file, 2026-09-25]
stl/Hull_Port_Seg_1_x0_200.stl
200.0 x 81.9 x 117.3
