fmaleev/RC-Foiling-Cat/stl/Hull_Stbd_Seg_2_x200_400.stl

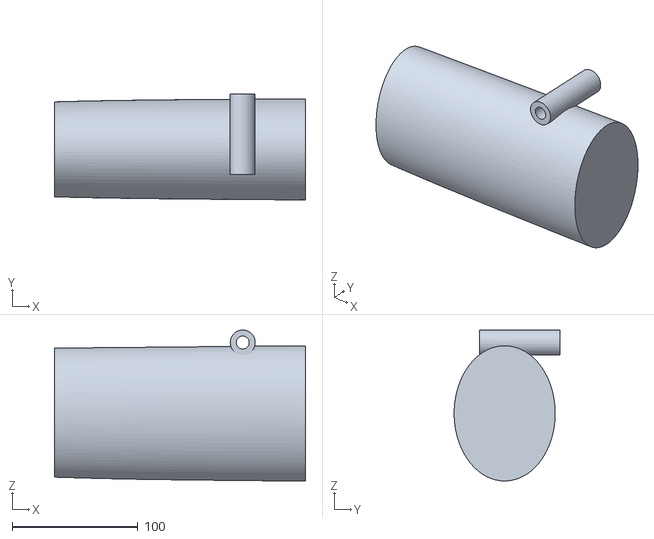
[picture p76: CAD file, 2026-09-25]
stl/Hull_Stbd_Seg_2_x200_400.stl
200.0 x 84.3 x 120.3
