fmaleev/RC-Foiling-Cat/stl/Rudder_Servo_Cover.stl

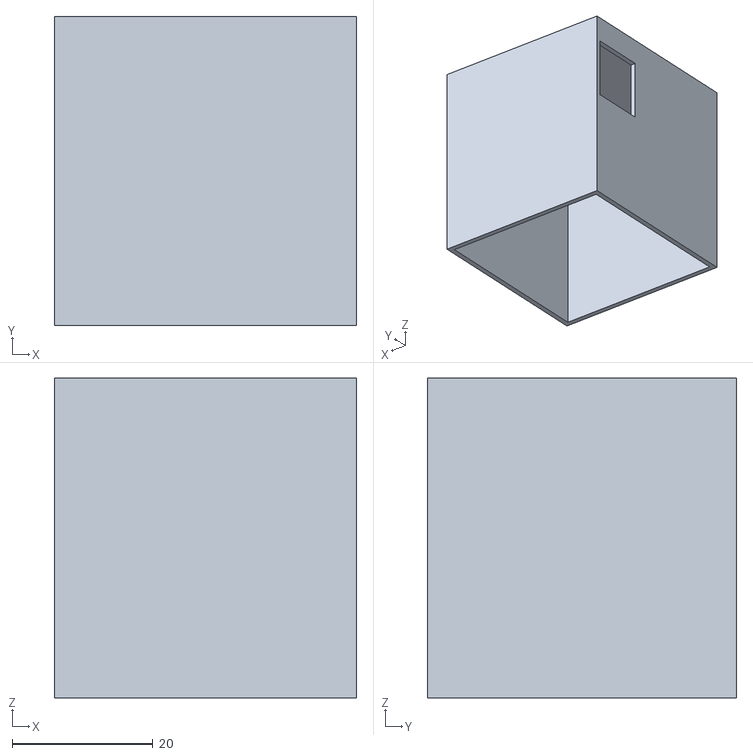
[picture p77: CAD file, 2026-09-25]
stl/Rudder_Servo_Cover.stl
43.0 x 44.0 x 45.5
