fmaleev/RC-Foiling-Cat/stl/Rudder_Servo_Bracket.stl

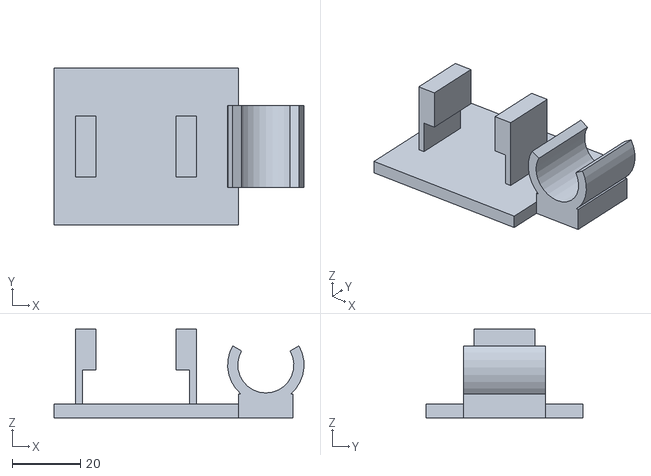
[picture p78: CAD file, 2026-09-25]
stl/Rudder_Servo_Bracket.stl
73.2 x 46.0 x 26.0
