fmaleev/RC-Foiling-Cat/(list of files, cad)

Other CAD files:
mini/stl/Hull_Stbd_Seg_2.stl
mini/stl/Box_Lid_Half_2.stl
stl/Foil_Core_L_Stbd_Upper.stl
mini/stl/Hull_Stbd_Seg_1.stl
mini/stl/Hull_Stbd_Seg_3.stl
stl/Foil_Core_L_Port_Lower.stl
stl/Foil_Core_L_Stbd.stl
stl/Traveler_Track_Stbd.stl
stl/Hull_Port_Seg_4_x600_800.stl
stl/Hull_Port_Seg_3_x400_600.stl
stl/Hull_Stbd_Seg_5_x800_1000.stl
stl/Hull_Stbd_Seg_1_x0_200.stl
stl/Hull_Port_Seg_2_x200_400.stl
cad/Foiling_Kit_v2.2_carbon_parts_flaps_rudder_extensions.step
cad/RC_Catamaran_v1.4_Build_First_no_foils.f3d
cad/RC_Foiling_Catamaran_v2.1.f3d
cad/RC_Foiling_Catamaran_v2.1.step
cad/RC_Foiling_Catamaran_v2.2.f3d
cad/RC_Foiling_Catamaran_v2.2.step
cad/RC_Foiling_Catamaran_v2.3.f3d
mini/cad/RC_Mini_Cat_600.f3d
