fmaleev/RC-Foiling-Cat/manual_1m/sail_patterns_1m_1to1.tex

\documentclass[border=10mm]{standalone}
\usepackage{tikz}
\begin{document}\begin{tikzpicture}[x=1mm,y=1mm,font=\sffamily\small]
\draw[very thick] (0,0) -- (345.0,0.0) -- (344.5,29.8) -- (343.5,59.5) -- (342.1,89.2) -- (340.2,119.0) -- (338.0,148.8) -- (335.5,178.5) -- (332.6,208.2) -- (329.4,238.0) -- (326.0,267.8) -- (322.3,297.5) -- (318.3,327.2) -- (314.0,357.0) -- (309.5,386.8) -- (304.7,416.5) -- (299.7,446.2) -- (294.5,476.0) -- (289.0,505.8) -- (283.2,535.5) -- (277.3,565.2) -- (271.1,595.0) -- (264.7,624.8) -- (258.1,654.5) -- (251.3,684.2) -- (244.3,714.0) -- (237.1,743.8) -- (229.6,773.5) -- (222.0,803.2) -- (214.1,833.0) -- (206.1,862.8) -- (197.8,892.5) -- (189.4,922.2) -- (180.8,952.0) -- (171.9,981.8) -- (162.9,1011.5) -- (153.7,1041.2) -- (144.4,1071.0) -- (134.8,1100.8) -- (125.0,1130.5) -- (115.1,1160.2) -- (105.0,1190.0) -- (0,1190.0) -- cycle;
\draw[blue, thick] (4,132.2) -- (335.3,132.2) node[right,black] {batten 331 mm};
\draw[blue, thick] (4,264.4) -- (322.4,264.4) node[right,black] {batten 318 mm};
\draw[blue, thick] (4,396.7) -- (303.9,396.7) node[right,black] {batten 300 mm};
\draw[blue, thick] (4,528.9) -- (280.5,528.9) node[right,black] {batten 276 mm};
\draw[blue, thick] (4,661.1) -- (252.6,661.1) node[right,black] {batten 249 mm};
\draw[blue, thick] (4,793.3) -- (220.5,793.3) node[right,black] {batten 216 mm};
\draw[blue, thick] (4,925.6) -- (184.4,925.6) node[right,black] {batten 180 mm};
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
\draw[gray] (647.6,827.0) -- (659.6,827.0); \node[gray,anchor=west] at (661.6,827.0) {h=827: 12.0};
\draw[thick] (0,-20) -- (100,-20) node[midway,below] {scale check: this bar must measure 100 mm};
\end{tikzpicture}\end{document}
