fmaleev/RC-Foiling-Cat/mini/manual/sail_patterns_1to1.tex

\documentclass[border=10mm]{standalone}
\usepackage{tikz}\usetikzlibrary{calc}
\begin{document}\begin{tikzpicture}[x=1mm,y=1mm,font=\sffamily\small]
\draw[very thick] (0,0) -- (207.0,0.0) -- (206.7,17.8) -- (206.1,35.7) -- (205.2,53.6) -- (204.1,71.4) -- (202.8,89.2) -- (201.3,107.1) -- (199.6,124.9) -- (197.7,142.8) -- (195.6,160.6) -- (193.4,178.5) -- (191.0,196.4) -- (188.4,214.2) -- (185.7,232.1) -- (182.8,249.9) -- (179.8,267.8) -- (176.7,285.6) -- (173.4,303.4) -- (169.9,321.3) -- (166.4,339.1) -- (162.7,357.0) -- (158.8,374.9) -- (154.9,392.7) -- (150.8,410.5) -- (146.6,428.4) -- (142.2,446.2) -- (137.8,464.1) -- (133.2,482.0) -- (128.5,499.8) -- (123.6,517.6) -- (118.7,535.5) -- (113.6,553.4) -- (108.5,571.2) -- (103.2,589.0) -- (97.8,606.9) -- (92.2,624.8) -- (86.6,642.6) -- (80.9,660.5) -- (75.0,678.3) -- (69.1,696.1) -- (63.0,714.0) -- (0,714.0) -- cycle;
\draw[dashed] (0,0) -- (-25.0,0) -- (-25.0,714.0) -- (0,714.0);
\node[rotate=90,anchor=south] at (-12.5,357.0) {luff sleeve fold (25 mm)};
\draw[blue, thick] (4,178.5) -- (189.4,178.5) node[right,black] {batten 185 mm};
\draw[blue, thick] (4,357.0) -- (158.7,357.0) node[right,black] {batten 155 mm};
\draw[blue, thick] (4,535.5) -- (114.7,535.5) node[right,black] {batten 111 mm};
\node[anchor=north west] at (0,-3) {MAINSAIL 1:1  (foot 207 mm, luff 714 mm, head 63 mm)};
\draw[gray] (0,0.0) -- (207.0,0.0); \node[gray,anchor=west] at (209.0,0.0) {h=0: 207.0};
\draw[gray] (0,142.8) -- (197.7,142.8); \node[gray,anchor=west] at (199.7,142.8) {h=143: 197.7};
\draw[gray] (0,285.6) -- (176.7,285.6); \node[gray,anchor=west] at (178.7,285.6) {h=286: 176.7};
\draw[gray] (0,428.4) -- (146.6,428.4); \node[gray,anchor=west] at (148.6,428.4) {h=428: 146.6};
\draw[gray] (0,571.2) -- (108.5,571.2); \node[gray,anchor=west] at (110.5,571.2) {h=571: 108.5};
\draw[gray] (0,714.0) -- (63.0,714.0); \node[gray,anchor=west] at (65.0,714.0) {h=714: 63.0};
\draw[very thick] (430.0,0.0) -- (429.4,24.8) -- (428.8,49.5) -- (428.3,74.2) -- (427.7,99.0) -- (427.1,123.8) -- (426.5,148.5) -- (425.9,173.2) -- (425.4,198.0) -- (424.8,222.8) -- (424.2,247.5) -- (423.6,272.2) -- (423.0,297.0) -- (422.4,321.8) -- (421.9,346.5) -- (421.3,371.2) -- (420.7,396.0) -- (420.1,420.8) -- (419.5,445.5) -- (419.0,470.2) -- (418.4,495.0) -- (411.4,495.0) -- (405.7,470.2) -- (399.9,445.5) -- (394.2,420.8) -- (388.5,396.0) -- (382.8,371.2) -- (377.1,346.5) -- (371.3,321.8) -- (365.6,297.0) -- (359.9,272.2) -- (354.2,247.5) -- (348.5,222.8) -- (342.8,198.0) -- (337.0,173.2) -- (331.3,148.5) -- (325.6,123.8) -- (319.9,99.0) -- (314.2,74.2) -- (308.4,49.5) -- (302.7,24.8) -- (297.0,0.0) -- cycle;
\node[anchor=north west] at (297.0,-3) {JIB 1:1  (foot 133 mm, luff 508 mm)};
\draw[gray] (297.0,0.0) -- (430.0,0.0); \node[gray,anchor=west] at (432.0,0.0) {h=0: 133.0};
\draw[gray] (325.6,123.8) -- (427.1,123.8); \node[gray,anchor=west] at (429.1,123.8) {h=124: 101.5};
\draw[gray] (354.2,247.5) -- (424.2,247.5); \node[gray,anchor=west] at (426.2,247.5) {h=248: 70.0};
\draw[gray] (382.8,371.2) -- (421.3,371.2); \node[gray,anchor=west] at (423.3,371.2) {h=371: 38.5};
\draw[gray] (411.4,495.0) -- (418.4,495.0); \node[gray,anchor=west] at (420.4,495.0) {h=495: 7.0};
\draw[thick] (0,-15) -- (100,-15) node[midway,below] {scale check: this bar must measure 100 mm};
\end{tikzpicture}\end{document}
