fmaleev/RC-Foiling-Cat/manual_1m/sail_patterns_1m_1to1.pdf

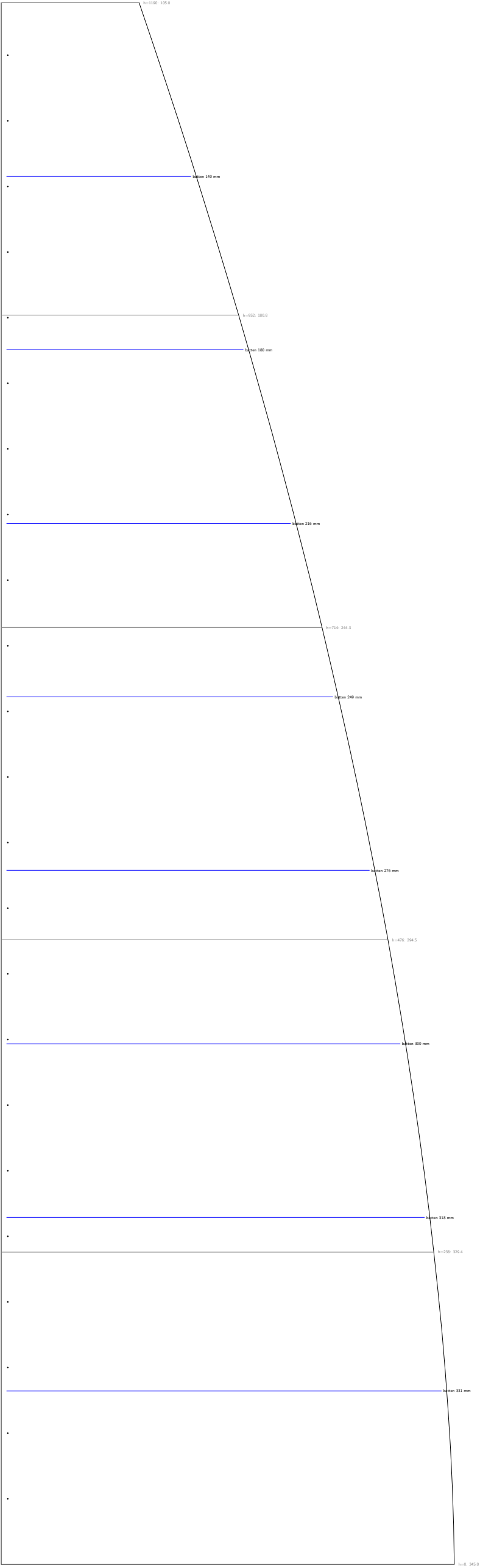
[picture p81: figure]
batten 331 mm; batten 318 mm; batten 300 mm; batten 276 mm; batten 249 mm; batten 216 mm; batten 180 mm; batten 140 mm

MAINSAIL 1:1 (foot 345 mm, luff 1190 mm, head 105 mm). The luff is laced to the wing mastś trailing edge: no allowance. Lacing holes (dots) every 50 mm, 5 mm in from the luff.

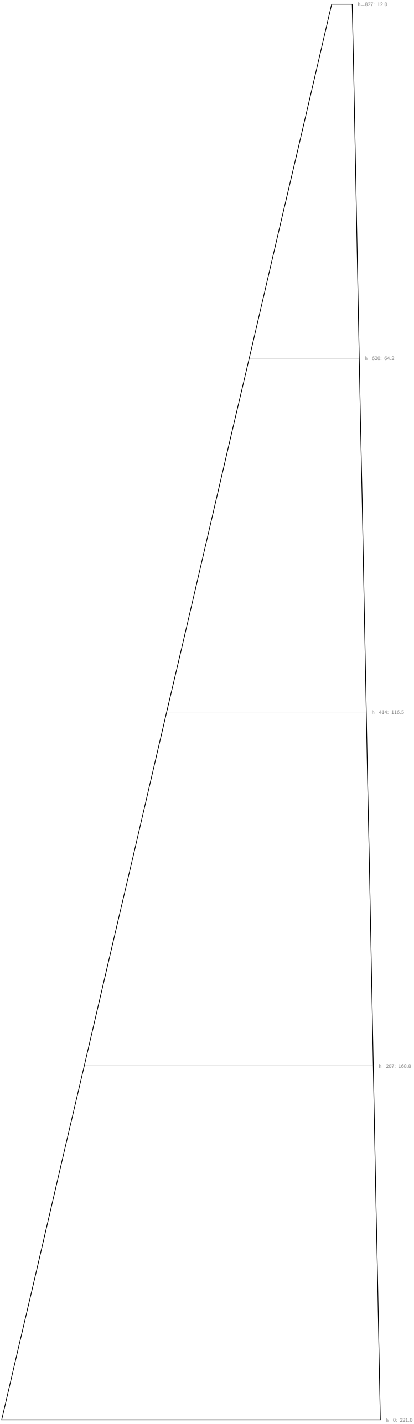
[picture p82: figure]

JIB 1:1 (foot 221 mm, luff 849 mm)

scale check: this bar must measure 100 mm
