fmaleev/RC-Foiling-Cat/mini/manual/sail_patterns_1to1.pdf

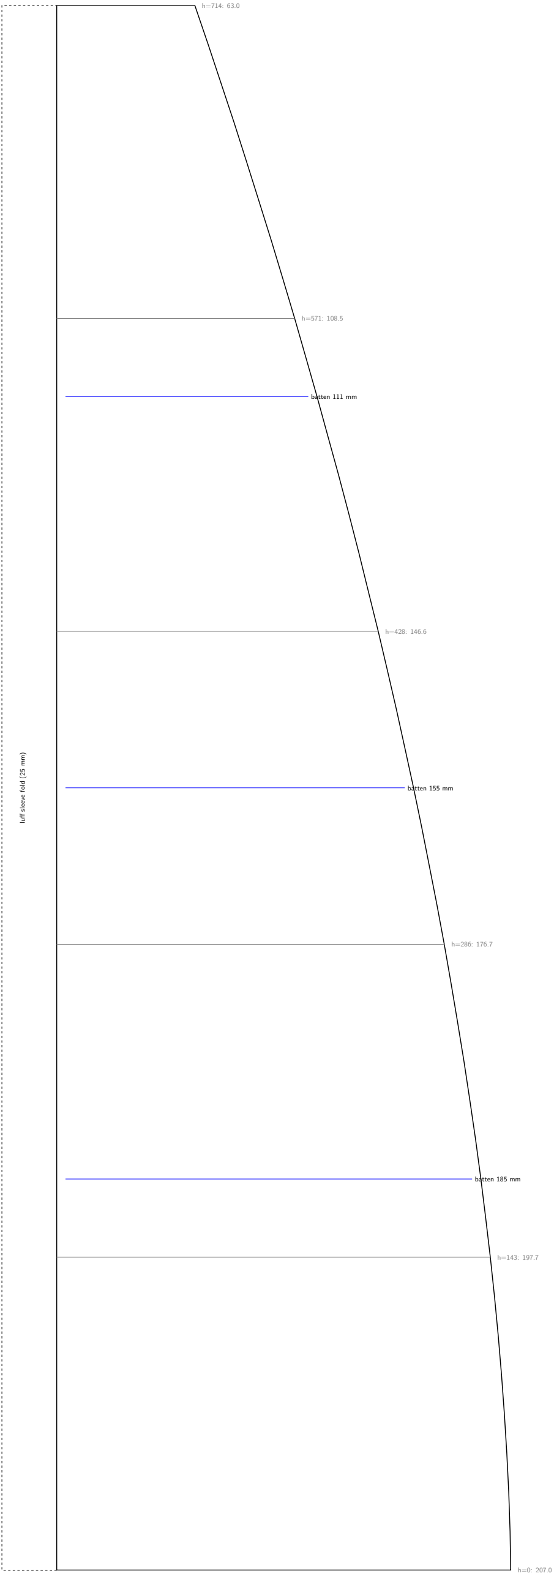
[picture p87: figure]
luff sleeve fold (25 mm); batten 185 mm; batten 155 mm; batten 111 mm

MAINSAIL 1:1 (foot 207 mm, luff 714 mm, head 63 mm)

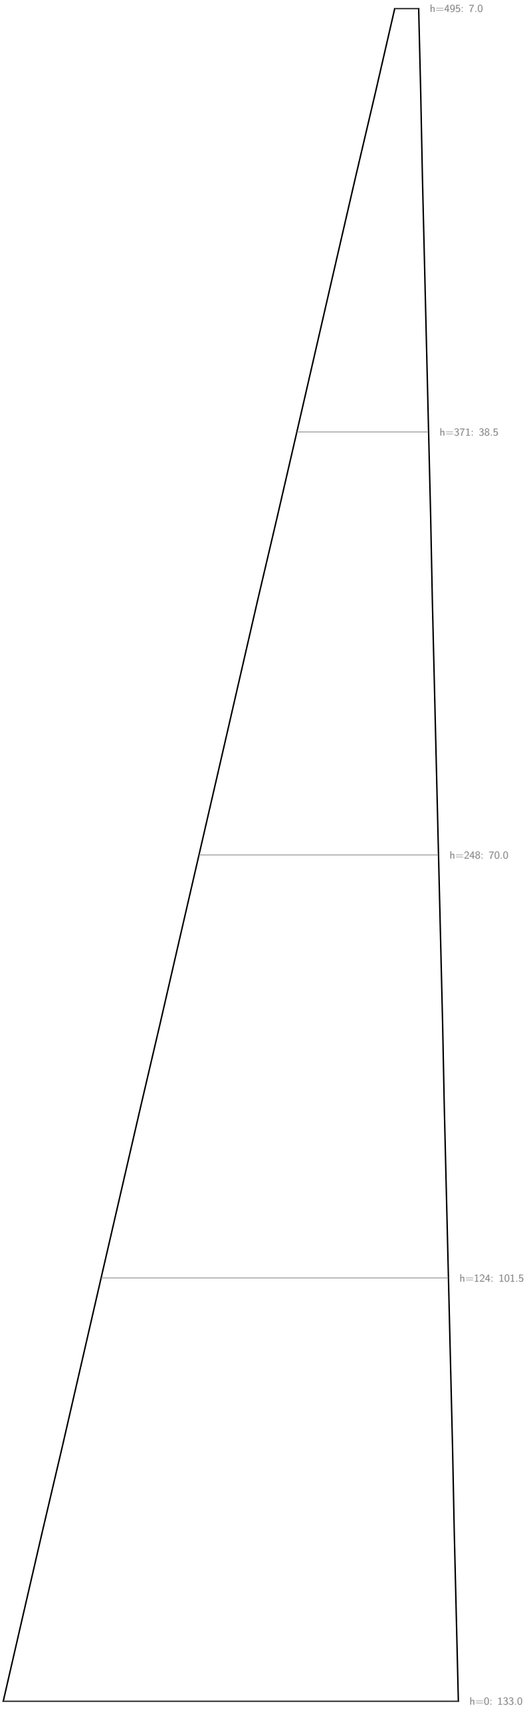
[picture p88: figure]

JIB 1:1 (foot 133 mm, luff 508 mm)

scale check: this bar must measure 100 mm
