fmaleev/RC-Foiling-Cat/images/build_first_v1.4_aft.png

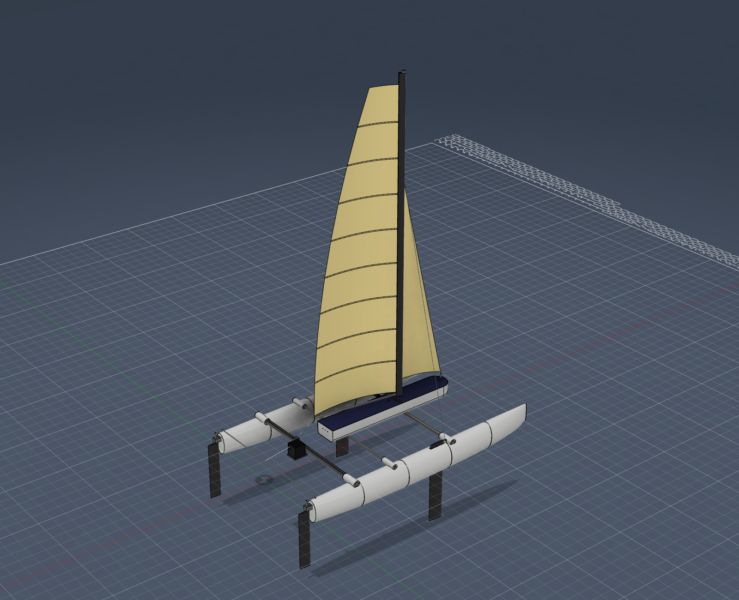
images/build_first_v1.4_aft.png
