fmaleev/RC-Foiling-Cat/testing/RC_Foiling_Cat_Tow_Test_Plan.pdf

## Tow-Test Plan for the 1 m Foiling Catamaran (v2.3 foils)

Filip Maleev

September 2026

## Purpose

The foiling version has only been analysed, not tested. This plan checks the numbers the design depends on before the boat sails on its foils: take-off speed, drag, pitch trim, flap angle and ride height, and whether the wand holds height without oscillating. Every prediction below comes from the same model as the paper (analysis/vpp.py, flying trim in heave and pitch) for the v2.3 foils in the CAD model. The pass bands are engineering judgment, not model outputs.
Towing replaces the sails. The tow force equals the drag, just as the sail drive does, and the height of the tow point sets the bow-down couple. Two tow points are used:
- A: at the sail’s centre of effort, a bridle on the mast 469 mm above its foot. This reproduces the couple the sails make, so the boat should trim as it would under sail (without heel).
- B: at the mast foot. The couple is much smaller.

The pitch difference between A and B measures the couple directly, which is the model’s largest uncertainty.

## 1. Bench checks (before the water)

1. Weight and balance. Fully rigged without sails but with sails, battery and radio installed: 2373 g. Balance point (centre of gravity) 454 mm forward of the transoms. Move the battery to correct it.
2. Foil angles, measured with a phone inclinometer against the deck: main wing +1.5

◦
, elevators
−0.5

◦
(nose down is negative).
3. Wand and flap. With the wand at 49◦ below the deck line (the design ride height, hinge 226 mm above the water), the flap should be at 0

◦
. Each degree of wand should move the flap 1.5◦

(wand down, flap down). Travel to both ±15◦ stops without binding.

4. Free play. Less than about 0.5
- at the flap when the wand is held still (judgment: play acts like a dead band in the height control).

## 2. Equipment

A tow line of 3–5 m with a weak link; a hanging scale with a 1–2 kg range and 5 g resolution in the line, filmed so the reading can be taken frame by frame; phone GPS for speed (average a steady 10 s run); a camera filming the boat side-on from the tow vehicle, with a 50 mm grid taped to the hull, for pitch and ride height; a bridle for tow point A. For speeds up to about 2 m/s a kayak works; above that, a bicycle on a straight towpath with a short outrigger pole, or a slow powerboat. Wear a buoyancy aid, and stay away from boat traffic.

## 3. Tow runs and predictions

Run each speed for at least 10 s after it settles, first at tow point A, then at B. Record the tow force, speed, pitch and bow height from the video, and whether the hulls are clear. Predictions (no side force, no heel):

Tow point A (sail centre of effort). Take-off at 1.81 m/s. Pitch nose up +; flap down +; bow height relative to the design ride height; elevator depth at its quarter chord.

Speed (m/s) State | Tow force (N) Pitch (◦
) | Flap (◦
) | Bow (mm) Elevator depth (mm)
1.5 | foils lifting (68 % of weight) | 3.6 | – | +15 (stop) | – | –
2.0 | flying | 3.6 | +0.4 | +7.8 | −20 | 89
2.5 | flying | 3.8 | +0.3 | +0.9 | −3 | 71
3.0 | flying | 4.4 | +0.1 | −2.4 | +5 | 59
3.5 | flying | 5.3 | −0.1 | −4.3 | +10 | 52
4.0 | flying | 6.3 | −0.2 | −5.4 | +13 | 47

Tow point B (mast foot). Take-off at 1.69 m/s.

Speed (m/s) State | Tow force (N) Pitch (◦
) | Flap (◦
) | Bow (mm) Elevator depth (mm)
1.5 | foils lifting (68 % of weight) | 3.6 | – | +15 (stop) | – | –
2.0 | flying | 3.4 | +2.5 | +0.7 | −11 | 119
2.5 | flying | 3.8 | +1.7 | −3.8 | +3 | 91
3.0 | flying | 4.4 | +1.2 | −6.1 | +10 | 75
3.5 | flying | 5.3 | +0.9 | −7.5 | +13 | 66
4.0 | flying | 6.3 | +0.7 | −8.3 | +16 | 60

Predicted pitch difference, A minus B: −2.2

- at 2.0 m/s, −1.4
- at 2.5 m/s, −1.1
- at 3.0 m/s, −1.0
- at
3.5 m/s, −0.9
- at 4.0 m/s.

## 4. Disturbance test

At 3 and 4 m/s (tow point A), push the bow down about 20 mm with a pole and let go, or tow across a small wake. The model predicts the height returns within 0.24–0.62 s with no overshoot (heave alone) and a coupled heave–pitch mode at 1.6–7.0 Hz that is well damped (damping ratio at least 0.69). A visible oscillation that keeps going (porpoising) is a failure.

## 5. Roll near take-off (under sail)

Straight towing does not load the foils sideways, so it cannot test roll. Near take-off both main wings are at their lift limit, and the leeward hull has to carry what the foils cannot of the sails’ heeling moment (the paper, Section 3.4). The model has the boat flying from 7.1 kn on a beam reach but only from 8.9 kn at 60◦

, where the side force is larger. Under sail at 60◦ , note the wind at which the leeward hull stops touching after the windward one lifts. Much earlier than predicted means the foils have more roll authority than modelled; much later points to the flap limit or to foil lift at low speed.

## 6. Pass bands and what to change

Pass bands (judgment): take-off speed within ±15 % of the prediction; tow force within ±30 %; pitch within ±1

◦
; flap within ±3

◦
; no sustained oscillation. The model gives the direction and size of each correction:
- Pitch off at speed: change the elevator angle. Pitch follows it one for one: each 0.5
- more
elevator nose-down brings the boat about 0.5
- more nose-down.
- Flap near a stop at speed: change the main-wing angle. The flap compensates by about
1/τ = 2.1
- per degree of wing (τ = 0.487 is the flap effectiveness).
- Take-off later than predicted: foil lift is lower than modelled (the sensitivity study with foil lift −20 % gives a later take-off). Add 0.5
- of main-wing angle.
- Pitch difference A−B much larger or smaller than predicted: the drag model, and so the couple, is off. Re-run analysis/pitch_trim.py with vpp.COUPLE_FACTOR fitted to the measured difference, then re-check the elevator angle.
- Porpoising: reduce the wand gearing (a shorter horn on the bellcrank), then re-check the height hold.
- Tow force much higher than predicted: look for flow separation or ventilation at the strut roots and the flap gaps before changing the foils.

## 7. Data sheet

Run Tow point Speed (m/s) Force (N) Pitch (◦ ) Bow (mm) Notes
