fmaleev/RC-Foiling-Cat/slides/charts/search.pdf

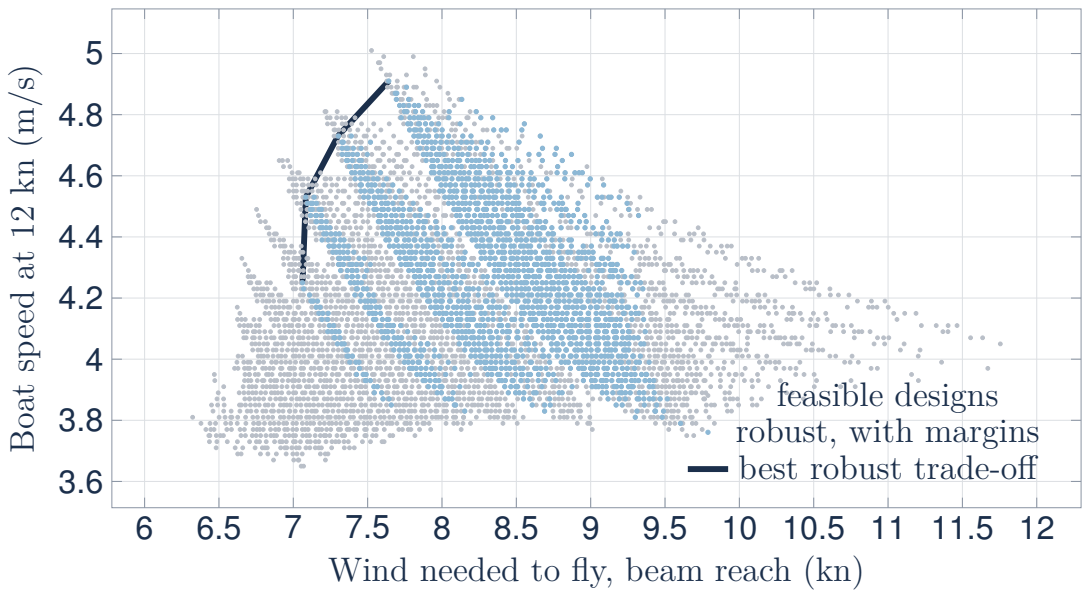
[picture p90: page 1]
feasible; designs

Boat speed at 12 kn (m/s)

robust, with margins
best robust trade-off

Wind needed to fly, beam reach (kn)
