fmaleev/RC-Foiling-Cat/slides/charts/takeoff.pdf

2.53

3.54

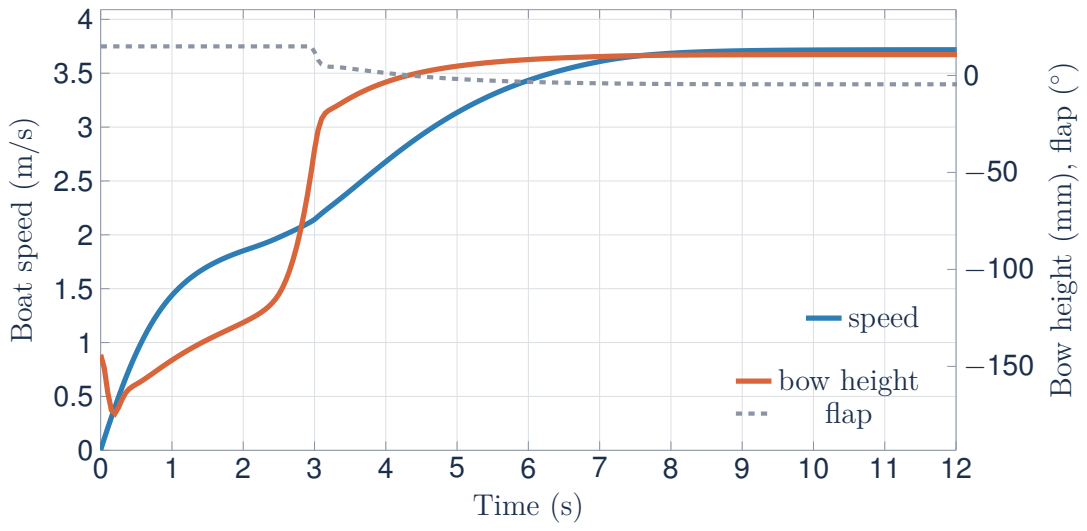
[picture p91: page 1]
Time (s); Boat speed (m/s)

Bow height (mm), flap (◦)

speed

bow height
flap
