fmaleev/RC-Foiling-Cat/(commit log)

2026-09-25 Initial import of the 1 m RC foiling catamaran project
    Fusion CAD scripts, analysis pipeline (VPP, flying trim, stability, structure),
    flight simulator and foil optimizer, paper, poster, build manuals and tow-test plan.
    Snapshot taken while the analysis pipeline re-runs with the roll model; the
    documents are rebuilt in a later commit.
    [Box_Half_1.stl, Box_Half_2.stl, Box_Lid_Half_1.stl, Box_Lid_Half_2.stl, Daggerboard_x2.stl, Elevator_Trim_Pod_x2.stl, Foil_Core_Elevator_x2.stl, Foil_Core_L_Port.stl]
2026-09-27 Printed rig fittings, laced luff, linkage details; hull table in the VPP
    - rig_fittings.py: gudgeons, T-rail traveler and jib tracks with end stops, bridle post,
    mast cap, hounds collar, wing-mast fairing shells (vase mode), gooseneck and boom jaw
    - fittings_geom.py: printed traveler and jib cars, built by the Sail Trim add-in
    - linkage.py: wand hinge, hub, bellcrank and flap horn (1.5 deg of flap per deg of wand)
    - Mass rules: fittings by volume; fairing weighed as printed; music wire as steel
    - VPP: hull resistance tabulated over load and speed and interpolated as in the simulator;
    sail easing searched only when needed; laminar foil friction as a sensitivity case
    - Manual, BOM and prin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
    [Bellcrank_Mount_x2.stl, Boom_Jaw.stl, Bridle_Post.stl, Flap_Horn_x2.stl, Foil_Core_L_Port.stl, Foil_Core_L_Stbd.stl, Gooseneck.stl, Gudgeon_x2.stl]
2026-09-27 Mainsheet 2:1 loads: 25 mm servo arm, stronger traveler car lips
    The mainsheet loop through the traveler car puts two parts between the car and the boom,
    so at servo stall the boom, car and rear beam carry twice the tail tension. structure.py
    now uses that purchase; with the tail 15 mm from the shaft the front beam (1.7) and mast
    (2.0) failed the factor-of-2 rule, so the tail moves to 25 mm. The rail stem is 0.6 mm
    taller so the car's lips are 1.6 mm (car check: 3.2x at stall, PETG strength assumed).
    Build-first doc gets the same fittings; deck gets a fittings slide.
    [Traveler_Car.stl, Traveler_Track_Centre.stl, Traveler_Track_Port.stl, Traveler_Track_Stbd.stl]
2026-09-27 Gooseneck carries the fork; trim sweep of the mast fittings
    A sweep that turns the gooseneck with the wing and the boom end with the boom (rig_fittings.mast_sweep)
    showed a boom-end fork below the boom would hit the jib car with the main eased and the jib in. The
    fork moves to the gooseneck; the boom end is a tongue within the boom's depth. The sweep also found
    the jib sheet crosses the boom itself with the jib fully in and the main past about 31 deg (manual note).
    Build-first CAD exports refreshed with the fittings.
    [Boom_Jaw.stl, Gooseneck.stl, RC_Catamaran_v1.4_Build_First_no_foils.f3d, RC_Catamaran_v1.4_Build_First_no_foils.step]
2026-09-27 v2.3 foils: loop closed after the mass correction; documents, deck and simulator rebuilt
    The corrected CAD masses moved the CG about 7 mm aft and cut the v2.2 foils' pitch static margin
    to 25 mm (limit 30). The search (sim/optimize.js) picked v2.3: wing 180 x 50 mm at +1.5 deg,
    elevators 160 x 28 mm at -0.5 deg, 18 mm lower. It is now in CAD (foils_v23.py, trim pods,
    linkage with the flap horn following the hinge, printable cores) and the rerun adopts it.
    VPP: take-off 1.81 m/s, flies from 7.11 kn on a beam reach and 8.95 kn at 60 deg, 4.53 m/s
    at 12 kn (simulator), static margin 41 mm.
    - optimize.js: v2.2 kept as a reference; the CAD adoption check now uses the same reference
    speed as th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
    [Elevator_Trim_Pod_x2.stl, Flap_Horn_x2.stl, Foil_Core_Elevator_x2.stl, Foil_Core_L_Port.stl, Foil_Core_L_Stbd.stl, Foil_Flap_x2.stl, Foiling_Kit_v2.3_carbon_parts_flaps_rudder_extensions.step, Foiling_Rudder_Extension_x2.stl]
2026-09-27 Every print part fits a 220 x 220 mm bed
    - print_splits.py: pod and lid in four pieces (cuts at x = 455, 600, 720 mm, clear of the servo
    rails and beam saddles); daggerboards and L-foil cores in two pieces joined inside the hull
    trunks; carbon rods bonded across the daggerboard joint, dowels and the foil caps across the
    core joint. One-piece STLs kept for larger printers.
    - structure.py: daggerboard joint check (9.8x at the heel limit); design_checks.py: joint rule
    and a 220 mm bed rule over the whole print list (30/30 pass)
    - BOM: a 1 m 1.2 mm carbon rod for the joint rods; it also covers the battens, which need
    2.01 m against the 2 m rod listed (build-first now $384.49)
    - Manual,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
    [Daggerboard_Lower_x2.stl, Daggerboard_Upper_x2.stl, Foil_Core_L_Port_Lower.stl, Foil_Core_L_Port_Upper.stl, Foil_Core_L_Stbd_Lower.stl, Foil_Core_L_Stbd_Upper.stl, Pod_Lid_Seg_1_x270_380.stl, Pod_Lid_Seg_1_x270_455.stl]
2026-10-01 Shopping list for all three stages; winch notes follow the rig model
    - bom/build_shopping_list.py -> RC_Catamaran_Shopping_List.pdf: stage totals (the Mini's radio
    and battery carried over to the 1 m boat), what is not priced (printer, charger, tools),
    orders grouped by store, every item with its listing and link
    - make_bom.py: the winch notes read the sheet and car travel from manual_data_1m.json
    (209 and 82 mm since the fittings, not 231 and 93)
    [bom_full_build_first.csv]
2026-10-03 Parts lists: prices re-checked 2026-10-04; recommended parts with alternatives and pros/cons
    - 30-minute epoxy is now the base (same price, strongest BSI epoxy per the maker); 5-minute listed
    as the faster alternative
    - 16 x 14 mm beam tubes from RMRC ($27.46, confirmed in stock); Wind Catcher ($16.28) kept as
    the cheaper option, but the site could not be reached to confirm it
    - eneloop pack from Walmart ($17.99, in stock); MicroBattery ($12.75) out of stock
    - sail tape re-read: 10 ft $6.50, half roll $9.65
    - waterproof EcoPower 640T stays an upgrade: its case does not fit the printed rails as drawn
    - bom_alternatives.csv replaces bom_mini_options.csv; shopping list, both manuals, paper,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
    [bom_alternatives.csv, bom_full_build_first.csv, bom_mini.csv, bom_mini_options.csv]
2026-10-03 Mini manual: diagrams for every build step (hulls, frame, steering, wiring, rig, mainsail, sheets)
2026-11-04 Add export_layout.py: body bounding boxes for the 1 m manual diagrams (not wired in yet)
